gbrangeon-telops/irc_fir-00251-proc/bin/FirmwareReleaseVersion.txt

firmwareVersionMajor=6
firmwareVersionMinor=2
firmwareVersionSubMinor=[SensorCode]
firmwareVersionBuild=0
