gbrangeon-telops/irc_fir-00251-proc/src/AEC/HDL/netlist/hdl_netlist/histogram_axis_tmi.runs/histogram_axis_tmi_blk_mem_gen_v8_1_0_synth_1/.vivado.begin.rst

<?xml version="1.0"?>
<ProcessHandle Version="1" Minor="0">
    <Process Command="vivado.bat" Owner="jboulet" Host="TELOPS182" Pid="135480">
    </Process>
</ProcessHandle>
