gbrangeon-telops/irc_fir-00251-proc/src/FrameBuffer/Doc/PDR - Réducteur de vitesse.pptx

On envisage ici 2 concepts de frame buffers :
Solution A (écriture en continu) : On écrit tous les frames qui arrivent et lorsque tous les slots du buffer sont pleines, on écrase le frame le plus ancien par le plus récent (aucun frame n’est jamais discarté).
- Avantage : Un avantage de cette solution est que la prochaine image affichée est toujours la plus récente sortie par le détecteur. Cet avantage devient perceptible seulement lorsque la vitesse d’écriture est beaucoup plus grande que celle de lecture.
- Désavantage : Un désavantage est qu’on est toujours en train d’écrire, ce qui accroit les besoins en bande passante de DDR et conséquemment la consommation d’énergie.
Solution B (écriture est “stallé” par la lecture) : On écrit tous les frames qui arrivent et lorsque tous les slots du buffer sont pleines, on discarte les nouveaux frames qui arrivent en attendant qu’une slot se libère.
  - Avantage : L’avantage par rapport à la solution A est qu’on prend moins de bande passante en écriture et qu’on consomme moins d’énergie parce que la vitesse de lecture fait “staller” l’écriture des frames.
  - Désavantage : Étant donné que les frames sont flushés lorsque tous les slots sont prises, il est possible d’introduire une latence sur l’affichage “real time” de la sortie video. Cette lantence devient perceptible seulement lorsqu’on est à bas frame rate et que la vitesse de lecture est beaucoup plus lente que celle d’écriture.

Dans le cadre du projet S2K, le frame buffer entre en function seulement lorsqu’on monte à des frame rates supérieur à 1000 Hz. Ce n’est pas grave d’avoir quelques frames de retard sur un preview à 1000 Hz et plus. On a donc choisi d’implementer la solution B afin de minimiser la consummation énergétique.

## Slide 2

Indépendamment de la solution, on considère un frame buffer d’une taille de trois frames. Voici la description d’un cas de figure permettant de constater pourquoi deux frames serait insuffisant :

Frame 0 (100%)

A

A

B

Frame 1 (100%)

B

B

A

Frame 0 (99%)

Le problème arrive lorsque la lecture est légèrement moins rapide que l’écriture.
Il y aura de long temps mort ou la lecture attend après l’écriture, ce qui affectera inutilement le throughput moyen en sortie du réducteur de vitesse.

Frame 2 (0%)

B

A

Frame 0 (1%)

Frame 2 (0%)

B

A

Frame 1 (99%)

Frame 3

A

B

Frame 1 (1%)

La lecture attend pendant presqu’un frame complet

Frame 3

A

B

## Slide 3

Solution A (écriture en continu) : Écriture environ 4x plus rapide que la lecture

Frame 0

Frame 1

Frame 2

Frame 3

Frame 4

Frame 5

Frame 6

Frame 7

Frame 8

Frame 9

Wait for SOF and read completion of current pointed buffer

Writing header and image in current pointed buffer

End of write operation

Update write pointer
and buffer status

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
## Slide 4

Solution B (écriture est “stallé” par la lecture) : Écriture environ 4x plus rapide que la lecture

Frame 0

Frame 1

Frame 2

Frame 3

Frame 4

Frame 5

Frame 6

Frame 7

Frame 8

Frame 9

Wait for SOF and read completion of current pointed buffer

Writing header and image in current pointed buffer

End of write operation

Update write pointer
and buffer status

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
## Slide 5

Interconnect
(Périphérique)

Bus AXI4

Architecture firmware (haut niveau)

µBlaze

Data Mover
(pixel data)

Data Mover
(buffering)

Data Mover
(Réducteurde vitesse)

Bus AXI4

Client 1

Interconnect
(MIG de calibration)

…

…

MM2S CMD (AXI4S, CLK_CAL)

MM2S (AXI4, CLK_CAL, 2720 MB/s)

Client 2

…

MM2S STS (AXI4S, CLK_CAL)

MM2S (AXI4S, CLK_CAL, 2720 MB/s)

…

MM2S CMD (AXI4S, CLK_DATA)

Bus AXI4

…

…

MM2S (AXI4S, CLK_DATA, 170 MB/s)

MM2S STS (AXI4S, CLK_DATA)

MM2S (AXI4, CLK_DATA, 170 MB/s)

Client 3

…

…

S2MM CMD (AXI4S, CLK_DATA)

Bus AXI

MIG
(calibration)

Address bus (15 bits)

Data bus

…

S2MM STS (AXI4S, CLK_DATA)

S2MM (AXI4S, CLK_DATA, 680 MB/s)

S2MM (AXI4, CLK_DATA, 680 MB/s)

Client 4

Réducteur de Vitesse

Storage

MM2S STS (AXI4S, CLK_DATA)

MM2S CMD (AXI4S, CLK_DATA)

MM2S (AXI4, CLK_DATA, 680 MB/s)

Client 5

MM2S (AXI4S, CLK_DATA, 680 MB/s)

DDR 3

Légende

Rouge = Ajout/modification
Bleu = existant

Définition des clocks

CLK_CAL = 170 MHz
CLK_DATA = 85 MHz
CLK_DIN = 142.5 MHz

S2MM STS (AXI4S, CLK_DIN)

S2MM CMD (AXI4S, CLK_DIN)

S2MM (AXI4S, CLK_DIN, 1140 MB/s)

S2MM (AXI4, CLK_DIN, 1140 MB/s)

Client 6

Output

Pixels stream
(AXI4S, CLK_DATA, 340 Mpix/s)

calibration

Pixels stream
(AXI4S, CLK_DATA, 340 Mpix/s)

Pixels stream
(AXI4S, CLK_DATA, 340 Mpix/s)

Pixels stream
(AXI4S, CLK_DIN, 569 Mpix/s)

HDER inserter

Pixels stream
(AXI4S, CLK_DIN, 569 Mpix/s)

Module FPA

mux

Pixels stream
(AXI4S, CLK_DATA, 85 Mpix/s)

Pixels stream
(AXI4S, CLK_DIN, 569 Mpix/s)

Fan out

Pixels stream
(AXI4S, CLK_DIN, 569 Mpix/s)

## Slide 6

Pixel out

Architecture firmware

Frame buffer/Réducteur de vitesse

Frame buffer configuration

Block design

Bus AXI4

µBlaze interface

Image boundaries
detector (SOF/EOF)

Read FSM

Buffers manager

Write FSM

Interconnect
(Peripheral)

Read engine
cmd intf

Write engine
cmd intf

Write engine

Read engine

Data mover

µBlaze

CFG

MM2S STS

MM2S DATA

CDC

Read buffers status

CDC

Update buffers status

CDC

Update RD buffer pointer

MM2S CMD

DDR 3

Data bus

CFG

Update WR buffer pointer

Address bus

CFG

Read buffers status

Update buffers status

S2MM CMD

MIG
(DDR calibration)

Bus AXI

Interconnect
(MIG CAL_DDR)

S2MM STS

Pixels stream

SOF/EOF

Multiple
stages
registers

Hole

Fanout
(pixel, storage)

Pixels stream

Pixels stream

Pixels stream

Pixels stream

WR FIFO

S2MM DATA

S2MM DATA

MM2S DATA

Legend (bus)

AXI4S, CLK_DATA

Legend (clock domain)

CLK_DIN (142.5 MHz)

CLK_DATA (85 MHz)

CLK_MB (100 MHz)

CLK_DDR (400 MHz)

AXI4S, CLK_DIN

AXI4, CLK_DATA

AXI4, CLK_DIN

AXI4, CLK_MB

MIXE
