gbrangeon-telops/irc_fir-00251-proc/bin/FirmwareReleaseList.txt

sensorName,fpgaSize (no spaces)
#are ignored
----------------------------------------------
#blackbird1280D,325
#blackbird1520D,325
#blackbird1920D,325
#calcium640D,325
#hawkA,160
#herculesD,160
isc0207A,160
isc0207A_3k,325
#isc0209A,160
#isc0804A,325
#isc0804A_500Hz,325
#isc0804A_2k,325
#pelicanD,160
#scorpiolwD_230Hz,160
#scorpiomwA,160
#scorpiomwA_300Hz,160
#startup,160
#startup,325
#startup_4DDR,325
#suphawkA,325
#xro3503A,325
