gbrangeon-telops/irc_fir-00251-proc/src/FPA/megalink/Doc/Chronogrammes.docx

Nous empruntons à SCD les chornogrammes suivants. Ils seront utilisés jusqu’à preuve du contraire pour tous les IDDCA numériques.

Ainsi, selon la figure 2 ci-dessus, et selon la doc du détecteur ScorpioLw (figure 5.2 page 15 de NTG018) , on a en mode ITR:

fig2_T4_dly = 2 MCLK (non documenté par Sofradir)

fig2_T6_dly = (6.5 + Ncolumn/4) MCLK pour scorpioLW et 40 MCLK pour Mars

fig2_T5_dly = 50 usec pour scorpioLW et

fig2_T3_dly = FVAL(à confirmer) = Fig4_T3_dly*NLine + Fig4_T4_dly*( NLine - 1)

Pour un ScorpioLW en mode ITR, on a :

Fig4_T1_dly = fig2_T2_dly + fig2_T4_dly + fig2_T6_dly; (pour un Scorpio LW)

Fig4_T2_dly = 0;

Fig4_T3_dly = Ncolumn/Ntaps;

Fig4_T4_dly = 4 MCLK;

Fig4_T5_dly = 0 MCLK (pas de header pour Megalink)

Fig4_T6_dly = 0
