gbrangeon-telops/irc_fir-00251-proc/design note/ElCorr/ElCorr.pdf

## Algorithme du correcteur électronique

Eric Larouche

27 mars 2024

# Table des matières

Bibliographie | 13

### 1 Introduction

Le correcteur électronique est un module firmware qui fut introduit dans le cadre du projet ForrestGump pour le détecteur isc0804A. À cette époque, il fut remarqué que la calibration permanente ne tenait plus adéquatement quand les conditions ambiantes de température changeaient trop pour la caméra M1k. Un effort de développement fut donc mené pour créer une nouvelle fonctionnalité firmware générique qui permet de corriger la drift thermique de l’électronique à l’ordre un : référé dans le firmware comme étant le "correcteur électronique" (ou ElCorr). Le module comporte une flexibilité par conception qui autorise divers modes de fonctionnement. Dans le moment, il est seulement activé concrètement pour le isc0804A (avec correction de gain/offset) et pour le isc0209A dans un sous-mode particulier.

Le module ElCorr s’insère dans le contrôleur générique du flot de données (afpa_data_ctrl) du module FPA, juste avant le traitement multiéchantillons (HPROC) et de la diversité spatiale (VPROC). Pour le reste de la chaîne de traitement de la caméra (calibration), c’est transparent : les données arrivent dans le mode RAW0 déjà corrigées pour la drift thermique.

1

Outre la compensation thermique active, le code du correcteur électronique inclut également la possibilité d’une transformation affine générique pour changement d’échelle de la plage dynamique avec des seuils explicites à viser pour ETmin et ETmax : référé dans le code comme étant les constantes
ELCORR_TARGET_STARVATION_DL et ELCORR_TARGET_SATURATION_DL respecti-
vement.

### 2 Modèle fondamental

L’algorithme de la correction électronique se base sur certaines hypothèses de modélisation raisonnables concernant les caractéristiques de la chaîne analogique de l’électronique instrumentale et l’effet des variations thermiques.

### 1. Hypothèse de linéarité

On suppose que l’électronique analogique pour un tap donné et le processus de conversion ADC peuvent se modéliser par une relation linéaire du type suivant :
y(t) = A(T) · x(t) + B(T)

où x(t) est la valeur de la tension (en mV) qui sort sur le tap au temps t au début de la chaîne analogique (plage native du ROIC), y(t) est la valeur numérique (en DL0) produite par l’ADC après conversion de la tension analoqique en fin de chaîne (dans la plage différentielle adaptée à l’ADC), A(T) et B(T) sont respectivement le gain et l’offset global dépendant de la température actuelle T.

Ce modèle revient donc à négliger toute non-linéarité introduite par l’électronique ou l’ADC mais autorise des variations de gain et d’offset causées par des drifts thermiques. C’est une hypothèse fort raisonnable étant donnée la très bonne linéarité des OpAmp et des convertisseurs ADC.

### 2. Hypothèse de l’existence de références

La deuxième hypothèse concerne la disponibilité de références qui permettent de caractériser l’évolution de la drift thermique pour calculer la correction à appliquer sur les données de pixel. Pour une compensation de gain et d’offset, cela prend deux références en tension sur le ROIC représentatives des perturbations que subiront les données de taps. Le processus qui

2

détermine le niveau nominal de ces références doit être stable en température.

Dans le cas du isc0804A, le niveau de blank peut servir de référence car il est ajustable. La tension est programmée par une paire DAC/LDO très stable en température (5 ppm/K). Une première référence (REF1) est prise durant la période de blank à chaque ligne. La deuxième référence (REF2) consiste en une valeur de DAC alternative programmée seulement au moment de changements de config FPA qui impliquent un stop/start. Le DAC reprend la valeur normale de REF1 dès que la mesure de REF2 est complétée. Ainsi, il y a une mise à jour régulière de REF1 mais plus infréquente pour REF2.

### 2. Hypothèse de lenteur de la dynamique

La troisième hypothèse concerne la lenteur des drifts thermiques. On suppose que la dynamique des effets thermiques est plutôt lente, à l’échelle de plusieurs minutes. C’est la raison pour laquelle on autorise que REF2 soit mesurée infréquemment.

### 3 Algorithme détaillé de correction

L’algorithme de correction qui se base sur les hypothèses de la section précédente utilise plusieurs constantes globales et variables par canal. L’information détaillée suit.

### 1. Constantes et variables

Quatre de ces constantes proviennent des Flash Settings mais peuvent être écrasées par un registre de debug :
ElCorrMeasAtReference1 REF1 mesuré (en DL0) au centre de l’image par la production en conditions de lab.
ElCorrMeasAtReference2 REF2 mesuré (en DL0) au centre de l’image par la production en conditions de lab.
ElCorrMeasAtStarvation Compte de pixel (en DL0) mesuré au centre de l’image par la production en conditions de lab à ETmin. ElCorrMeasAtSaturation Compte de pixel (en DL0) mesuré au centre de l’image par la production en conditions de lab à ETmax.

3

Deux des constantes provienent du code microBlaze et concernent les seuils à viser pour le correcteur électronique (transformation affine après compensation thermique) :
ELCORR_TARGET_STARVATION_DL Seuil à cibler (DL0) à ETmin. ELCORR_TARGET_SATURATION_DL Seuil à cibler (DL0) à ETmax. L’algorithme utilise également trois variables mesurées en temps réel en conditions d’opération "client" pour chaque tap :
Ref1 Valeur actuelle de REF1 (en DL0)
Ref2 Valeur actuelle de REF2 (en DL0)
PixData Valeur actuelle du pixel (en DL0)

### 2. Notation simplifiée

Introduisons une notation simplifiée pour décrire moins lourdement l’implémentation concrète de l’algorithme et l’algèbre qui en découle.
- Y

∗
R1

: constante ElCorrMeasAtRe f erence1
- Y

∗
R2

: constante ElCorrMeasAtRe f erence2
- Yminnom : constante ElCorrMeasAtStarvation
- Ymaxnom : constante ElCorrMeasAtSaturation
- Ymintar : constante ELCORR_TARGET_STARVAT ION_DL
- Ymaxtar : constante ELCORR_TARGET_SATURAT ION_DL
- YR1 : valeur actuelle de REF1 à l’entrée de ElCorr
- YR2 : valeur actuelle de REF2 à l’entrée de ElCorr
- Ypix : valeur actuelle du pixel à l’entrée de ElCorr
- Yout : valeur actuelle du pixel après correction électronique

### 3. Algèbre de l’algorithme

La transformation algébrique de la correction électronique poursuit le double objectif de compenser activement les drifts de gain et d’offset ainsi que de permettre une mise à l’échelle de la plage dynamique de manière arbitaire (selon les consignes des constantes Ymin/maxtar données plus haut). L’équation fondamentale est donnée ci-bas :

Yout =

Y

∗
R1 − Y

∗
R2
YR1 − YR2
·

Ymaxtar − Ymintar
Ymaxnom − Yminnom
- (Ypix − YR1)

−

Ymaxtar − Ymintar
Ymaxnom − Yminnom
- (Ymaxnom − Y

∗
R1

) + Ymaxtar.

(1)

4

Le facteur de la première parenthèse constitue une correction pour la variation de gain. Les offsets sont quant à eux compensés étant donné qu’on calcule des différences de grandeurs mesurées à une seule et même température commune. Le facteur dans la deuxième parenthèse constitue plutôt un redimensionnement d’échelle de la plage dynamique. Les expressions additives assurent qu’on a le bon décalage désiré avec les constantes-cibles données.

Avec cette algèbre, on aura bien Yout = Ymintar à ETmin et Yout = Ymaxtar à ETmax avec compensation de gain/offset.

### 4. Implémentation firmware

L’implémentation firmware est divisée en deux parties. Les calculs de constantes statiques qui ne demandent pas de mesure en temps réel sont faits dans le microBlaze. Plusieurs modes d’opération sont supportés par le firmware. Le code du processeur calcule les bonnes consignes/constantes selon le mode actuel.

La correction électronique proprement dite effectuée en temps réel est plutôt déléguée au datapath se trouvant dans le circuit numérique FPGA. Il traite les pixels selon les consignes d’aiguillage de flot de données et de constantes statiques déterminés par le software microBlaze. Cette flexibilité permet ainsi plusieurs modes d’opération. Notons l’affichage de la REF1 (mode = 1), l’affichage de la REF2 (mode=2), correction d’offset exclusivement (mode=5) et correction de gain/offset (mode=7) tel que décrit dans la mathématique ci-haut.

Pour la correction active, le processeur fournit à la partie FPGA une constante multiplicative et une constante additive calculées ainsi :

Again = (Y

∗
R1 − Y

∗
R2

) ·

Ymaxtar − Ymintar
Ymaxnom − Yminnom

Ao f f s = Ymaxtar − Again ·

Ymaxnom − Y

∗
R1
Y

∗
R1 − Y

∗
R2

Le datapath implémente les opérations arithmétiques nécessaires : soustraction, addition, multiplication et division. Les données initiales en provenance de l’ADC se trouvent en format point-fixe de 18-bits. La multiplication

5

génère un résultat sur une précision double : 36-bits. La division produit quant à elle un quotient sur 18-bits (dividende=36-bits, diviseur=18-bits). Chaque opérateur traite un lot de 4 pixels en parallèle (données en provenance d’un quad ADC).

La structure précise du datapath se présente ainsi :

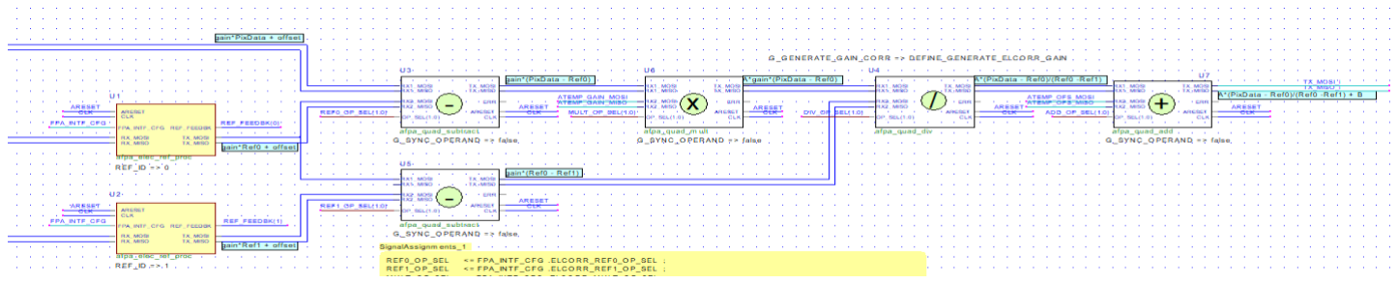
[picture p5: figure]

FIGURE 1 – Datapath

Dans le mode d’opération normal (ELCORR_MODE_OFFSET_AND_GAIN_CORR), le datapath calcule donc l’expression suivante :

Yout = Again ·

Ypix − YR1

YR1 − YR2

+ Ao f f s

Pour plus de flexibilité, les opérateurs du datapath reçoivent un sélecteur d’aiguillage en provenance du processeur qui permet d’implémenter plusieurs modes de calcul différents. Outre le mode normal actif (l’opérateur effectue l’opération mathématique native), on peut sélectionner un mode passage transparent de l’opérande 1 ou passage de l’opérande 2.

Ainsi, avec la bonne configuration appropriée, on peut demander par exemple au correcteur électronique de passer vers la sortie la REF1 ou la REF2 de manière transparente sans transformation afin de debug. (Cela
correspond aux modes ELCORR_MODE_REF1_IMG et ELCORR_MODE_REF2_IMG
respectivement.)

### 5. Analyse de la propagation d’incertitude

Dans cette sous-section, nous analysons la propagation de l’incertitude causée par l’algorithme de la correction électronique et l’impact du changement du niveau nominal de blank (projet M2kUD).

6

Loi de propagation de l’incertitude Rappelons ici la loi de propagation de l’incertitude d’un mesurande Y de sortie qui dépend de plusieurs autres quantitées Xi selon une relation fonctionnelle déterminée (refs [1], [2] et [3]).

Étant donnée la relation fonctionnelle suivante entre les mesurandes :

Y = f(X1, X2, . . . , XN),

un estimé de la mesure de sortie y est obtenu par substitution direct des estimés des variables d’entrée xi pour les mesurandes Xi
:

y = f(x1, x2, . . . , xn).

Dans ce cas, l’incertitude sur le résultat de sortie u(y) se propagera selon la loi suivante :

u

2
(y) =

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
(xi) + 2

N−1
∑

i=1

N
∑

j=i+1

∂ f
∂xi

∂ f
∂xj

u(xi

, xj),

où u(xi) est l’estimé d’incertitude associé à l’entrée xi et u(xi

, xj) est l’estimé
de covariance associé au couple d’entrées xi et xj

Dans notre cas, il est raisonnable de supposer qu’il n’y a pas de corrélation entre les différentes variables d’entrée (PixData et les différents REFs) comme l’incertitude de mesure est surtout causée par du bruit électronique blanc additionné d’un bruit de quantification de conversion ADC.

Avec cette hypothèse simplificatrice, la loi de propagation de l’incertitude peut se réécrire ainsi :

u(y) =

vuut
N
∑

i=1

∂ f
∂xi

2
u
2(xi). | (2)

Facteurs de sensibilité Il faut appliquer cette loi à l’équation (1) pour obtenir l’erreur en sortie du correcteur électronique. Pour ce faire, il reste à déterminer les différents facteurs de sensibilité ∂ f
∂xi

qui découle de l’équa-

7

tion (1). Après calculs symboliques appropriés, nous obtenons :

∂Yout
∂Y

∗
R1

=

Ymaxtar − Ymintar
Ymaxnom − Yminnom
·

Ypix − YR2

YR1 − YR2

∂Yout
∂Y

∗
R2

= −

Ymaxtar − Ymintar
Ymaxnom − Yminnom
·

Ypix − YR1

YR1 − YR2

∂Yout

∂YR1

= −

Ymaxtar − Ymintar
Ymaxnom − Yminnom
·
Y

∗
R1 − Y

∗
R2
(YR1 − YR2)

2

- (Ypix − YR2)

∂Yout

∂YR2

=

Ymaxtar − Ymintar
Ymaxnom − Yminnom
·
Y

∗
R1 − Y

∗
R2
(YR1 − YR2)

2

- (Ypix − YR1)

∂Yout
∂Yminnom

= −

Ymaxtar − Ymintar
(Ymaxnom − Yminnom)

2

- (Ymaxnom − Y

∗
R1

)

+

Ymaxtar − Ymintar
(Ymaxnom − Yminnom)

2

·
Y

∗
R1 − Y

∗
R2
YR1 − YR2
- (Ypix − YR1)

∂Yout
∂Ymaxnom

= −

Ymaxtar − Ymintar
Ymaxnom − Yminnom

+

Ymaxtar − Ymintar
(Ymaxnom − Yminnom)

2

- (Ymaxnom − Y

∗
R1

)

−

Ymaxtar − Ymintar
(Ymaxnom − Yminnom)

2

·
Y

∗
R1 − Y

∗
R2
YR1 − YR2
- (Ypix − YR1)

∂Yout
∂Ypix =
Y

∗
R1 − Y

∗
R2
YR1 − YR2
·

Ymaxtar − Ymintar
Ymaxnom − Yminnom

Évaluation quantitative Avec ces expressions en main, on peut procéder à l’évaluation quantitative. Pour les données de pixels, nous connaissons déjà l’incertitude de notre chaîne analogique : 1.7 DL0 (rms). Les mesures nominales de pixel à ETmin et ETmax peuvent être moyennées sur plusieurs images avec une séquence. Le script standard GSY utilise 64 images comme compte. Concernant les mesures des références, il faut tenir compte du fait que le correcteur électronique applique une moyenne mobile sur 120 échantillons. L’incertitude pour celles-ci se réduira donc selon la loi de 1/√
N.

Caméra M1k Évaluation d’abord la caméra M1k standard qui constitue le cas de baseline. Nous avons pour les incertitudes d’entrées :

u(Ypix) = 1.7 DL0,

8

u(Yminnom) = u(Ymaxnom) = 1.7 DL0
√
64

= 0.21 DL0,

u(YR1) = u(YR1) = u(Y

∗
R2

) = u(Y

∗
R2

) = 1.7 DL0
√
120

= 0.16 DL0.

Pour Ymintar et Ymaxtar, il n’y a pas d’incertitude car ce sont des constantes fixes de design. Pour les différents paramètres, considérons les valeurs typiques suivantes :
Y

∗
R1 ≈ YR1 ≈ 7800 DL0,

Y

∗
R2 ≈ YR2 ≈ 400 DL0,

Yminnom ≈ 1300 DL0,

Ymaxnom ≈ 15 500 DL0,

Ymintar = 650 DL0 (par design),

Ymaxtar = 16 000 DL0 (par design),

Ypix = 15 500 DL0 (pire cas),

L’évaluation des facteurs de sensibilité donne :

∂Yout
∂Y

∗
R1

= 2.21, ∂Yout
∂Y

∗
R2

= −1.12, ∂Yout

∂YR1

= −2.21, ∂Yout

∂YR2

= 1.13,

∂Yout
∂Yminnom

= −1.11 × 10⁻¹⁶
,

∂Yout
∂Ymaxnom

= −1.08, ∂Yout ∂Ypix = 1.08.

En remplaçant les différentes valeurs dans l’équation (2), nous obtenons l’incertitude finale dans le pire cas (Ypix = 15500) :

u = 1.9 DL0.

Il rest intéressant de faire un graphe de l’évolution de l’incertitude sur toute la plage dynamique des pixels. On peut constater (voir fig. 2) qu’elle demeure autour de 1.9 DL0.

9


FIGURE 2 – Évolution de l’incertitude pour la caméra M1k

Caméra M2kUD Évaluons ici les quantités équivalentes pour la caméra M2kUD. Nous avons pour les incertitudes d’entrées :

u(Ypix) = 1.7 DL0,

u(Yminnom) = u(Ymaxnom) = 1.7 DL0
√
64

= 0.21 DL0,

u(YR1) = u(YR1) = u(Y

∗
R2

) = u(Y

∗
R2

) = 1.7 DL0
√
120

= 0.16 DL0.

Pour les différents paramètres M2kUD, nous avons les valeurs typiques suivantes :
Y

∗
R1 ≈ YR1 ≈ 4200 DL0,

Y

∗
R2 ≈ YR2 ≈ 400 DL0,

Yminnom ≈ 1300 DL0,

Ymaxnom ≈ 15 500 DL0,

Ymintar = 650 DL0 (par design),

Ymaxtar = 16 000 DL0 (par design),

Ypix = 8191 DL0 (pire cas),

10

Le projet M2kUD a introduit un changement de la référence 1 qui constitue le nouveau niveau de blank. Également, un module d’écrétage fut ajouté, ce qui implique que le pixel à saturation se situera maintneant à la demie-plage (8191 DL0).

L’évaluation des facteurs de sensibilité de M2kUD donne :

∂Yout
∂Y

∗
R1

= 2.22, ∂Yout
∂Y

∗
R2

= −1.14, ∂Yout

∂YR1

= −2.22, ∂Yout

∂YR2

= 1.14

∂Yout
∂Yminnom

= −0.556, ∂Yout
∂Ymaxnom

= −0.525, ∂Yout
∂Ypix = 1.08.

En remplaçant les différentes valeurs dans l’équation (2), nous obtenons l’incertitude finale dans le pire cas (Ypix = 8191) :

u = 1.9 DL0.

Nous pouvons afficher l’évolution de l’erreur pour la caméra M2kUD (voir fig. 3). Nous constatons encore une fois que l’inceritude demeure autour de 1.9 DL0. Il n’y a donc pas de dégradation significative de l’incertitude. Le déplacement de REF1 semble donc compensé par le fait que les pixels qui arrivent auront également un range dynamique diminué.

L’évaluation de l’inceritude pour un pixel pleine plage brute (Ypix = 15 500 DL0) montre effectivement une erreur théorique acrrue : u = 2.2 DL0. Mais cette situation n’arrivera pas en pratique comme l’écrêteur va forcer le client à ramener le ET à la demie-plage pour éviter des saturations ou sinon ces pixels seraient écrêtés de toute manière.

11


FIGURE 3 – Évolution de l’incertitude pour la caméra M2kUD

### 4 Conclusion

Le correcteur électronique est un module firmware fort utile qui a rendu possible les produits M1k, V500 et M2kUD. Avec sa grande versatilité, il pourra certainement servir pour d’autres détecteurs qui auront besoin d’une compensation active.

12

# Bibliographie

[1] Barry N. Taylor and Chris E. Kuyatt, Guidelines for Evaluating and Expressing the Uncertainty of NIST Measurement Results, NIST Technical Note 1297, 1994 Edition, Gaithersburg, MD, 1994.
[2] European Accreditation Laboratory Committee, Evaluation of the Uncertainty of Measurement in Calibration, EA-4/02 Technical Publication, 2013 Edition, Europe, 2013.
[3] John R. Taylor, Introduction to Error Analysis : The Study of Uncertainties in Physical Measurements, University Science Books, Melville, NY, 2nd Edition, 1997.

13
