gbrangeon-telops/irc_fir-00251-proc/src/Buffering/Docs/test_result.xlsx

 | Paramètre |  |  |  |  |  |  |  |  |  | Expected Result |  |  |  | Actual Result
Test | F_Width | F_Heigth | Nb_img_seq | Nb_seq | Pre_moi | Post_moi | Moi Loc | M position |  | Acq Stop Loc | Start_Loc | Moi Loc | End Loc | Seq ID | Start_Loc | Moi Loc | End Loc | Seq ID
#1 | 64 | 6 | 10 | 4 | 5 | 5 | 5 Frame | 5 | 12us | - | 0 | 5 | 9 | 0 | 0 | 5 | 9 | 0 | k
#2 | 64 | 6 | 10 | 4 | 5 | 5 | 3 Frame | 13 | 22us | - | 0 | 3 | 9 | 1 | 0 | 3 | 9 | 1 | k
#3 | 64 | 6 | 10 | 4 | 5 | 5 | 12 Frame | 30 | 45us | - | 7 | 2 | 6 | 2 | 7 | 2 | 6 | 2 | k
#4 | 64 | 6 | 10 | 4 | 5 | 5 | - | - | - | 1 | - | - | - | - | - | - | - | - | k
#5 | 64 | 6 | 10 | 4 | 5 | 5 | - |  | 52us | 1 | - | - | - | - | 3 | 8 | 1 | 3 | k
#6 | 64 | 6 | 10 | 4 | 0 | 10 | 0 | 0 | 6.4us | - | 0 | 0 | 9 | 0 | 0 | 0 | 9 | 0 | k
#7 | 64 | 6 | 10 | 4 | 0 | 10 | 4 |  | 22.8us |  | 0 | 0 | 9 | 1 | 4 | 4 | 3 | 1 | k
#8 | 64 | 6 | 10 | 4 | 9 | 1 | 5 |  | 12us |  | 0 | 5 | 9 | 0 | 0 | 5 | 9 | 0 | k
#9 | 64 | 6 | 10 | 4 | 9 | 1 | x frame |  | 22us |  | 3 | 2 | 2 | 1 | 3 | 2 | 2 | 1 | k
#10 | 64 | 6 | 10 | 2 | 2 | 8
#11 | 64 | 6 | 10 | 2 | 2 | 8
#12 | 64 | 6 | 10 | 2 | 2 | 8 |  |  |  |  | - | - | - | -
#13
#14
#15
