gbrangeon-telops/irc_fir-00251-proc/src/Calibration/Doc/CAL_status_decode.xlsm

Register | Error hex | Bit # | Error | Description | Bit # | Error | Description | Bit # | Error | Description | Bit # | Error | Description | Bit # | Error | Description
cal.error_set[0] | 00000000 | 0 | 0 | Saturation param fifo overflow (U45) | 32 | 0 | NLC/U15/U2 lut_factor_inv_err overflow | 64 | 0 | FSU/subtract (kappa+beta0) N/A (U2/U1) | 96 | 0 | RQC/add (B) sync error (U4/U8) | 128 | 0 | FCC/mult (NUC factor) N/A (U1/U2)
cal.error_set[1] | 00000000 | 1 | 0 | Pixel saturation flag error (U39) | 33 | 0 | NLC/U15/U2 lut_factor_err overflow | 65 | 0 | FSU/subtract (kappa+beta0) sync error (U2/U1) | 97 | 0 | RQC/lut_page_param_fifo (U4/U10) | 129 | 0 | FCC/mult (NUC factor) sync error (U1/U2)
cal.error_set[2] | 00000000 | 2 | 0 | NLC/subtract (offset) underflow (U3/U1) | 34 | 0 | NLC/U15/U2 lut_end_add_err overflow | 66 | 0 | FSU/add (alpha_offset) underflow (U2/U18) | 98 | 0 | RQC/pow2_m_exp_param_fifo (U4/U1) | 130 | 0 | FCC/exp_time_param_fifo (U1/U14)
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
