gbrangeon-telops/irc_fir-00251-proc/src/AEC/HDL/netlist/hdl_netlist/histogram_axis_tmi.srcs/sources_1/ip/histogram_axis_tmi_c_addsub_v12_0_0/doc/c_addsub_v12_0_changelog.txt

2013.4:
 * Version 12.0 (Rev. 3)
 * Latency is now restricted to the output width. Previously the GUI allowed illegal values
 * Tooltips added to GUI
 * Support for Kintex Ultrascale devices at Pre-Production Status

2013.3:
 * Version 12.0 (Rev. 2)
 * Behavioral VHDL model replaced by Encrypted RTL. For more information on this change please refer to the Migrating and Upgrading section in the Product Guide
 * Internal standardization in source file delivery, does not change behavior
 * Support for Automotive Artix-7, Automotive Zynq, Defense Grade Artix-7, Defense Grade Zynq and Lower Power Artix-7 devices at Production Status
 * Added default constraints for out of context flow
 * Added support for IP Integrator
 * Added support for Cadence IES and Synopsys VCS simulators

2013.2:
 * Version 12.0 (Rev. 1)
 * Support for Series 7 devices at Production status
 * Updated clock and bus interface associations for IP Integrator support
 * Removing support for Defense Grade Low Power Artix7

2013.1:
 * Version 12.0
 * Native Vivado Release
 * Changed all port names to upper case
 * There have been no functional changes to this IP.  The version number has changed to support unique versioning in Vivado starting with 2013.1.

(c) Copyright 2002 - 2013 Xilinx, Inc. All rights reserved.

This file contains confidential and proprietary information
of Xilinx, Inc. and is protected under U.S. and
international copyright and other intellectual property
laws.

DISCLAIMER
This disclaimer is not a license and does not grant any
rights to the materials distributed herewith. Except as
otherwise provided in a valid license issued to you by
Xilinx, and to the maximum extent permitted by applicable
law: (1) THESE MATERIALS ARE MADE AVAILABLE "AS IS" AND
WITH ALL FAULTS, AND XILINX HEREBY DISCLAIMS ALL WARRANTIES
AND CONDITIONS, EXPRESS, IMPLIED, OR STATUTORY, INCLUDING
BUT NOT LIMITED TO WARRANTIES OF MERCHANTABILITY, NON-
INFRINGEMENT, OR FITNESS FOR ANY PARTICULAR PURPOSE; and
(2) Xilinx shall not be liable (whether in contract or tort,
including negligence, or under any other theory of
liability) for any loss or damage of any kind or nature
related to, arising under or in connection with these
materials, including for any direct, or any indirect,
special, incidental, or consequential loss or damage
(including loss of data, profits, goodwill, or any type of
loss or damage suffered as a result of any action brought
by a third party) even if such damage or loss was
reasonably foreseeable or Xilinx had been advised of the
possibility of the same.

CRITICAL APPLICATIONS
Xilinx products are not designed or intended to be fail-
safe, or for use in any application requiring fail-safe
performance, such as life-support or safety devices or
systems, Class III medical devices, nuclear facilities,
applications related to the deployment of airbags, or any
other applications that could lead to death, personal
injury, or severe property or environmental damage
(individually and collectively, "Critical
Applications"). Customer assumes the sole risk and
liability of any use of Xilinx products in Critical
Applications, subject only to applicable laws and
regulations governing limitations on product liability.

THIS COPYRIGHT NOTICE AND DISCLAIMER MUST BE RETAINED AS
PART OF THIS FILE AT ALL TIMES.
