gbrangeon-telops/irc_fir-00251-proc/aldec/compile.cfg

[View]
Entity=
Architecture=
TopLevelType=
[file:.\compile\fir_00251_top.vhd]
Generated=TRUE
[file:.\compile\mgt_block.vhd]
Generated=TRUE
Enabled=1
[file:.\compile\mgt_wrapper.vhd]
Generated=TRUE
Enabled=1
[file:.\compile\serdes_top_3ch.vhd]
Generated=TRUE
[file:.\compile\USB_CTRL.vhd]
Generated=TRUE
Enabled=1
[file:.\compile\FPGA_COMM.vhd]
Generated=TRUE
[file:.\compile\data_mgt_tb.vhd]
Generated=TRUE
[file:.\compile\AXI4_Stream32_to_64_tb.vhd]
Generated=TRUE
[file:.\..\..\FIR-00251-Common\VHDL\tel2000pkg.vhd]
Enabled=1
[file:.\..\src\mgt\Hdl\data_mgt_cdc_sync_exdes.vhd]
Enabled=1
[file:.\..\src\mgt\Hdl\data_mgt_clock_module.vhd]
Enabled=1
[file:.\..\src\mgt\Hdl\data_mgt_gt_common_wrapper.vhd]
Enabled=1
[file:.\..\src\mgt\Hdl\data_mgt_support_reset_logic.vhd]
Enabled=1
[file:.\..\src\mgt\Hdl\exp_mgt_cdc_sync_exdes.vhd]
Enabled=1
[file:.\..\src\mgt\Hdl\exp_mgt_clock_module.vhd]
Enabled=1
[file:.\..\src\mgt\Hdl\exp_mgt_gt_common_wrapper.vhd]
Enabled=1
[file:.\..\src\mgt\Hdl\exp_mgt_support_reset_logic.vhd]
Enabled=1
[file:.\..\src\mgt\Hdl\mgt_ctrl.vhd]
Enabled=1
[file:.\..\src\mgt\Hdl\mgt_block.bde]
Enabled=1
[file:.\..\..\FIR-00251-Common\VHDL\MGT\Hdl\compile_data_mgt_rtl.do]
Enabled=1
[file:.\..\..\FIR-00251-Common\VHDL\MGT\Hdl\compile_exp_mgt_rtl.do]
Enabled=1
[file:.\..\..\FIR-00251-Common\VHDL\MGT\Hdl\compile_video_mgt_rtl.do]
Enabled=1
[file:.\..\..\FIR-00251-Common\VHDL\MGT\Hdl\data_mgt_cdc_sync_exdes.vhd]
Enabled=1
[file:.\..\..\FIR-00251-Common\VHDL\MGT\Hdl\data_mgt_clock_module.vhd]
Enabled=1
[file:.\..\..\FIR-00251-Common\VHDL\MGT\Hdl\data_mgt_gt_common_wrapper.vhd]
Enabled=1
[file:.\..\..\FIR-00251-Common\VHDL\MGT\Hdl\data_mgt_support_reset_logic.vhd]
Enabled=1
[file:.\..\..\FIR-00251-Common\VHDL\MGT\Hdl\exp_mgt_cdc_sync_exdes.vhd]
Enabled=1
[file:.\..\..\FIR-00251-Common\VHDL\MGT\Hdl\exp_mgt_clock_module.vhd]
Enabled=1
[file:.\..\..\FIR-00251-Common\VHDL\MGT\Hdl\exp_mgt_gt_common_wrapper.vhd]
Enabled=1
[file:.\..\..\FIR-00251-Common\VHDL\MGT\Hdl\exp_mgt_support_reset_logic.vhd]
Enabled=1
[file:.\..\..\FIR-00251-Common\VHDL\MGT\Hdl\mgt_block.bde]
Enabled=1
[file:.\..\..\FIR-00251-Common\VHDL\MGT\Hdl\mgt_ctrl.vhd]
Enabled=1
[file:.\..\..\FIR-00251-Common\VHDL\MGT\Hdl\mgt_wrapper.bde]
Enabled=1
[file:.\..\..\FIR-00251-Common\VHDL\IP\AXI4_Stream32_to_64\AXI4_Stream32_to_64_funcsim.vhdl]
Enabled=1
[file:.\..\..\FIR-00251-Common\VHDL\IP\AXI4_Stream32_to_64\AXI4_Stream32_to_64_wrapper.vhd]
Enabled=1
[file:.\..\..\FIR-00251-Common\VHDL\IP\AXI4_Stream64_to_32\AXI4_Stream64_to_32_wrapper.vhd]
Enabled=1
[file:.\..\..\FIR-00251-Common\VHDL\IP\AXI4_Stream64_to_32\AXI4_Stream64_to_32_funcsim.vhdl]
Enabled=1
[file:.\src\Testbench\IP\AXI4_Stream64_to_32\AXI4_Stream64_to_32_runtest.do]
Enabled=1
[file:.\src\Testbench\IP\AXI4_Stream64_to_32\AXI4_Stream64_to_32_stim.vhd]
Enabled=1
[file:.\src\Testbench\IP\AXI4_Stream64_to_32\AXI4_Stream64_to_32_tb.bde]
Enabled=1
[file:.\src\Testbench\IP\AXI4_Stream64_to_32\AXI4_Stream64_to_32_wave.do]
Enabled=1
[file:.\compile\AXI4_Stream64_to_32_tb.vhd]
Generated=TRUE
Enabled=1
[file:.\src\Testbench\IP\MGT_wrapper\mgt_wrapper_stim.vhd]
Enabled=1
[file:.\src\Testbench\IP\MGT_wrapper\MGT_WRAPPER_TB.bde]
Enabled=1
[file:.\compile\MGT_WRAPPER_TB.vhd]
Generated=TRUE
Enabled=1
[file:.\..\..\FIR-00251-Common\VHDL\MGT\Hdl\compile_mgt_wrapper.do]
Enabled=1
[file:.\..\IP\AXI4_Stream32_to_64\AXI4_Stream32_to_64_funcsim.vhdl]
Enabled=1
[file:.\..\src\BD\bd_wrapper.vhd]
Enabled=1
[file:.\..\xilinx\fir_0251_Proc.srcs\sources_1\bd\core\hdl\core_wrapper.vhd]
Enabled=1
[file:.\..\xilinx\fir_0251_Proc.srcs\sources_1\bd\core\hdl\core.vhd]
Enabled=1
[file:.\..\xilinx\fir_0251_Proc.srcs\sources_1\bd\core\ip\core_auto_cc_2\sim\core_auto_cc_2.v]
Enabled=1
[file:.\..\xilinx\fir_0251_Proc.srcs\sources_1\bd\core\ip\core_axi_protocol_converter_0_0\sim\core_axi_protocol_converter_0_0.v]
Enabled=1
[file:.\..\xilinx\fir_0251_Proc.srcs\sources_1\bd\core\ip\core_axi_protocol_converter_1_1\sim\core_axi_protocol_converter_1_1.v]
Enabled=1
[file:.\..\xilinx\fir_0251_Proc.srcs\sources_1\bd\core\ip\core_axi_protocol_converter_2_2\sim\core_axi_protocol_converter_2_2.v]
Enabled=1
[file:.\..\xilinx\fir_0251_Proc.srcs\sources_1\bd\core\ip\core_axi_protocol_converter_3_3\sim\core_axi_protocol_converter_3_3.v]
Enabled=1
[file:.\..\xilinx\fir_0251_Proc.srcs\sources_1\bd\core\ip\core_axi_protocol_converter_4_4\sim\core_axi_protocol_converter_4_4.v]
Enabled=1
[file:.\..\xilinx\fir_0251_Proc.srcs\sources_1\bd\core\ip\core_axi_protocol_converter_5_5\sim\core_axi_protocol_converter_5_5.v]
Enabled=1
[file:.\..\xilinx\fir_0251_Proc.srcs\sources_1\bd\core\ip\core_axi_protocol_converter_6_6\sim\core_axi_protocol_converter_6_6.v]
Enabled=1
[file:.\..\xilinx\fir_0251_Proc.srcs\sources_1\bd\core\ip\core_axi_protocol_converter_7_7\sim\core_axi_protocol_converter_7_7.v]
Enabled=1
[file:.\..\xilinx\fir_0251_Proc.srcs\sources_1\bd\core\ip\core_axi_protocol_converter_8_8\sim\core_axi_protocol_converter_8_8.v]
Enabled=1
[file:.\..\xilinx\fir_0251_Proc.srcs\sources_1\bd\core\ip\core_auto_cc_3\sim\core_auto_cc_3.v]
Enabled=1
[file:.\..\xilinx\fir_0251_Proc.srcs\sources_1\bd\core\ip\core_auto_pc_18\sim\core_auto_pc_18.v]
Enabled=1
[file:.\..\xilinx\fir_0251_Proc.srcs\sources_1\bd\core\ip\core_auto_pc_19\sim\core_auto_pc_19.v]
Enabled=1
[file:.\..\xilinx\fir_0251_Proc.srcs\sources_1\bd\core\ip\core_auto_pc_20\sim\core_auto_pc_20.v]
Enabled=1
[file:.\..\xilinx\fir_0251_Proc.srcs\sources_1\bd\core\ip\core_auto_pc_21\sim\core_auto_pc_21.v]
Enabled=1
[file:.\..\xilinx\fir_0251_Proc.srcs\sources_1\bd\core\ip\core_auto_pc_22\sim\core_auto_pc_22.v]
Enabled=1
[file:.\..\xilinx\fir_0251_Proc.srcs\sources_1\bd\core\ip\core_auto_pc_23\sim\core_auto_pc_23.v]
Enabled=1
[file:.\..\xilinx\fir_0251_Proc.srcs\sources_1\bd\core\ip\core_dlmb_bram_if_cntlr_0\sim\core_dlmb_bram_if_cntlr_0.vhd]
Enabled=1
[file:.\..\xilinx\fir_0251_Proc.srcs\sources_1\bd\core\ip\core_dlmb_v10_0\sim\core_dlmb_v10_0.vhd]
Enabled=1
[file:.\..\xilinx\fir_0251_Proc.srcs\sources_1\bd\core\ip\core_ilmb_bram_if_cntlr_1\sim\core_ilmb_bram_if_cntlr_1.vhd]
Enabled=1
[file:.\..\xilinx\fir_0251_Proc.srcs\sources_1\bd\core\ip\core_ilmb_v10_1\sim\core_ilmb_v10_1.vhd]
Enabled=1
[file:.\..\xilinx\fir_0251_Proc.srcs\sources_1\bd\core\ip\core_lmb_bram_0\sim\core_lmb_bram_0.vhd]
Enabled=1
[file:.\..\xilinx\fir_0251_Proc.srcs\sources_1\bd\core\ip\core_auto_pc_17\sim\core_auto_pc_17.v]
Enabled=1
[file:.\..\xilinx\fir_0251_Proc.srcs\sources_1\bd\core\ip\core_auto_pc_24\sim\core_auto_pc_24.v]
Enabled=1
[file:.\..\xilinx\fir_0251_Proc.srcs\sources_1\bd\core\ip\core_auto_us_5\sim\core_auto_us_5.v]
Enabled=1
[file:.\..\xilinx\fir_0251_Proc.srcs\sources_1\bd\core\ip\core_auto_us_8\sim\core_auto_us_8.v]
Enabled=1
[file:.\..\xilinx\fir_0251_Proc.srcs\sources_1\bd\core\ip\core_auto_us_6\sim\core_auto_us_6.v]
Enabled=1
[file:.\..\xilinx\fir_0251_Proc.srcs\sources_1\bd\core\ip\core_auto_us_9\sim\core_auto_us_9.v]
Enabled=1
[file:.\..\xilinx\fir_0251_Proc.srcs\sources_1\bd\core\ip\core_auto_us_7\sim\core_auto_us_7.v]
Enabled=1
[file:.\..\xilinx\fir_0251_Proc.srcs\sources_1\bd\core\ip\core_mdm_1_0\sim\core_mdm_1_0.vhd]
Enabled=1
[file:.\..\xilinx\fir_0251_Proc.srcs\sources_1\bd\core\ip\core_microblaze_1_0\sim\core_microblaze_1_0.vhd]
Enabled=1
[file:.\..\xilinx\fir_0251_Proc.srcs\sources_1\bd\core\ip\core_microblaze_1_axi_intc_0\sim\core_microblaze_1_axi_intc_0.vhd]
Enabled=1
[file:.\..\xilinx\fir_0251_Proc.srcs\sources_1\bd\core\ip\core_xbar_0\sim\core_xbar_0.v]
Enabled=1
[file:.\..\xilinx\fir_0251_Proc.srcs\sources_1\bd\core\ip\core_xbar_1\sim\core_xbar_1.v]
Enabled=1
[file:.\..\xilinx\fir_0251_Proc.srcs\sources_1\bd\core\ip\core_xbar_2\sim\core_xbar_2.v]
Enabled=1
[file:.\..\xilinx\fir_0251_Proc.srcs\sources_1\bd\core\ip\core_xbar_3\sim\core_xbar_3.v]
Enabled=1
[file:.\..\xilinx\fir_0251_Proc.srcs\sources_1\bd\core\ip\core_VCC_0\sim\core_VCC_0.vhd]
Enabled=1
[file:.\..\xilinx\fir_0251_Proc.srcs\sources_1\bd\core\ip\core_axi_gpio_0_0\sim\core_axi_gpio_0_0.vhd]
Enabled=1
[file:.\..\xilinx\fir_0251_Proc.srcs\sources_1\bd\core\ip\core_axi_timer_0_0\sim\core_axi_timer_0_0.vhd]
Enabled=1
[file:.\..\xilinx\fir_0251_Proc.srcs\sources_1\bd\core\ip\core_axi_usb_uart_0\sim\core_axi_usb_uart_0.vhd]
Enabled=1
[file:.\..\xilinx\fir_0251_Proc.srcs\sources_1\bd\core\ip\core_clink_uart_1\sim\core_clink_uart_1.vhd]
Enabled=1
[file:.\..\xilinx\fir_0251_Proc.srcs\sources_1\bd\core\ip\core_clk_wiz_1_0\core_clk_wiz_1_0.vhd]
Enabled=1
[file:.\..\xilinx\fir_0251_Proc.srcs\sources_1\bd\core\ip\core_fpga_output_uart_2\sim\core_fpga_output_uart_2.vhd]
Enabled=1
[file:.\..\xilinx\fir_0251_Proc.srcs\sources_1\bd\core\ip\core_intr_concact_0\sim\core_intr_concact_0.vhd]
Enabled=1
[file:.\..\xilinx\fir_0251_Proc.srcs\sources_1\bd\core\ip\core_mig_7series_0_0\core_mig_7series_0_0\user_design\rtl\core_mig_7series_0_0_sim.v]
Enabled=1
[file:.\..\xilinx\fir_0251_Proc.srcs\sources_1\bd\core\ip\core_oem_uart_3\sim\core_oem_uart_3.vhd]
Enabled=1
[file:.\..\xilinx\fir_0251_Proc.srcs\sources_1\bd\core\ip\core_pleora_uart_4\sim\core_pleora_uart_4.vhd]
Enabled=1
[file:.\..\xilinx\fir_0251_Proc.srcs\sources_1\bd\core\ip\core_proc_sys_reset_1_0\sim\core_proc_sys_reset_1_0.vhd]
Enabled=1
[file:.\..\xilinx\fir_0251_Proc.srcs\sources_1\bd\core\ip\core_xadc_wiz_1_0\core_xadc_wiz_1_0.vhd]
Enabled=1
[file:.\..\xilinx\fir_0251_Proc.srcs\sources_1\bd\core\ip\core_clk_wiz_1_0\core_clk_wiz_1_0_clk_wiz.vhd]
Enabled=1
[file:.\..\xilinx\fir_0251_Proc.srcs\sources_1\bd\core\ip\core_xadc_wiz_1_0\core_xadc_wiz_1_0_axi_xadc.vhd]
Enabled=1
[file:.\..\xilinx\fir_0251_Proc.srcs\sources_1\bd\core\ip\core_dlmb_bram_if_cntlr_0\lmb_bram_if_cntlr_v4_0\hdl\vhdl\lmb_bram_if_cntlr.vhd]
Enabled=1
[file:.\..\xilinx\fir_0251_Proc.srcs\sources_1\bd\core\ip\core_dlmb_v10_0\lmb_v10_v3_0\hdl\vhdl\lmb_v10.vhd]
Enabled=1
[file:.\..\xilinx\fir_0251_Proc.srcs\sources_1\bd\core\ip\core_dlmb_bram_if_cntlr_0\lmb_bram_if_cntlr_v4_0\hdl\vhdl\lmb_bram_if_funcs.vhd]
Enabled=1
[file:.\..\xilinx\fir_0251_Proc.srcs\sources_1\bd\core\ip\core_dlmb_bram_if_cntlr_0\synth\core_dlmb_bram_if_cntlr_0.vhd]
Enabled=1
[file:.\..\xilinx\fir_0251_Proc.srcs\sources_1\bd\core\ip\core_dlmb_bram_if_cntlr_0\lmb_bram_if_cntlr_v4_0\hdl\vhdl\axi_interface.vhd]
Enabled=1
[file:.\..\xilinx\fir_0251_Proc.srcs\sources_1\bd\core\ip\core_dlmb_bram_if_cntlr_0\lmb_bram_if_cntlr_v4_0\hdl\vhdl\checkbit_handler.vhd]
Enabled=1
[file:.\..\xilinx\fir_0251_Proc.srcs\sources_1\bd\core\ip\core_dlmb_bram_if_cntlr_0\lmb_bram_if_cntlr_v4_0\hdl\vhdl\correct_one_bit.vhd]
Enabled=1
[file:.\..\xilinx\fir_0251_Proc.srcs\sources_1\bd\core\ip\core_dlmb_bram_if_cntlr_0\lmb_bram_if_cntlr_v4_0\hdl\vhdl\lmb_mux.vhd]
Enabled=1
[file:.\..\xilinx\fir_0251_Proc.srcs\sources_1\bd\core\ip\core_dlmb_bram_if_cntlr_0\lmb_bram_if_cntlr_v4_0\hdl\vhdl\parity.vhd]
Enabled=1
[file:.\..\xilinx\fir_0251_Proc.srcs\sources_1\bd\core\ip\core_dlmb_bram_if_cntlr_0\lmb_bram_if_cntlr_v4_0\hdl\vhdl\parityenable.vhd]
Enabled=1
[file:.\..\xilinx\fir_0251_Proc.srcs\sources_1\bd\core\ip\core_dlmb_bram_if_cntlr_0\lmb_bram_if_cntlr_v4_0\hdl\vhdl\pselect.vhd]
Enabled=1
[file:.\..\xilinx\fir_0251_Proc.srcs\sources_1\bd\core\ip\core_dlmb_bram_if_cntlr_0\lmb_bram_if_cntlr_v4_0\hdl\vhdl\pselect_mask.vhd]
Enabled=1
[file:.\..\xilinx\fir_0251_Proc.srcs\sources_1\bd\core\ip\core_dlmb_bram_if_cntlr_0\lmb_bram_if_cntlr_v4_0\hdl\vhdl\xor18.vhd]
Enabled=1
[file:.\src\BD\compile_lmb_bram_if_cntlr_v4_0.do]
Enabled=1
[file:.\src\BD\compile_lmb_v10_v3_0.do]
Enabled=1
[file:.\..\xilinx\fir_0251_Proc.srcs\sources_1\bd\core\ip\core_lmb_bram_0\blk_mem_gen_v8_0\simulation\blk_mem_gen_v8_0.vhd]
Enabled=1
[file:.\src\BD\compile_mdm_v3_0.do]
Enabled=1
[file:.\..\xilinx\fir_0251_Proc.srcs\sources_1\bd\core\ip\core_mdm_1_0\mdm_v3_0\hdl\vhdl\jtag_control.vhd]
Enabled=1
[file:.\..\xilinx\fir_0251_Proc.srcs\sources_1\bd\core\ip\core_mdm_1_0\mdm_v3_0\hdl\vhdl\mdm.vhd]
Enabled=1
[file:.\..\xilinx\fir_0251_Proc.srcs\sources_1\bd\core\ip\core_mdm_1_0\mdm_v3_0\hdl\vhdl\mdm_core.vhd]
Enabled=1
[file:.\..\xilinx\fir_0251_Proc.srcs\sources_1\bd\core\ip\core_mdm_1_0\mdm_v3_0\hdl\vhdl\srl_fifo.vhd]
Enabled=1
[file:.\..\xilinx\fir_0251_Proc.srcs\sources_1\bd\core\ip\core_mdm_1_0\proc_common_v4_0\hdl\src\vhdl\addsub.vhd]
Enabled=1
[file:.\..\xilinx\fir_0251_Proc.srcs\sources_1\bd\core\ip\core_mdm_1_0\proc_common_v4_0\hdl\src\vhdl\async_fifo_fg.vhd]
Enabled=1
[file:.\..\xilinx\fir_0251_Proc.srcs\sources_1\bd\core\ip\core_mdm_1_0\proc_common_v4_0\hdl\src\vhdl\basic_sfifo_fg.vhd]
Enabled=1
[file:.\..\xilinx\fir_0251_Proc.srcs\sources_1\bd\core\ip\core_mdm_1_0\proc_common_v4_0\hdl\src\vhdl\blk_mem_gen_wrapper.vhd]
Enabled=1
[file:.\..\xilinx\fir_0251_Proc.srcs\sources_1\bd\core\ip\core_mdm_1_0\proc_common_v4_0\hdl\src\vhdl\cdc_sync.vhd]
Enabled=1
[file:.\..\xilinx\fir_0251_Proc.srcs\sources_1\bd\core\ip\core_mdm_1_0\proc_common_v4_0\hdl\src\vhdl\cntr_incr_decr_addn_f.vhd]
Enabled=1
[file:.\..\xilinx\fir_0251_Proc.srcs\sources_1\bd\core\ip\core_mdm_1_0\proc_common_v4_0\hdl\src\vhdl\common_types_pkg.vhd]
Enabled=1
[file:.\..\xilinx\fir_0251_Proc.srcs\sources_1\bd\core\ip\core_mdm_1_0\proc_common_v4_0\hdl\src\vhdl\compare_vectors_f.vhd]
Enabled=1
[file:.\..\xilinx\fir_0251_Proc.srcs\sources_1\bd\core\ip\core_mdm_1_0\proc_common_v4_0\hdl\src\vhdl\conv_funs_pkg.vhd]
Enabled=1
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
Enabled=1
[file:.\..\xilinx\fir_0251_Proc.srcs\sources_1\bd\core\ip\core_microblaze_1_0\microblaze_v9_2\hdl\vhdl\shift_logic_bit.vhd]
Enabled=1
[file:.\..\xilinx\fir_0251_Proc.srcs\sources_1\bd\core\ip\core_microblaze_1_0\microblaze_v9_2\hdl\vhdl\shift_logic_gti.vhd]
Enabled=1
[file:.\..\xilinx\fir_0251_Proc.srcs\sources_1\bd\core\ip\core_microblaze_1_0\microblaze_v9_2\hdl\vhdl\stack_protection.vhd]
Enabled=1
[file:.\..\xilinx\fir_0251_Proc.srcs\sources_1\bd\core\ip\core_microblaze_1_0\microblaze_v9_2\hdl\vhdl\stream_cache.vhd]
Enabled=1
[file:.\..\xilinx\fir_0251_Proc.srcs\sources_1\bd\core\ip\core_microblaze_1_0\microblaze_v9_2\hdl\vhdl\streaming_axi.vhd]
Enabled=1
[file:.\..\xilinx\fir_0251_Proc.srcs\sources_1\bd\core\ip\core_microblaze_1_0\microblaze_v9_2\hdl\vhdl\vec_mux.vhd]
Enabled=1
[file:.\..\xilinx\fir_0251_Proc.srcs\sources_1\bd\core\ip\core_microblaze_1_0\microblaze_v9_2\hdl\vhdl\victim_cache.vhd]
Enabled=1
[file:.\..\xilinx\fir_0251_Proc.srcs\sources_1\bd\core\ip\core_microblaze_1_0\microblaze_v9_2\hdl\vhdl\wb_mux_bit_gti.vhd]
Enabled=1
[file:.\..\xilinx\fir_0251_Proc.srcs\sources_1\bd\core\ip\core_microblaze_1_0\microblaze_v9_2\hdl\vhdl\wb_mux_gti.vhd]
Enabled=1
[file:.\..\xilinx\fir_0251_Proc.srcs\sources_1\bd\core\ip\core_microblaze_1_0\microblaze_v9_2\hdl\vhdl\zero_detect.vhd]
Enabled=1
[file:.\..\xilinx\fir_0251_Proc.srcs\sources_1\bd\core\ip\core_microblaze_1_0\microblaze_v9_2\hdl\vhdl\zero_detect_gti.vhd]
Enabled=1
[file:.\src\BD\compile_axi_intc_v4_0.do]
Enabled=1
[file:.\..\xilinx\fir_0251_Proc.srcs\sources_1\bd\core\ip\core_microblaze_1_axi_intc_0\axi_intc_v4_0\hdl\src\vhdl\axi_intc.vhd]
Enabled=1
[file:.\..\xilinx\fir_0251_Proc.srcs\sources_1\bd\core\ip\core_microblaze_1_axi_intc_0\axi_intc_v4_0\hdl\src\vhdl\double_synchronizer.vhd]
Enabled=1
[file:.\..\xilinx\fir_0251_Proc.srcs\sources_1\bd\core\ip\core_microblaze_1_axi_intc_0\axi_intc_v4_0\hdl\src\vhdl\intc_core.vhd]
Enabled=1
[file:.\..\xilinx\fir_0251_Proc.srcs\sources_1\bd\core\ip\core_microblaze_1_axi_intc_0\axi_intc_v4_0\hdl\src\vhdl\pulse_synchronizer.vhd]
Enabled=1
[file:.\..\xilinx\fir_0251_Proc.srcs\sources_1\bd\core\ip\core_microblaze_1_axi_intc_0\axi_intc_v4_0\hdl\src\vhdl\shared_ram_ivar.vhd]
Enabled=1
[file:.\..\xilinx\fir_0251_Proc.srcs\sources_1\bd\core\ip\core_VCC_0\work\xlconstant.vhd]
Enabled=1
[file:.\src\BD\compile_axi_gpio_v2_0.do]
Enabled=1
[file:.\..\xilinx\fir_0251_Proc.srcs\sources_1\bd\core\ip\core_axi_gpio_0_0\axi_gpio_v2_0\hdl\src\vhdl\axi_gpio.vhd]
Enabled=1
[file:.\..\xilinx\fir_0251_Proc.srcs\sources_1\bd\core\ip\core_axi_gpio_0_0\axi_gpio_v2_0\hdl\src\vhdl\gpio_core.vhd]
Enabled=1
[file:.\..\xilinx\fir_0251_Proc.srcs\sources_1\bd\core\ip\core_axi_gpio_0_0\interrupt_control_v3_0\hdl\src\vhdl\interrupt_control.vhd]
Enabled=1
[file:.\src\BD\compile_axi_timer_v2_0.do]
Enabled=1
[file:.\..\xilinx\fir_0251_Proc.srcs\sources_1\bd\core\ip\core_axi_timer_0_0\axi_timer_v2_0\hdl\src\vhdl\axi_timer.vhd]
Enabled=1
[file:.\..\xilinx\fir_0251_Proc.srcs\sources_1\bd\core\ip\core_axi_timer_0_0\axi_timer_v2_0\hdl\src\vhdl\count_module.vhd]
Enabled=1
[file:.\..\xilinx\fir_0251_Proc.srcs\sources_1\bd\core\ip\core_axi_timer_0_0\axi_timer_v2_0\hdl\src\vhdl\tc_core.vhd]
Enabled=1
[file:.\..\xilinx\fir_0251_Proc.srcs\sources_1\bd\core\ip\core_axi_timer_0_0\axi_timer_v2_0\hdl\src\vhdl\tc_types.vhd]
Enabled=1
[file:.\..\xilinx\fir_0251_Proc.srcs\sources_1\bd\core\ip\core_axi_timer_0_0\axi_timer_v2_0\hdl\src\vhdl\timer_control.vhd]
Enabled=1
[file:.\src\BD\compile_axi_uart16550_v2_0.do]
Enabled=1
[file:.\..\xilinx\fir_0251_Proc.srcs\sources_1\bd\core\ip\core_clink_uart_1\axi_uart16550_v2_0\hdl\src\vhdl\axi_uart16550.vhd]
Enabled=1
[file:.\..\xilinx\fir_0251_Proc.srcs\sources_1\bd\core\ip\core_clink_uart_1\axi_uart16550_v2_0\hdl\src\vhdl\ipic_if.vhd]
Enabled=1
[file:.\..\xilinx\fir_0251_Proc.srcs\sources_1\bd\core\ip\core_clink_uart_1\axi_uart16550_v2_0\hdl\src\vhdl\rx_fifo_block.vhd]
Enabled=1
[file:.\..\xilinx\fir_0251_Proc.srcs\sources_1\bd\core\ip\core_clink_uart_1\axi_uart16550_v2_0\hdl\src\vhdl\rx_fifo_control.vhd]
Enabled=1
[file:.\..\xilinx\fir_0251_Proc.srcs\sources_1\bd\core\ip\core_clink_uart_1\axi_uart16550_v2_0\hdl\src\vhdl\rx16550.vhd]
Enabled=1
[file:.\..\xilinx\fir_0251_Proc.srcs\sources_1\bd\core\ip\core_clink_uart_1\axi_uart16550_v2_0\hdl\src\vhdl\tx_fifo_block.vhd]
Enabled=1
[file:.\..\xilinx\fir_0251_Proc.srcs\sources_1\bd\core\ip\core_clink_uart_1\axi_uart16550_v2_0\hdl\src\vhdl\tx16550.vhd]
Enabled=1
[file:.\..\xilinx\fir_0251_Proc.srcs\sources_1\bd\core\ip\core_clink_uart_1\axi_uart16550_v2_0\hdl\src\vhdl\uart16550.vhd]
Enabled=1
[file:.\..\xilinx\fir_0251_Proc.srcs\sources_1\bd\core\ip\core_clink_uart_1\axi_uart16550_v2_0\hdl\src\vhdl\xuart.vhd]
Enabled=1
[file:.\..\xilinx\fir_0251_Proc.srcs\sources_1\bd\core\ip\core_clink_uart_1\axi_uart16550_v2_0\hdl\src\vhdl\xuart_tx_load_sm.vhd]
Enabled=1
[file:.\..\xilinx\fir_0251_Proc.srcs\sources_1\bd\core\ip\core_intr_concact_0\work\xlconcat.vhd]
Enabled=1
[file:.\src\BD\compile_proc_sys_reset_v5_0.do]
Enabled=1
[file:.\..\xilinx\fir_0251_Proc.srcs\sources_1\bd\core\ip\core_proc_sys_reset_1_0\proc_sys_reset_v5_0\hdl\src\vhdl\lpf.vhd]
Enabled=1
[file:.\..\xilinx\fir_0251_Proc.srcs\sources_1\bd\core\ip\core_proc_sys_reset_1_0\proc_sys_reset_v5_0\hdl\src\vhdl\proc_sys_reset.vhd]
Enabled=1
[file:.\..\xilinx\fir_0251_Proc.srcs\sources_1\bd\core\ip\core_proc_sys_reset_1_0\proc_sys_reset_v5_0\hdl\src\vhdl\sequence.vhd]
Enabled=1
[file:.\..\xilinx\fir_0251_Proc.srcs\sources_1\bd\core\ip\core_proc_sys_reset_1_0\proc_sys_reset_v5_0\hdl\src\vhdl\upcnt_n.vhd]
Enabled=1
[file:.\..\xilinx\fir_0251_Proc.srcs\sources_1\bd\core\ip\core_xadc_wiz_1_0\axi_lite_ipif_v1_01_a\hdl\src\vhdl\core_xadc_wiz_1_0_address_decoder.vhd]
Enabled=1
[file:.\..\xilinx\fir_0251_Proc.srcs\sources_1\bd\core\ip\core_xadc_wiz_1_0\axi_lite_ipif_v1_01_a\hdl\src\vhdl\core_xadc_wiz_1_0_axi_lite_ipif.vhd]
Enabled=1
[file:.\..\xilinx\fir_0251_Proc.srcs\sources_1\bd\core\ip\core_xadc_wiz_1_0\axi_lite_ipif_v1_01_a\hdl\src\vhdl\core_xadc_wiz_1_0_slave_attachment.vhd]
Enabled=1
[file:.\src\BD\compile_core_xadc_wiz_1_0_axi_xadc.do]
Enabled=1
[file:.\..\xilinx\fir_0251_Proc.srcs\sources_1\bd\core\ip\core_xadc_wiz_1_0\proc_common_v3_00_a\hdl\src\vhdl\core_xadc_wiz_1_0_conv_funs_pkg.vhd]
Enabled=1
[file:.\..\xilinx\fir_0251_Proc.srcs\sources_1\bd\core\ip\core_xadc_wiz_1_0\proc_common_v3_00_a\hdl\src\vhdl\core_xadc_wiz_1_0_family.vhd]
Enabled=1
[file:.\..\xilinx\fir_0251_Proc.srcs\sources_1\bd\core\ip\core_xadc_wiz_1_0\proc_common_v3_00_a\hdl\src\vhdl\core_xadc_wiz_1_0_family_support.vhd]
Enabled=1
[file:.\..\xilinx\fir_0251_Proc.srcs\sources_1\bd\core\ip\core_xadc_wiz_1_0\proc_common_v3_00_a\hdl\src\vhdl\core_xadc_wiz_1_0_ipif_pkg.vhd]
Enabled=1
[file:.\..\xilinx\fir_0251_Proc.srcs\sources_1\bd\core\ip\core_xadc_wiz_1_0\proc_common_v3_00_a\hdl\src\vhdl\core_xadc_wiz_1_0_proc_common_pkg.vhd]
Enabled=1
[file:.\..\xilinx\fir_0251_Proc.srcs\sources_1\bd\core\ip\core_xadc_wiz_1_0\proc_common_v3_00_a\hdl\src\vhdl\core_xadc_wiz_1_0_pselect_f.vhd]
Enabled=1
[file:.\..\xilinx\fir_0251_Proc.srcs\sources_1\bd\core\ip\core_xadc_wiz_1_0\proc_common_v3_00_a\hdl\src\vhdl\core_xadc_wiz_1_0_soft_reset.vhd]
Enabled=1
[file:.\..\xilinx\fir_0251_Proc.srcs\sources_1\bd\core\ip\core_xadc_wiz_1_0\core_xadc_wiz_1_0_drp_arbiter.vhd]
Enabled=1
[file:.\..\xilinx\fir_0251_Proc.srcs\sources_1\bd\core\ip\core_xadc_wiz_1_0\core_xadc_wiz_1_0_temperature_update.vhd]
Enabled=1
[file:.\..\xilinx\fir_0251_Proc.srcs\sources_1\bd\core\ip\core_xadc_wiz_1_0\core_xadc_wiz_1_0_xadc_core_drp.vhd]
Enabled=1
[file:.\..\xilinx\fir_0251_Proc.srcs\sources_1\bd\core\ip\core_xadc_wiz_1_0\interrupt_control_v2_01_a\hdl\src\vhdl\core_xadc_wiz_1_0_interrupt_control.vhd]
Enabled=1
[file:.\src\BD\compile_core_bd.do]
Enabled=1
[file:.\..\xilinx\fir_0251_Proc.srcs\sources_1\bd\core\ip\core_auto_cc_1\sim\core_auto_cc_1.v]
Enabled=1
[file:.\..\xilinx\fir_0251_Proc.srcs\sources_1\bd\core\ip\core_auto_cc_0\sim\core_auto_cc_0.v]
Enabled=1
[file:.\..\xilinx\fir_0251_Proc.srcs\sources_1\bd\core\ip\core_auto_pc_10\sim\core_auto_pc_10.v]
Enabled=1
[file:.\..\xilinx\fir_0251_Proc.srcs\sources_1\bd\core\ip\core_auto_pc_11\sim\core_auto_pc_11.v]
Enabled=1
[file:.\..\xilinx\fir_0251_Proc.srcs\sources_1\bd\core\ip\core_auto_pc_12\sim\core_auto_pc_12.v]
Enabled=1
[file:.\..\xilinx\fir_0251_Proc.srcs\sources_1\bd\core\ip\core_auto_pc_13\sim\core_auto_pc_13.v]
Enabled=1
[file:.\..\xilinx\fir_0251_Proc.srcs\sources_1\bd\core\ip\core_auto_pc_14\sim\core_auto_pc_14.v]
Enabled=1
[file:.\..\xilinx\fir_0251_Proc.srcs\sources_1\bd\core\ip\core_auto_pc_15\sim\core_auto_pc_15.v]
Enabled=1
[file:.\..\xilinx\fir_0251_Proc.srcs\sources_1\bd\core\ip\core_auto_pc_9\sim\core_auto_pc_9.v]
Enabled=1
[file:.\..\xilinx\fir_0251_Proc.srcs\sources_1\bd\core\ip\core_auto_pc_16\sim\core_auto_pc_16.v]
Enabled=1
[file:.\..\xilinx\fir_0251_Proc.srcs\sources_1\bd\core\ip\core_auto_us_0\sim\core_auto_us_0.v]
Enabled=1
[file:.\..\xilinx\fir_0251_Proc.srcs\sources_1\bd\core\ip\core_auto_us_3\sim\core_auto_us_3.v]
Enabled=1
[file:.\..\xilinx\fir_0251_Proc.srcs\sources_1\bd\core\ip\core_auto_us_1\sim\core_auto_us_1.v]
Enabled=1
[file:.\..\xilinx\fir_0251_Proc.srcs\sources_1\bd\core\ip\core_auto_us_2\sim\core_auto_us_2.v]
Enabled=1
[file:.\..\xilinx\fir_0251_Proc.srcs\sources_1\bd\core\ip\core_auto_us_4\sim\core_auto_us_4.v]
Enabled=1
[file:.\..\xilinx\fir_0251_Proc.srcs\sources_1\bd\core\ip\core_mig_7series_1_0\core_mig_7series_1_0\user_design\rtl\core_mig_7series_1_0_mig_sim.v]
Enabled=1
[file:.\src\BD\compile_axi_protocol_converter_v2_1.do]
Enabled=1
[file:.\..\xilinx\fir_0251_Proc.srcs\sources_1\bd\core\ip\core_axi_protocol_converter_0_0\axi_protocol_converter_v2_1\hdl\verilog\axi_protocol_converter_v2_1_a_axi3_conv.v]
Enabled=1
[file:.\..\xilinx\fir_0251_Proc.srcs\sources_1\bd\core\ip\core_axi_protocol_converter_0_0\axi_protocol_converter_v2_1\hdl\verilog\axi_protocol_converter_v2_1_axi_protocol_converter.v]
Enabled=1
[file:.\..\xilinx\fir_0251_Proc.srcs\sources_1\bd\core\ip\core_axi_protocol_converter_0_0\axi_protocol_converter_v2_1\hdl\verilog\axi_protocol_converter_v2_1_axi3_conv.v]
Enabled=1
[file:.\..\xilinx\fir_0251_Proc.srcs\sources_1\bd\core\ip\core_axi_protocol_converter_0_0\axi_protocol_converter_v2_1\hdl\verilog\axi_protocol_converter_v2_1_axilite_conv.v]
Enabled=1
[file:.\..\xilinx\fir_0251_Proc.srcs\sources_1\bd\core\ip\core_axi_protocol_converter_0_0\axi_protocol_converter_v2_1\hdl\verilog\axi_protocol_converter_v2_1_b_downsizer.v]
Enabled=1
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
Enabled=1
[file:.\..\xilinx\fir_0251_Proc.srcs\sources_1\bd\core\ip\core_axi_protocol_converter_0_0\generic_baseblocks_v2_1\hdl\verilog\generic_baseblocks_v2_1_mux.v]
Enabled=1
[file:.\..\xilinx\fir_0251_Proc.srcs\sources_1\bd\core\ip\core_axi_protocol_converter_0_0\generic_baseblocks_v2_1\hdl\verilog\generic_baseblocks_v2_1_mux_enc.v]
Enabled=1
[file:.\..\xilinx\fir_0251_Proc.srcs\sources_1\bd\core\ip\core_axi_protocol_converter_0_0\generic_baseblocks_v2_1\hdl\verilog\generic_baseblocks_v2_1_nto1_mux.v]
Enabled=1
[file:.\src\BD\compile_core_auto_cc.do]
Enabled=1
[file:.\..\xilinx\fir_0251_Proc.srcs\sources_1\bd\core\ip\core_auto_cc_0\axi_clock_converter_v2_1\hdl\verilog\axi_clock_converter_v2_1_axi_clock_converter.v]
Enabled=1
[file:.\..\xilinx\fir_0251_Proc.srcs\sources_1\bd\core\ip\core_auto_cc_0\axi_clock_converter_v2_1\hdl\verilog\axi_clock_converter_v2_1_axic_sample_cycle_ratio.v]
Enabled=1
[file:.\..\xilinx\fir_0251_Proc.srcs\sources_1\bd\core\ip\core_auto_cc_0\axi_clock_converter_v2_1\hdl\verilog\axi_clock_converter_v2_1_axic_sync_clock_converter.v]
Enabled=1
[file:.\..\xilinx\fir_0251_Proc.srcs\sources_1\bd\core\ip\core_auto_cc_0\fifo_generator_v11_0\simulation\fifo_generator_v11_0.v]
Enabled=1
[file:.\..\xilinx\fir_0251_Proc.srcs\sources_1\bd\core\ip\core_auto_cc_0\fifo_generator_v11_0\ramfifo\async_fifo.vhd]
Enabled=1
[file:.\src\BD\compile_core_auto_us.do]
Enabled=1
[file:.\..\xilinx\fir_0251_Proc.srcs\sources_1\bd\core\ip\core_auto_us_0\axi_dwidth_converter_v2_1\hdl\verilog\axi_dwidth_converter_v2_1_a_downsizer.v]
Enabled=1
[file:.\..\xilinx\fir_0251_Proc.srcs\sources_1\bd\core\ip\core_auto_us_0\axi_dwidth_converter_v2_1\hdl\verilog\axi_dwidth_converter_v2_1_a_upsizer.v]
Enabled=1
[file:.\..\xilinx\fir_0251_Proc.srcs\sources_1\bd\core\ip\core_auto_us_0\axi_dwidth_converter_v2_1\hdl\verilog\axi_dwidth_converter_v2_1_axi_downsizer.v]
Enabled=1
[file:.\..\xilinx\fir_0251_Proc.srcs\sources_1\bd\core\ip\core_auto_us_0\axi_dwidth_converter_v2_1\hdl\verilog\axi_dwidth_converter_v2_1_axi_upsizer.v]
Enabled=1
[file:.\..\xilinx\fir_0251_Proc.srcs\sources_1\bd\core\ip\core_auto_us_0\axi_dwidth_converter_v2_1\hdl\verilog\axi_dwidth_converter_v2_1_axi4lite_downsizer.v]
Enabled=1
[file:.\..\xilinx\fir_0251_Proc.srcs\sources_1\bd\core\ip\core_auto_us_0\axi_dwidth_converter_v2_1\hdl\verilog\axi_dwidth_converter_v2_1_axi4lite_upsizer.v]
Enabled=1
[file:.\..\xilinx\fir_0251_Proc.srcs\sources_1\bd\core\ip\core_auto_us_0\axi_dwidth_converter_v2_1\hdl\verilog\axi_dwidth_converter_v2_1_b_downsizer.v]
Enabled=1
[file:.\..\xilinx\fir_0251_Proc.srcs\sources_1\bd\core\ip\core_auto_us_0\axi_dwidth_converter_v2_1\hdl\verilog\axi_dwidth_converter_v2_1_r_downsizer.v]
Enabled=1
[file:.\..\xilinx\fir_0251_Proc.srcs\sources_1\bd\core\ip\core_auto_us_0\axi_dwidth_converter_v2_1\hdl\verilog\axi_dwidth_converter_v2_1_r_upsizer.v]
Enabled=1
[file:.\..\xilinx\fir_0251_Proc.srcs\sources_1\bd\core\ip\core_auto_us_0\axi_dwidth_converter_v2_1\hdl\verilog\axi_dwidth_converter_v2_1_r_upsizer_pktfifo.v]
Enabled=1
[file:.\..\xilinx\fir_0251_Proc.srcs\sources_1\bd\core\ip\core_auto_us_0\axi_dwidth_converter_v2_1\hdl\verilog\axi_dwidth_converter_v2_1_top.v]
Enabled=1
[file:.\..\xilinx\fir_0251_Proc.srcs\sources_1\bd\core\ip\core_auto_us_0\axi_dwidth_converter_v2_1\hdl\verilog\axi_dwidth_converter_v2_1_w_downsizer.v]
Enabled=1
[file:.\..\xilinx\fir_0251_Proc.srcs\sources_1\bd\core\ip\core_auto_us_0\axi_dwidth_converter_v2_1\hdl\verilog\axi_dwidth_converter_v2_1_w_upsizer.v]
Enabled=1
[file:.\..\xilinx\fir_0251_Proc.srcs\sources_1\bd\core\ip\core_auto_us_0\axi_dwidth_converter_v2_1\hdl\verilog\axi_dwidth_converter_v2_1_w_upsizer_pktfifo.v]
Enabled=1
[file:.\..\xilinx\fir_0251_Proc.srcs\sources_1\bd\core\ip\core_auto_us_0\generic_baseblocks_v2_1\hdl\verilog\generic_baseblocks_v2_1_carry.v]
Enabled=1
[file:.\..\xilinx\fir_0251_Proc.srcs\sources_1\bd\core\ip\core_auto_us_0\generic_baseblocks_v2_1\hdl\verilog\generic_baseblocks_v2_1_carry_and.v]
Enabled=1
[file:.\..\xilinx\fir_0251_Proc.srcs\sources_1\bd\core\ip\core_auto_us_0\generic_baseblocks_v2_1\hdl\verilog\generic_baseblocks_v2_1_carry_latch_and.v]
Enabled=1
[file:.\..\xilinx\fir_0251_Proc.srcs\sources_1\bd\core\ip\core_auto_us_0\generic_baseblocks_v2_1\hdl\verilog\generic_baseblocks_v2_1_carry_latch_or.v]
Enabled=1
[file:.\..\xilinx\fir_0251_Proc.srcs\sources_1\bd\core\ip\core_auto_us_0\generic_baseblocks_v2_1\hdl\verilog\generic_baseblocks_v2_1_carry_or.v]
Enabled=1
[file:.\..\xilinx\fir_0251_Proc.srcs\sources_1\bd\core\ip\core_auto_us_0\generic_baseblocks_v2_1\hdl\verilog\generic_baseblocks_v2_1_command_fifo.v]
Enabled=1
[file:.\..\xilinx\fir_0251_Proc.srcs\sources_1\bd\core\ip\core_auto_us_0\generic_baseblocks_v2_1\hdl\verilog\generic_baseblocks_v2_1_comparator.v]
Enabled=1
[file:.\..\xilinx\fir_0251_Proc.srcs\sources_1\bd\core\ip\core_auto_us_0\generic_baseblocks_v2_1\hdl\verilog\generic_baseblocks_v2_1_comparator_mask.v]
Enabled=1
[file:.\..\xilinx\fir_0251_Proc.srcs\sources_1\bd\core\ip\core_auto_us_0\generic_baseblocks_v2_1\hdl\verilog\generic_baseblocks_v2_1_comparator_mask_static.v]
Enabled=1
[file:.\..\xilinx\fir_0251_Proc.srcs\sources_1\bd\core\ip\core_auto_us_0\generic_baseblocks_v2_1\hdl\verilog\generic_baseblocks_v2_1_comparator_sel.v]
Enabled=1
[file:.\..\xilinx\fir_0251_Proc.srcs\sources_1\bd\core\ip\core_auto_us_0\generic_baseblocks_v2_1\hdl\verilog\generic_baseblocks_v2_1_comparator_sel_mask.v]
Enabled=1
[file:.\..\xilinx\fir_0251_Proc.srcs\sources_1\bd\core\ip\core_auto_us_0\generic_baseblocks_v2_1\hdl\verilog\generic_baseblocks_v2_1_comparator_sel_mask_static.v]
Enabled=1
[file:.\..\xilinx\fir_0251_Proc.srcs\sources_1\bd\core\ip\core_auto_us_0\generic_baseblocks_v2_1\hdl\verilog\generic_baseblocks_v2_1_comparator_sel_static.v]
Enabled=1
[file:.\..\xilinx\fir_0251_Proc.srcs\sources_1\bd\core\ip\core_auto_us_0\generic_baseblocks_v2_1\hdl\verilog\generic_baseblocks_v2_1_comparator_static.v]
Enabled=1
[file:.\..\xilinx\fir_0251_Proc.srcs\sources_1\bd\core\ip\core_auto_us_0\generic_baseblocks_v2_1\hdl\verilog\generic_baseblocks_v2_1_mux.v]
Enabled=1
[file:.\..\xilinx\fir_0251_Proc.srcs\sources_1\bd\core\ip\core_auto_us_0\generic_baseblocks_v2_1\hdl\verilog\generic_baseblocks_v2_1_mux_enc.v]
Enabled=1
[file:.\..\xilinx\fir_0251_Proc.srcs\sources_1\bd\core\ip\core_auto_us_0\generic_baseblocks_v2_1\hdl\verilog\generic_baseblocks_v2_1_nto1_mux.v]
Enabled=1
[file:.\..\..\..\Xilinx\Vivado\2013.4\ids_lite\EDK\hw\XilinxProcessorIPLib\pcores\axi_pcie_mm_s_v1_02_a\hdl\verilog\a_upsizer.v]
Enabled=1
[file:.\..\..\..\Xilinx\Vivado\2013.4\ids_lite\EDK\hw\XilinxProcessorIPLib\pcores\axi_pcie_mm_s_v1_02_a\hdl\verilog\axi_upsizer.v]
Enabled=1
[file:.\..\..\..\Xilinx\Vivado\2013.4\ids_lite\EDK\hw\XilinxProcessorIPLib\pcores\axi_pcie_mm_s_v1_02_a\hdl\verilog\carry_and.v]
Enabled=1
[file:.\..\..\..\Xilinx\Vivado\2013.4\ids_lite\EDK\hw\XilinxProcessorIPLib\pcores\axi_pcie_mm_s_v1_02_a\hdl\verilog\carry_latch_and.v]
Enabled=1
[file:.\..\..\..\Xilinx\Vivado\2013.4\ids_lite\EDK\hw\XilinxProcessorIPLib\pcores\axi_pcie_mm_s_v1_02_a\hdl\verilog\carry_latch_or.v]
Enabled=1
[file:.\..\..\..\Xilinx\Vivado\2013.4\ids_lite\EDK\hw\XilinxProcessorIPLib\pcores\axi_pcie_mm_s_v1_02_a\hdl\verilog\carry_or.v]
Enabled=1
[file:.\..\..\..\Xilinx\Vivado\2013.4\ids_lite\EDK\hw\XilinxProcessorIPLib\pcores\axi_pcie_mm_s_v1_02_a\hdl\verilog\command_fifo.v]
Enabled=1
[file:.\..\..\..\Xilinx\Vivado\2013.4\ids_lite\EDK\hw\XilinxProcessorIPLib\pcores\axi_pcie_mm_s_v1_02_a\hdl\verilog\comparator.v]
Enabled=1
[file:.\..\..\..\Xilinx\Vivado\2013.4\ids_lite\EDK\hw\XilinxProcessorIPLib\pcores\axi_pcie_mm_s_v1_02_a\hdl\verilog\comparator_sel.v]
Enabled=1
[file:.\..\..\..\Xilinx\Vivado\2013.4\ids_lite\EDK\hw\XilinxProcessorIPLib\pcores\axi_pcie_mm_s_v1_02_a\hdl\verilog\comparator_sel_static.v]
Enabled=1
[file:.\..\..\..\Xilinx\Vivado\2013.4\ids_lite\EDK\hw\XilinxProcessorIPLib\pcores\axi_pcie_mm_s_v1_02_a\hdl\verilog\fifo.v]
Enabled=1
[file:.\..\..\..\Xilinx\Vivado\2013.4\ids_lite\EDK\hw\XilinxProcessorIPLib\pcores\axi_pcie_mm_s_v1_02_a\hdl\verilog\r_upsizer.v]
Enabled=1
[file:.\..\..\..\Xilinx\Vivado\2013.4\ids_lite\EDK\hw\XilinxProcessorIPLib\pcores\axi_pcie_mm_s_v1_02_a\hdl\verilog\w_upsizer.v]
Enabled=1
[file:.\..\xilinx\fir_0251_Proc.srcs\sources_1\bd\core\ip\core_auto_us_0\fifo_generator_v11_0\simulation\fifo_generator_v11_0.v]
Enabled=1
[file:.\src\BD\compile_blk_mem_gen_v8_1.do]
Enabled=1
[file:.\src\BD\compile_core_xbar.do]
Enabled=1
[file:.\..\xilinx\fir_0251_Proc.srcs\sources_1\bd\core\ip\core_xbar_0\axi_crossbar_v2_1\hdl\verilog\axi_crossbar_v2_1_addr_arbiter.v]
Enabled=1
[file:.\..\xilinx\fir_0251_Proc.srcs\sources_1\bd\core\ip\core_xbar_0\axi_crossbar_v2_1\hdl\verilog\axi_crossbar_v2_1_addr_arbiter_sasd.v]
Enabled=1
[file:.\..\xilinx\fir_0251_Proc.srcs\sources_1\bd\core\ip\core_xbar_0\axi_crossbar_v2_1\hdl\verilog\axi_crossbar_v2_1_addr_decoder.v]
Enabled=1
[file:.\..\xilinx\fir_0251_Proc.srcs\sources_1\bd\core\ip\core_xbar_0\axi_crossbar_v2_1\hdl\verilog\axi_crossbar_v2_1_arbiter_resp.v]
Enabled=1
[file:.\..\xilinx\fir_0251_Proc.srcs\sources_1\bd\core\ip\core_xbar_0\axi_crossbar_v2_1\hdl\verilog\axi_crossbar_v2_1_axi_crossbar.v]
Enabled=1
[file:.\..\xilinx\fir_0251_Proc.srcs\sources_1\bd\core\ip\core_xbar_0\axi_crossbar_v2_1\hdl\verilog\axi_crossbar_v2_1_crossbar.v]
Enabled=1
[file:.\..\xilinx\fir_0251_Proc.srcs\sources_1\bd\core\ip\core_xbar_0\axi_crossbar_v2_1\hdl\verilog\axi_crossbar_v2_1_crossbar_sasd.v]
Enabled=1
[file:.\..\xilinx\fir_0251_Proc.srcs\sources_1\bd\core\ip\core_xbar_0\axi_crossbar_v2_1\hdl\verilog\axi_crossbar_v2_1_decerr_slave.v]
Enabled=1
[file:.\..\xilinx\fir_0251_Proc.srcs\sources_1\bd\core\ip\core_xbar_0\axi_crossbar_v2_1\hdl\verilog\axi_crossbar_v2_1_si_transactor.v]
Enabled=1
[file:.\..\xilinx\fir_0251_Proc.srcs\sources_1\bd\core\ip\core_xbar_0\axi_crossbar_v2_1\hdl\verilog\axi_crossbar_v2_1_splitter.v]
Enabled=1
[file:.\..\xilinx\fir_0251_Proc.srcs\sources_1\bd\core\ip\core_xbar_0\axi_crossbar_v2_1\hdl\verilog\axi_crossbar_v2_1_wdata_mux.v]
Enabled=1
[file:.\..\xilinx\fir_0251_Proc.srcs\sources_1\bd\core\ip\core_xbar_0\axi_crossbar_v2_1\hdl\verilog\axi_crossbar_v2_1_wdata_router.v]
Enabled=1
[file:.\src\BD\compile_mig_series7_1_0.do]
Enabled=1
[file:.\..\xilinx\fir_0251_Proc.srcs\sources_1\bd\core\ip\core_mig_7series_1_0\core_mig_7series_1_0\user_design\rtl\clocking\mig_7series_v2_0_clk_ibuf.v]
Enabled=1
[file:.\..\xilinx\fir_0251_Proc.srcs\sources_1\bd\core\ip\core_mig_7series_1_0\core_mig_7series_1_0\user_design\rtl\clocking\mig_7series_v2_0_infrastructure.v]
Enabled=1
[file:.\..\xilinx\fir_0251_Proc.srcs\sources_1\bd\core\ip\core_mig_7series_1_0\core_mig_7series_1_0\user_design\rtl\clocking\mig_7series_v2_0_iodelay_ctrl.v]
Enabled=1
[file:.\..\xilinx\fir_0251_Proc.srcs\sources_1\bd\core\ip\core_mig_7series_1_0\core_mig_7series_1_0\user_design\rtl\clocking\mig_7series_v2_0_tempmon.v]
Enabled=1
[file:.\..\xilinx\fir_0251_Proc.srcs\sources_1\bd\core\ip\core_mig_7series_1_0\core_mig_7series_1_0\user_design\rtl\ip_top\mig_7series_v2_0_mem_intfc.v]
Enabled=1
[file:.\..\xilinx\fir_0251_Proc.srcs\sources_1\bd\core\ip\core_mig_7series_1_0\core_mig_7series_1_0\user_design\rtl\ip_top\mig_7series_v2_0_memc_ui_top_axi.v]
Enabled=1
[file:.\..\xilinx\fir_0251_Proc.srcs\sources_1\bd\core\ip\core_mig_7series_1_0\core_mig_7series_1_0\user_design\rtl\axi\mig_7series_v2_0_axi_ctrl_addr_decode.v]
Enabled=1
[file:.\..\xilinx\fir_0251_Proc.srcs\sources_1\bd\core\ip\core_mig_7series_1_0\core_mig_7series_1_0\user_design\rtl\axi\mig_7series_v2_0_axi_ctrl_read.v]
Enabled=1
[file:.\..\xilinx\fir_0251_Proc.srcs\sources_1\bd\core\ip\core_mig_7series_1_0\core_mig_7series_1_0\user_design\rtl\axi\mig_7series_v2_0_axi_ctrl_reg.v]
Enabled=1
[file:.\..\xilinx\fir_0251_Proc.srcs\sources_1\bd\core\ip\core_mig_7series_1_0\core_mig_7series_1_0\user_design\rtl\axi\mig_7series_v2_0_axi_ctrl_reg_bank.v]
Enabled=1
[file:.\..\xilinx\fir_0251_Proc.srcs\sources_1\bd\core\ip\core_mig_7series_1_0\core_mig_7series_1_0\user_design\rtl\axi\mig_7series_v2_0_axi_ctrl_top.v]
Enabled=1
[file:.\..\xilinx\fir_0251_Proc.srcs\sources_1\bd\core\ip\core_mig_7series_1_0\core_mig_7series_1_0\user_design\rtl\axi\mig_7series_v2_0_axi_ctrl_write.v]
Enabled=1
[file:.\..\xilinx\fir_0251_Proc.srcs\sources_1\bd\core\ip\core_mig_7series_1_0\core_mig_7series_1_0\user_design\rtl\axi\mig_7series_v2_0_axi_mc.v]
Enabled=1
[file:.\..\xilinx\fir_0251_Proc.srcs\sources_1\bd\core\ip\core_mig_7series_1_0\core_mig_7series_1_0\user_design\rtl\axi\mig_7series_v2_0_axi_mc_ar_channel.v]
Enabled=1
[file:.\..\xilinx\fir_0251_Proc.srcs\sources_1\bd\core\ip\core_mig_7series_1_0\core_mig_7series_1_0\user_design\rtl\axi\mig_7series_v2_0_axi_mc_aw_channel.v]
Enabled=1
[file:.\..\xilinx\fir_0251_Proc.srcs\sources_1\bd\core\ip\core_mig_7series_1_0\core_mig_7series_1_0\user_design\rtl\axi\mig_7series_v2_0_axi_mc_b_channel.v]
Enabled=1
[file:.\..\xilinx\fir_0251_Proc.srcs\sources_1\bd\core\ip\core_mig_7series_1_0\core_mig_7series_1_0\user_design\rtl\axi\mig_7series_v2_0_axi_mc_cmd_arbiter.v]
Enabled=1
[file:.\..\xilinx\fir_0251_Proc.srcs\sources_1\bd\core\ip\core_mig_7series_1_0\core_mig_7series_1_0\user_design\rtl\axi\mig_7series_v2_0_axi_mc_cmd_fsm.v]
Enabled=1
[file:.\..\xilinx\fir_0251_Proc.srcs\sources_1\bd\core\ip\core_mig_7series_1_0\core_mig_7series_1_0\user_design\rtl\axi\mig_7series_v2_0_axi_mc_cmd_translator.v]
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
Enabled=1
[file:.\..\xilinx\fir_0251_Proc.srcs\sources_1\bd\core\ip\core_mig_7series_1_0\core_mig_7series_1_0\user_design\rtl\ecc\mig_7series_v2_0_ecc_buf.v]
Enabled=1
[file:.\..\xilinx\fir_0251_Proc.srcs\sources_1\bd\core\ip\core_mig_7series_1_0\core_mig_7series_1_0\user_design\rtl\ecc\mig_7series_v2_0_ecc_dec_fix.v]
Enabled=1
[file:.\..\xilinx\fir_0251_Proc.srcs\sources_1\bd\core\ip\core_mig_7series_1_0\core_mig_7series_1_0\user_design\rtl\ecc\mig_7series_v2_0_ecc_gen.v]
Enabled=1
[file:.\..\xilinx\fir_0251_Proc.srcs\sources_1\bd\core\ip\core_mig_7series_1_0\core_mig_7series_1_0\user_design\rtl\ecc\mig_7series_v2_0_ecc_merge_enc.v]
Enabled=1
[file:.\..\xilinx\fir_0251_Proc.srcs\sources_1\bd\core\ip\core_mig_7series_1_0\core_mig_7series_1_0\user_design\rtl\ecc\mig_7series_v2_0_fi_xor.v]
Enabled=1
[file:.\..\xilinx\fir_0251_Proc.srcs\sources_1\bd\core\ip\core_mig_7series_1_0\core_mig_7series_1_0\user_design\rtl\core_mig_7series_1_0_mig.v]
Enabled=1
[file:.\..\xilinx\fir_0251_Proc.srcs\sources_1\bd\core\ip\core_mig_7series_1_0\core_mig_7series_1_0\user_design\rtl\core_mig_7series_1_0.v]
Enabled=1
[file:.\src\MicroBlaze_tb.bde]
Enabled=1
[file:.\src\Testbench\Microblaze\MicroBlaze_tb.bde]
Enabled=1
[file:.\src\Testbench\Microblaze\microblaze_stim.vhd]
Enabled=1
[file:.\compile\MicroBlaze_tb.vhd]
Generated=TRUE
Enabled=1
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
