gbrangeon-telops/irc_fir-00251-proc/aldec/src/FPA/isc0207A_3k/compile.cfg

[View]
Entity=isc0207a_3k_intf_testbench_tb
Architecture=TB_ARCHITECTURE
TopLevelType=1
[file:.\..\..\..\..\src\FPA\isc0207A_3k\HDL\compil_isc0207A_3k.do]
Enabled=1
[file:.\..\..\..\..\src\FPA\isc0207A_3k\HDL\FPA_define.vhd]
Enabled=1
[file:.\..\..\..\..\src\FPA\isc0207A_3k\HDL\isc0207A_3k_bitstream_gen.vhd]
Enabled=1
[file:.\..\..\..\..\src\FPA\isc0207A_3k\HDL\isc0207A_3k_clks_gen.bde]
Enabled=1
[file:.\..\..\..\..\src\FPA\isc0207A_3k\HDL\isc0207A_3k_clks_gen_core.vhd]
Enabled=1
[file:.\..\..\..\..\src\FPA\isc0207A_3k\HDL\isc0207A_3k_clks_mmcm.vhd]
Enabled=1
[file:.\..\..\..\..\src\FPA\isc0207A_3k\HDL\isc0207A_3k_digio_map.vhd]
Enabled=1
[file:.\..\..\..\..\src\FPA\isc0207A_3k\HDL\isc0207A_3k_hw_driver.bde]
Enabled=1
[file:.\..\..\..\..\src\FPA\isc0207A_3k\HDL\isc0207A_3k_intf.bde]
Enabled=1
[file:.\..\..\..\..\src\FPA\isc0207A_3k\HDL\isc0207A_3k_mblaze_intf.vhd]
Enabled=1
[file:.\..\..\..\..\src\FPA\isc0207A_3k\HDL\isc0207A_3k_prog_ctrler.bde]
Enabled=1
[file:.\..\..\..\..\src\FPA\isc0207A_3k\HDL\isc0207A_3k_prog_spi_feeder.vhd]
Enabled=1
[file:.\..\..\..\..\src\FPA\isc0207A_3k\HDL\isc0207A_3k_readout_ctrler.vhd]
Enabled=1
[file:.\..\..\..\..\src\FPA\isc0207A_3k\HDL\isc0207A_3k_spi_feeder.vhd]
Enabled=1
[file:.\..\..\..\..\src\FPA\isc0207A_3k\HDL\proxy_define.vhd]
Enabled=1
[file:.\..\..\..\..\..\Common_HDL\Common_Projects\TEL2000\FPA_common\src\ad5648_driver.vhd]
Enabled=1
[file:.\..\..\..\..\..\Common_HDL\Common_Projects\TEL2000\FPA_common\src\adc_brd_define.vhd]
Enabled=1
[file:.\..\..\..\..\..\Common_HDL\Common_Projects\TEL2000\FPA_common\src\adc_brd_id_reader.vhd]
Enabled=1
[file:.\..\..\..\..\..\Common_HDL\Common_Projects\TEL2000\FPA_common\src\adc_brd_switch_ctrl.vhd]
Enabled=1
[file:.\..\..\..\..\..\Common_HDL\Common_Projects\TEL2000\FPA_common\src\afpa_chn_diversity_ctrler.vhd]
Enabled=1
[file:.\..\..\..\..\..\Common_HDL\Common_Projects\TEL2000\FPA_common\src\afpa_data_ctrl.bde]
Enabled=1
[file:.\..\..\..\..\..\Common_HDL\Common_Projects\TEL2000\FPA_common\src\afpa_data_ctrl_16chn.bde]
Enabled=1
[file:.\..\..\..\..\..\Common_HDL\Common_Projects\TEL2000\FPA_common\src\afpa_data_ctrl_map.vhd]
Enabled=1
[file:.\..\..\..\..\..\Common_HDL\Common_Projects\TEL2000\FPA_common\src\afpa_data_dispatcher.vhd]
Enabled=1
[file:.\..\..\..\..\..\Common_HDL\Common_Projects\TEL2000\FPA_common\src\afpa_data_mux.vhd]
Enabled=1
[file:.\..\..\..\..\..\Common_HDL\Common_Projects\TEL2000\FPA_common\src\afpa_diag_data_gen.vhd]
Enabled=1
[file:.\..\..\..\..\..\Common_HDL\Common_Projects\TEL2000\FPA_common\src\afpa_dval_gen.bde]
Enabled=1
[file:.\..\..\..\..\..\Common_HDL\Common_Projects\TEL2000\FPA_common\src\afpa_flow_mux.vhd]
Enabled=1
[file:.\..\..\..\..\..\Common_HDL\Common_Projects\TEL2000\FPA_common\src\afpa_hsample_proc.bde]
Enabled=1
[file:.\..\..\..\..\..\Common_HDL\Common_Projects\TEL2000\FPA_common\src\afpa_hw_driver_ctrler.vhd]
Enabled=1
[file:.\..\..\..\..\..\Common_HDL\Common_Projects\TEL2000\FPA_common\src\afpa_int_signal_gen.vhd]
Enabled=1
[file:.\..\..\..\..\..\Common_HDL\Common_Projects\TEL2000\FPA_common\src\afpa_pixel_reorder.vhd]
Enabled=1
[file:.\..\..\..\..\..\Common_HDL\Common_Projects\TEL2000\FPA_common\src\afpa_real_mode_dval_gen.vhd]
Enabled=1
[file:.\..\..\..\..\..\Common_HDL\Common_Projects\TEL2000\FPA_common\src\afpa_sample_counter.vhd]
Enabled=1
[file:.\..\..\..\..\..\Common_HDL\Common_Projects\TEL2000\FPA_common\src\afpa_sample_mean.vhd]
Enabled=1
[file:.\..\..\..\..\..\Common_HDL\Common_Projects\TEL2000\FPA_common\src\afpa_sample_selector.vhd]
Enabled=1
[file:.\..\..\..\..\..\Common_HDL\Common_Projects\TEL2000\FPA_common\src\afpa_sample_sum.vhd]
Enabled=1
[file:.\..\..\..\..\..\Common_HDL\Common_Projects\TEL2000\FPA_common\src\afpa_services.bde]
Enabled=1
[file:.\..\..\..\..\..\Common_HDL\Common_Projects\TEL2000\FPA_common\src\afpa_services_ctrl.vhd]
Enabled=1
[file:.\..\..\..\..\..\Common_HDL\Common_Projects\TEL2000\FPA_common\src\afpa_vsample_proc.bde]
Enabled=1
[file:.\..\..\..\..\..\Common_HDL\Common_Projects\TEL2000\FPA_common\src\brd_id_reader.vhd]
Enabled=1
[file:.\..\..\..\..\..\Common_HDL\Common_Projects\TEL2000\FPA_common\src\fleg_brd_define.vhd]
Enabled=1
[file:.\..\..\..\..\..\Common_HDL\Common_Projects\TEL2000\FPA_common\src\fleG_dac_spi_feeder.vhd]
Enabled=1
[file:.\..\..\..\..\..\Common_HDL\Common_Projects\TEL2000\FPA_common\src\fleg_prog_ctler_kernel.vhd]
Enabled=1
[file:.\..\..\..\..\..\Common_HDL\Common_Projects\TEL2000\FPA_common\src\fleG_prog_ctrler.bde]
Enabled=1
[file:.\..\..\..\..\..\Common_HDL\Common_Projects\TEL2000\FPA_common\src\flex_brd_id_reader.vhd]
Enabled=1
[file:.\..\..\..\..\..\Common_HDL\Common_Projects\TEL2000\FPA_common\src\fpa_common_pkg.vhd]
Enabled=1
[file:.\..\..\..\..\..\Common_HDL\Common_Projects\TEL2000\FPA_common\src\fpa_diag_line_gen.vhd]
Enabled=1
[file:.\..\..\..\..\..\Common_HDL\Common_Projects\TEL2000\FPA_common\src\fpa_intf_sequencer.vhd]
Enabled=1
[file:.\..\..\..\..\..\Common_HDL\Common_Projects\TEL2000\FPA_common\src\fpa_status_gen.vhd]
Enabled=1
[file:.\..\..\..\..\..\Common_HDL\Common_Projects\TEL2000\FPA_common\src\fpa_trig_controller.vhd]
Enabled=1
[file:.\..\..\..\..\..\Common_HDL\Common_Projects\TEL2000\FPA_common\src\LL8_ext_fifo8.vhd]
Enabled=1
[file:.\..\..\..\..\..\Common_HDL\Common_Projects\TEL2000\FPA_common\src\LL8_ext_to_spi_tx.vhd]
Enabled=1
[file:.\..\..\..\..\..\Common_HDL\Common_Projects\TEL2000\FPA_common\src\monitoring_adc_ctrl.vhd]
Enabled=1
[file:.\..\..\..\..\..\Common_HDL\Common_Projects\TEL2000\FPA_common\src\signal_filter.vhd]
Enabled=1
[file:.\..\..\..\..\..\Common_HDL\Common_Projects\TEL2000\FPA_common\src\spi_mux_ctler.vhd]
Enabled=1
[file:.\src\TestBench\isc0207a_3k_intf_testbench_TB.vhd]
Enabled=1
[file:.\src\TestBench\isc0207a_3k_intf_testbench_TB_runtest.do]
Enabled=1
[file:.\compile\afpa_dval_gen.vhd]
Generated=TRUE
Enabled=1
[file:.\compile\afpa_hsample_proc.vhd]
Generated=TRUE
Enabled=1
[file:.\compile\afpa_vsample_proc.vhd]
Generated=TRUE
Enabled=1
[file:.\compile\afpa_data_ctrl.vhd]
Generated=TRUE
Enabled=1
[file:.\compile\afpa_data_ctrl_16chn.vhd]
Generated=TRUE
Enabled=1
[file:.\compile\afpa_services.vhd]
Generated=TRUE
Enabled=1
[file:.\compile\fleG_prog_ctrler.vhd]
Generated=TRUE
Enabled=1
[file:.\compile\isc0207A_3k_clks_gen.vhd]
Generated=TRUE
Enabled=1
[file:.\compile\isc0207A_3k_prog_ctrler.vhd]
Generated=TRUE
Enabled=1
[file:.\compile\isc0207A_3k_hw_driver.vhd]
Generated=TRUE
Enabled=1
[file:.\compile\isc0207A_3k_intf.vhd]
Generated=TRUE
Enabled=1
[file:.\src\isc0207A_3k_intf_testbench.bde]
Enabled=1
[file:.\compile\isc0207A_3k_intf_testbench.vhd]
Generated=TRUE
Enabled=1
[file:.\src\FPA\isc0207A_3k\HDL\compil_isc0207A_3k.do]
Enabled=1
[file:.\src\FPA\isc0207A_3k\HDL\FPA_define.vhd]
Enabled=1
[file:.\src\FPA\isc0207A_3k\HDL\isc0207A_3k_bitstream_gen.vhd]
Enabled=1
[file:.\src\FPA\isc0207A_3k\HDL\isc0207A_3k_clks_gen.bde]
Enabled=1
[file:.\src\FPA\isc0207A_3k\HDL\isc0207A_3k_clks_gen_core.vhd]
Enabled=1
[file:.\src\FPA\isc0207A_3k\HDL\isc0207A_3k_clks_mmcm.vhd]
Enabled=1
[file:.\src\FPA\isc0207A_3k\HDL\isc0207A_3k_digio_map.vhd]
Enabled=1
[file:.\src\FPA\isc0207A_3k\HDL\isc0207A_3k_hw_driver.bde]
Enabled=1
[file:.\src\FPA\isc0207A_3k\HDL\isc0207A_3k_intf.bde]
Enabled=1
[file:.\src\FPA\isc0207A_3k\HDL\isc0207A_3k_mblaze_intf.vhd]
Enabled=1
[file:.\src\FPA\isc0207A_3k\HDL\isc0207A_3k_prog_ctrler.bde]
Enabled=1
[file:.\src\FPA\isc0207A_3k\HDL\isc0207A_3k_readout_ctrler.vhd]
Enabled=1
[file:.\src\FPA\isc0207A_3k\HDL\isc0207A_3k_spi_feeder.vhd]
Enabled=1
[file:.\src\FPA\isc0207A_3k\HDL\proxy_define.vhd]
Enabled=1
[file:.\..\Common_HDL\Common_Projects\TEL2000\FPA_common\src\ad5648_driver.vhd]
Enabled=1
[file:.\..\Common_HDL\Common_Projects\TEL2000\FPA_common\src\adc_brd_define.vhd]
Enabled=1
[file:.\..\Common_HDL\Common_Projects\TEL2000\FPA_common\src\adc_brd_id_reader.vhd]
Enabled=1
[file:.\..\Common_HDL\Common_Projects\TEL2000\FPA_common\src\adc_brd_switch_ctrl.vhd]
Enabled=1
[file:.\..\Common_HDL\Common_Projects\TEL2000\FPA_common\src\afpa_chn_diversity_ctrler.vhd]
Enabled=1
[file:.\..\Common_HDL\Common_Projects\TEL2000\FPA_common\src\afpa_data_ctrl.bde]
Enabled=1
[file:.\..\Common_HDL\Common_Projects\TEL2000\FPA_common\src\afpa_data_ctrl_16chn.bde]
Enabled=1
[file:.\..\Common_HDL\Common_Projects\TEL2000\FPA_common\src\afpa_data_ctrl_map.vhd]
Enabled=1
[file:.\..\Common_HDL\Common_Projects\TEL2000\FPA_common\src\afpa_data_dispatcher.vhd]
Enabled=1
[file:.\..\Common_HDL\Common_Projects\TEL2000\FPA_common\src\afpa_data_mux.vhd]
Enabled=1
[file:.\..\Common_HDL\Common_Projects\TEL2000\FPA_common\src\afpa_diag_data_gen.vhd]
Enabled=1
[file:.\..\Common_HDL\Common_Projects\TEL2000\FPA_common\src\afpa_dval_gen.bde]
Enabled=1
[file:.\..\Common_HDL\Common_Projects\TEL2000\FPA_common\src\afpa_flow_mux.vhd]
Enabled=1
[file:.\..\Common_HDL\Common_Projects\TEL2000\FPA_common\src\afpa_hsample_proc.bde]
Enabled=1
[file:.\..\Common_HDL\Common_Projects\TEL2000\FPA_common\src\afpa_hw_driver_ctrler.vhd]
Enabled=1
[file:.\..\Common_HDL\Common_Projects\TEL2000\FPA_common\src\afpa_int_signal_gen.vhd]
Enabled=1
[file:.\..\Common_HDL\Common_Projects\TEL2000\FPA_common\src\afpa_pixel_reorder.vhd]
Enabled=1
[file:.\..\Common_HDL\Common_Projects\TEL2000\FPA_common\src\afpa_real_mode_dval_gen.vhd]
Enabled=1
[file:.\..\Common_HDL\Common_Projects\TEL2000\FPA_common\src\afpa_sample_counter.vhd]
Enabled=1
[file:.\..\Common_HDL\Common_Projects\TEL2000\FPA_common\src\afpa_sample_mean.vhd]
Enabled=1
[file:.\..\Common_HDL\Common_Projects\TEL2000\FPA_common\src\afpa_sample_selector.vhd]
Enabled=1
[file:.\..\Common_HDL\Common_Projects\TEL2000\FPA_common\src\afpa_sample_sum.vhd]
Enabled=1
[file:.\..\Common_HDL\Common_Projects\TEL2000\FPA_common\src\afpa_services.bde]
Enabled=1
[file:.\..\Common_HDL\Common_Projects\TEL2000\FPA_common\src\afpa_services_ctrl.vhd]
Enabled=1
[file:.\..\Common_HDL\Common_Projects\TEL2000\FPA_common\src\afpa_vsample_proc.bde]
Enabled=1
[file:.\..\Common_HDL\Common_Projects\TEL2000\FPA_common\src\brd_id_reader.vhd]
Enabled=1
[file:.\..\Common_HDL\Common_Projects\TEL2000\FPA_common\src\fleg_brd_define.vhd]
Enabled=1
[file:.\..\Common_HDL\Common_Projects\TEL2000\FPA_common\src\fleG_dac_spi_feeder.vhd]
Enabled=1
[file:.\..\Common_HDL\Common_Projects\TEL2000\FPA_common\src\fleg_prog_ctler_kernel.vhd]
Enabled=1
[file:.\..\Common_HDL\Common_Projects\TEL2000\FPA_common\src\fleG_prog_ctrler.bde]
Enabled=1
[file:.\..\Common_HDL\Common_Projects\TEL2000\FPA_common\src\flex_brd_id_reader.vhd]
Enabled=1
[file:.\..\Common_HDL\Common_Projects\TEL2000\FPA_common\src\fpa_common_pkg.vhd]
Enabled=1
[file:.\..\Common_HDL\Common_Projects\TEL2000\FPA_common\src\fpa_diag_line_gen.vhd]
Enabled=1
[file:.\..\Common_HDL\Common_Projects\TEL2000\FPA_common\src\fpa_intf_sequencer.vhd]
Enabled=1
[file:.\..\Common_HDL\Common_Projects\TEL2000\FPA_common\src\fpa_status_gen.vhd]
Enabled=1
[file:.\..\Common_HDL\Common_Projects\TEL2000\FPA_common\src\fpa_trig_controller.vhd]
Enabled=1
[file:.\..\Common_HDL\Common_Projects\TEL2000\FPA_common\src\LL8_ext_fifo8.vhd]
Enabled=1
[file:.\..\Common_HDL\Common_Projects\TEL2000\FPA_common\src\LL8_ext_to_spi_tx.vhd]
Enabled=1
[file:.\..\Common_HDL\Common_Projects\TEL2000\FPA_common\src\monitoring_adc_ctrl.vhd]
Enabled=1
[file:.\..\Common_HDL\Common_Projects\TEL2000\FPA_common\src\signal_filter.vhd]
Enabled=1
[file:.\..\Common_HDL\Common_Projects\TEL2000\FPA_common\src\spi_mux_ctler.vhd]
Enabled=1
[file:.\src\var_shift_reg_w16_d32.vhd]
Enabled=1
[file:.\..\..\..\..\..\Common_HDL\Common_Projects\TEL2000\FPA_common\src\afpa_lsync_mode_dval_gen.vhd]
Enabled=1
[file:.\..\Common_HDL\Common_Projects\TEL2000\FPA_common\src\afpa_lsync_mode_dval_gen.vhd]
Enabled=1
[file:.\..\..\..\..\src\FPA\isc0207A_3k\HDL\isc0207A_3k_readout_kernel.vhd]
Enabled=1
[file:.\src\TestBench\isc0207a_3k_intf_testbench_pkg.vhd]
Enabled=1
[file:.\src\FPA\isc0207A_3k\HDL\isc0207A_3k_readout_kernel.vhd]
Enabled=1
[file:.\..\..\..\..\src\FPA\isc0207A_3k\HDL\isc0207A_3k_elcorr_refs_ctrl.vhd]
Enabled=1
[file:.\src\FPA\isc0207A_3k\HDL\isc0207A_3k_elcorr_refs_ctrl.vhd]
Enabled=1
[file:.\..\..\..\..\src\FPA\isc0207A_3k\HDL\isc0207A_3k_hw_prog.bde]
Enabled=1
[file:.\compile\isc0207A_3k_hw_prog.vhd]
Generated=TRUE
Enabled=1
[file:.\src\FPA\isc0207A_3k\HDL\isc0207A_3k_hw_prog.bde]
Enabled=1
