gbrangeon-telops/irc_fir-00251-proc/aldec/src/FPA/bb1920D/compile.cfg

[View]
Entity=BB1920D_intf_testbench_tb
Architecture=TB_ARCHITECTURE
TopLevelType=1
[file:.\..\..\..\..\src\FPA\scd_proxy2\HDL\scd_proxy2_data_ctrl.bde]
Enabled=1
[file:.\..\..\..\..\src\FPA\scd_proxy2\HDL\scd_proxy2_dval_gen.bde]
Enabled=1
[file:.\..\..\..\..\src\FPA\scd_proxy2\HDL\scd_proxy2_hw_driver.bde]
Enabled=1
[file:.\..\..\..\..\src\FPA\scd_proxy2\HDL\scd_proxy2_intf.bde]
Enabled=1
[file:.\..\..\..\..\src\FPA\scd_proxy2\HDL\compil_scd_proxy2.do]
Enabled=1
[file:.\..\..\..\..\src\FPA\scd_proxy2\HDL\FPA_define.vhd]
Enabled=1
[file:.\..\..\..\..\src\FPA\scd_proxy2\HDL\proxy_define.vhd]
Enabled=1
[file:.\..\..\..\..\src\FPA\scd_proxy2\HDL\scd_proxy2_bridge.vhd]
Enabled=1
[file:.\..\..\..\..\src\FPA\scd_proxy2\HDL\scd_proxy2_clocks.vhd]
Enabled=1
[file:.\..\..\..\..\src\FPA\scd_proxy2\HDL\scd_proxy2_io_intf.vhd]
Enabled=1
[file:.\..\..\..\..\src\FPA\scd_proxy2\HDL\scd_proxy2_line_mux.vhd]
Enabled=1
[file:.\..\..\..\..\src\FPA\scd_proxy2\HDL\scd_proxy2_mblaze_intf.vhd]
Enabled=1
[file:.\..\..\..\..\src\FPA\scd_proxy2\HDL\scd_proxy2_prog_ctrler.vhd]
Enabled=1
[file:.\..\..\..\..\src\FPA\scd_proxy2\HDL\scd_proxy2_real_data.vhd]
Enabled=1
[file:.\..\..\..\..\src\FPA\scd_proxy2\HDL\scd_proxy2_serial_com.vhd]
Enabled=1
[file:.\src\TestBench\bb1920D_intf_testbench_pkg.vhd]
Enabled=1
[file:.\src\TestBench\bb1920D_intf_testbench_TB.vhd]
Enabled=1
[file:.\src\TestBench\bb1920D_intf_testbench_TB_runtest.do]
Enabled=1
[file:.\src\bb1920_intf_testbench.bde]
Enabled=1
[file:.\compile\scd_proxy2_dval_gen.vhd]
Generated=TRUE
Enabled=1
[file:.\compile\scd_proxy2_data_ctrl.vhd]
Generated=TRUE
Enabled=1
[file:.\compile\scd_proxy2_hw_driver.vhd]
Generated=TRUE
Enabled=1
[file:.\compile\scd_proxy2_intf.vhd]
Generated=TRUE
Enabled=1
[file:.\src\TestBench\sim_data_gen.bde]
Enabled=1
[file:.\compile\sim_data_gen.vhd]
Generated=TRUE
Enabled=1
[file:.\compile\bb1920_intf_testbench.vhd]
Generated=TRUE
Enabled=1
[file:.\..\..\..\..\..\Common_HDL\Common_Projects\TEL2000\FPA_common\src\fpa_diag_line_gen.vhd]
Enabled=1
[file:.\..\..\..\..\..\Common_HDL\Common_Projects\TEL2000\FPA_common\src\afpa_diag_data_gen.vhd]
Enabled=1
[file:.\src\TestBench\bb1920_data_gen.vhd]
Enabled=1
[file:.\..\..\..\..\..\Common_HDL\Common_Projects\TEL2000\FPA_common\src\fpa_progr_clk_div.vhd]
Enabled=1
[file:.\..\..\..\..\src\bb1920_serdes\HDL\scd_proxy2_dout.vhd]
Enabled=1
[file:.\..\..\..\..\src\bb1920_serdes\HDL\scd_proxy2_dsync.vhd]
Enabled=1
[file:.\..\..\..\..\src\bb1920_serdes\HDL\scd_proxy2_serdes.bde]
Enabled=1
[file:.\..\..\..\..\src\bb1920_serdes\HDL\bb1920_deserializer.bde]
Enabled=1
[file:.\..\..\..\..\src\FPA\blackbird1920D\HDL\FPA_define.vhd]
Enabled=1
[file:.\src\FPA\blackbird1920D\HDL\FPA_define.vhd]
Enabled=1
[file:.\src\FPA\scd_proxy2\HDL\scd_proxy2_data_ctrl.bde]
Enabled=1
[file:.\src\FPA\scd_proxy2\HDL\scd_proxy2_dval_gen.bde]
Enabled=1
[file:.\src\FPA\scd_proxy2\HDL\scd_proxy2_hw_driver.bde]
Enabled=1
[file:.\src\FPA\scd_proxy2\HDL\scd_proxy2_intf.bde]
Enabled=1
[file:.\src\FPA\scd_proxy2\HDL\compil_scd_proxy2.do]
Enabled=1
[file:.\src\FPA\scd_proxy2\HDL\proxy_define.vhd]
Enabled=1
[file:.\src\FPA\scd_proxy2\HDL\scd_proxy2_bridge.vhd]
Enabled=1
[file:.\src\FPA\scd_proxy2\HDL\scd_proxy2_clocks.vhd]
Enabled=1
[file:.\src\FPA\scd_proxy2\HDL\scd_proxy2_io_intf.vhd]
Enabled=1
[file:.\src\FPA\scd_proxy2\HDL\scd_proxy2_line_mux.vhd]
Enabled=1
[file:.\src\FPA\scd_proxy2\HDL\scd_proxy2_mblaze_intf.vhd]
Enabled=1
[file:.\src\FPA\scd_proxy2\HDL\scd_proxy2_prog_ctrler.vhd]
Enabled=1
[file:.\src\FPA\scd_proxy2\HDL\scd_proxy2_real_data.vhd]
Enabled=1
[file:.\src\FPA\scd_proxy2\HDL\scd_proxy2_serial_com.vhd]
Enabled=1
[file:.\..\Common_HDL\Common_Projects\TEL2000\FPA_common\src\fpa_diag_line_gen.vhd]
Enabled=1
[file:.\..\Common_HDL\Common_Projects\TEL2000\FPA_common\src\fpa_progr_clk_div.vhd]
Enabled=1
[file:.\..\Common_HDL\Common_Projects\TEL2000\FPA_common\src\afpa_diag_data_gen.vhd]
Enabled=1
[file:.\..\..\..\..\src\FPA\scd_proxy2\HDL\scd_proxy2_binning_mux.vhd]
Enabled=1
[file:.\src\scd_proxy2_line_mux.bde]
Enabled=1
[file:.\compile\scd_proxy2_line_mux.vhd]
Generated=TRUE
Enabled=1
[file:.\src\scd_proxy2_mux.bde]
Enabled=1
[file:.\..\..\..\..\src\FPA\scd_proxy2\HDL\scd_proxy2_mux.bde]
Enabled=1
[file:.\..\..\..\..\src\FPA\scd_proxy2\HDL\scd_proxy2_mux_sw.vhd]
Enabled=1
[file:.\compile\scd_proxy2_mux.vhd]
Generated=TRUE
Enabled=1
[file:.\..\..\..\..\src\FPA\scd_proxy2\HDL\scd_proxy2_mux_binning_core.vhd]
Enabled=1
[file:.\..\..\..\..\src\FPA\scd_proxy2\HDL\scd_proxy2_mux_input_sw.vhd]
Enabled=1
[file:.\..\..\..\..\src\FPA\scd_proxy2\HDL\scd_proxy2_mux_output_sw.vhd]
Enabled=1
[file:.\..\..\..\..\src\FPA\scd_proxy2\HDL\scd_proxy2_mux_std_core.vhd]
Enabled=1
[file:.\..\..\..\..\untitled.asdb]
Enabled=1
[file:.\..\..\..\..\untitled.awc]
Enabled=1
[file:.\src\wave_1.awc]
Enabled=1
[file:.\src\untitled.asdb]
Enabled=1
[file:.\src\untitled.awc]
Enabled=1
[file:.\..\..\..\..\..\FIR-00251-Proc-trunk\aldec\src\FPA\bb1920D\src\untitled.awc]
Enabled=1
