gbrangeon-telops/irc_fir-00251-proc/aldec/src/bb1920_serdes/compile.cfg

[View]
Entity=bb1920_deserializer_tb_tb
Architecture=TB_ARCHITECTURE
TopLevelType=1
[file:.\..\..\..\src\bb1920_serdes\HDL\compil_bb1920_receiver.do]
Enabled=1
[file:.\..\..\..\src\bb1920_serdes\HDL\bb1920_deserializer.bde]
Enabled=1
[file:.\..\..\..\src\bb1920_serdes\HDL\clink_serdes8_clk_wrapper.vhd]
Enabled=1
[file:.\..\..\..\src\bb1920_serdes\HDL\data_dispatcher.vhd]
Enabled=1
[file:.\..\..\..\src\bb1920_serdes\HDL\fifo_generator_1_sim_netlist.vhdl]
Enabled=1
[file:.\..\..\..\src\bb1920_serdes\HDL\fifo_generator_1_stub.vhdl]
Enabled=1
[file:.\..\..\..\src\bb1920_serdes\HDL\scd_proxy2_dout.vhd]
Enabled=1
[file:.\..\..\..\src\bb1920_serdes\HDL\scd_proxy2_dsync.vhd]
Enabled=1
[file:.\compile\bb1920_deserializer.vhd]
Generated=TRUE
Enabled=1
[file:.\src\bb1920_deserializer_tb.bde]
Enabled=1
[file:.\src\bb1920_data_gen.bde]
Enabled=1
[file:.\src\dual_data_serializer.bde]
Enabled=1
[file:.\..\..\..\..\Common_HDL\Common_Projects\TEL2000\FPA_common\src\LL8_ext_fifo8.vhd]
Enabled=1
[file:.\..\..\..\..\Common_HDL\Common_Projects\TEL2000\FPA_common\src\LL8_ext_to_spi_tx.vhd]
Enabled=1
[file:.\compile\dual_data_serializer.vhd]
Generated=TRUE
Enabled=1
[file:.\src\bb1920_data_gen_dispatcher.vhd]
Enabled=1
[file:.\..\..\..\..\Common_HDL\Common_Projects\TEL2000\FPA_common\src\fpa_common_pkg.vhd]
Enabled=1
[file:.\compile\bb1920_deserializer_tb.vhd]
Generated=TRUE
Enabled=1
[file:.\..\..\..\src\FPA\blackbird1920D\HDL\FPA_define.vhd]
Enabled=1
[file:.\..\..\..\src\FPA\scd_proxy2\HDL\proxy_define.vhd]
Enabled=1
[file:.\..\..\..\src\FPA\blackbird1920D\HDL\compil_blackbird1920D.do]
Enabled=1
[file:.\src\TestBench\bb1920_deserializer_tb_TB.vhd]
Enabled=1
LIB=
[file:.\src\TestBench\bb1920_deserializer_tb_TB_runtest.do]
Enabled=1
[file:.\src\iserdes_wrapper.vhd]
Enabled=1
[file:.\..\..\..\src\bb1920_serdes\HDL\scd_proxy2_serdes.bde]
Enabled=1
[file:.\compile\scd_proxy2_serdes.vhd]
Generated=TRUE
Enabled=1
[file:.\src\LL8_to_serial.vhd]
Enabled=1
[file:.\..\..\..\..\FIR-00251-Common\VHDL\iserdes\clink\clink_bitslip_ctrl.vhd]
Enabled=1
[file:.\..\..\..\..\FIR-00251-Common\VHDL\iserdes\clink\clink_calibration.bde]
Enabled=1
[file:.\..\..\..\..\FIR-00251-Common\VHDL\iserdes\clink\clink_delay_ctrl.vhd]
Enabled=1
[file:.\..\..\..\..\FIR-00251-Common\VHDL\iserdes\clink\clink_delay_validator.bde]
Enabled=1
[file:.\..\..\..\..\FIR-00251-Common\VHDL\iserdes\clink\clink_delay_validator_core.vhd]
Enabled=1
[file:.\..\..\..\..\FIR-00251-Common\VHDL\iserdes\clink\clink_signals_validator.bde]
Enabled=1
[file:.\..\..\..\..\FIR-00251-Common\VHDL\iserdes\clink\clink_validator_ctrler.vhd]
Enabled=1
[file:.\..\..\..\..\FIR-00251-Common\VHDL\iserdes\clink\high_duration_meas.vhd]
Enabled=1
[file:.\compile\clink_signals_validator.vhd]
Generated=TRUE
Enabled=1
[file:.\compile\clink_delay_validator.vhd]
Generated=TRUE
Enabled=1
[file:.\compile\clink_calibration.vhd]
Generated=TRUE
Enabled=1
[file:.\..\..\..\..\Common_HDL\gh_vhdl_lib\custom_MSI\gh_stretch.vhd]
Enabled=1
[file:.\Common_HDL\Common_Projects\TEL2000\FPA_common\src\fpa_common_pkg.vhd]
Enabled=1
[file:.\FIR-00251-Common\VHDL\iserdes\clink\clink_bitslip_ctrl.vhd]
Enabled=1
[file:.\FIR-00251-Common\VHDL\iserdes\clink\clink_calibration.bde]
Enabled=1
[file:.\FIR-00251-Common\VHDL\iserdes\clink\clink_delay_ctrl.vhd]
Enabled=1
[file:.\FIR-00251-Common\VHDL\iserdes\clink\clink_delay_validator.bde]
Enabled=1
[file:.\FIR-00251-Common\VHDL\iserdes\clink\clink_delay_validator_core.vhd]
Enabled=1
[file:.\FIR-00251-Common\VHDL\iserdes\clink\clink_signals_validator.bde]
Enabled=1
[file:.\FIR-00251-Common\VHDL\iserdes\clink\clink_validator_ctrler.vhd]
Enabled=1
[file:.\FIR-00251-Common\VHDL\iserdes\clink\high_duration_meas.vhd]
Enabled=1
[file:.\Common_HDL\gh_vhdl_lib\custom_MSI\gh_stretch.vhd]
Enabled=1
[file:.\src\untitled.awc]
Enabled=1
[file:.\src\untitled.asdb]
Enabled=1
