gbrangeon-telops/irc_fir-00251-proc/aldec/src/FPA/calcium640D/compile.cfg

[View]
Entity=calcium640D_intf_testbench_stim
Architecture=TB_ARCHITECTURE
TopLevelType=1
[file:.\src\calcium640D_intf_testbench.bde]
Enabled=1
[file:.\src\calcium640D_intf_testbench_pkg.vhd]
Enabled=1
[file:.\src\calcium640D_intf_testbench_TB.vhd]
Enabled=1
[file:.\src\calcium640D_intf_testbench_TB_runtest.do]
Enabled=1
[file:.\src\sim_data_gen.bde]
Enabled=1
[file:.\..\..\..\..\src\FPA\calcium640D\HDL\compil_calcium640D.do]
Enabled=1
[file:.\..\..\..\..\src\FPA\calcium640D\HDL\FPA_define.vhd]
Enabled=1
[file:.\..\..\..\..\src\FPA\calcium_proxy\HDL\compil_calcium_proxy.do]
Enabled=1
[file:.\..\..\..\..\src\FPA\calcium_proxy\HDL\proxy_define.vhd]
Enabled=1
[file:.\compile\sim_data_gen.vhd]
Generated=TRUE
Enabled=1
[file:.\compile\calcium640D_intf_testbench.vhd]
Generated=TRUE
Enabled=1
[file:.\..\..\..\..\src\FPA\calcium_proxy\HDL\calcium_clks_gen.vhd]
Enabled=1
[file:.\..\..\..\..\src\FPA\calcium_proxy\HDL\calcium_data_ctrl.bde]
Enabled=1
[file:.\..\..\..\..\src\FPA\calcium_proxy\HDL\calcium_data_dispatcher.vhd]
Enabled=1
LIB=Active library
Skip Entity=0
Netlist=1
Syntax 2002=1
Syntax 93=0
Syntax RelaxLRM=0
Syntax Disable 87=0
DisableAssertionsProcessing=0
Syntax 2008=0
[file:.\..\..\..\..\src\FPA\calcium_proxy\HDL\calcium_diag_data_gen.vhd]
Enabled=1
LIB=Active library
Skip Entity=0
Netlist=1
Syntax 2002=0
Syntax 93=0
Syntax RelaxLRM=0
Syntax Disable 87=0
DisableAssertionsProcessing=0
Syntax 2008=1
[file:.\..\..\..\..\src\FPA\calcium_proxy\HDL\calcium_flow_mux.vhd]
Enabled=1
[file:.\..\..\..\..\src\FPA\calcium_proxy\HDL\calcium_hw_driver.bde]
Enabled=1
[file:.\..\..\..\..\src\FPA\calcium_proxy\HDL\calcium_int_signal_gen.vhd]
Enabled=1
[file:.\..\..\..\..\src\FPA\calcium_proxy\HDL\calcium_intf.bde]
Enabled=1
[file:.\..\..\..\..\src\FPA\calcium_proxy\HDL\calcium_io_intf.vhd]
Enabled=1
[file:.\..\..\..\..\src\FPA\calcium_proxy\HDL\calcium_mblaze_intf.vhd]
Enabled=1
[file:.\..\..\..\..\src\FPA\calcium_proxy\HDL\calcium_prog_ctrler.bde]
Enabled=1
[file:.\..\..\..\..\src\FPA\calcium_proxy\HDL\calcium_prog_ctrler_core.vhd]
Enabled=1
[file:.\..\..\..\..\src\FPA\calcium_proxy\HDL\calcium_prog_spi_feeder.vhd]
Enabled=1
[file:.\..\..\..\..\src\FPA\calcium_proxy\HDL\calcium_quad_to_axis32.vhd]
Enabled=1
[file:.\..\..\..\..\src\FPA\calcium_proxy\HDL\calcium_rx_data_fifo.vhd]
Enabled=1
[file:.\..\..\..\..\src\FPA\calcium_proxy\HDL\calcium_services.bde]
Enabled=1
[file:.\..\..\..\..\src\FPA\calcium_proxy\HDL\calcium_services_ctrl.vhd]
Enabled=1
[file:.\compile\calcium_services.vhd]
Generated=TRUE
Enabled=1
[file:.\compile\calcium_prog_ctrler.vhd]
Generated=TRUE
Enabled=1
[file:.\compile\calcium_hw_driver.vhd]
Generated=TRUE
Enabled=1
[file:.\compile\calcium_data_ctrl.vhd]
Generated=TRUE
Enabled=1
[file:.\compile\calcium_intf.vhd]
Generated=TRUE
Enabled=1
[file:.\..\..\..\..\src\FPA\calcium_proxy\HDL\calcium_data_compression.bde]
Enabled=1
[file:.\..\..\..\..\src\FPA\calcium_proxy\HDL\compil_kpix_recombine.do]
Enabled=1
[file:.\..\..\..\..\src\FPA\calcium_proxy\HDL\kpix_bramaddr.vhd]
Enabled=1
[file:.\..\..\..\..\src\FPA\calcium_proxy\HDL\kpix_bramctrl.vhd]
Enabled=1
[file:.\..\..\..\..\src\FPA\calcium_proxy\HDL\kpix_bramwrapper.vhd]
Enabled=1
[file:.\..\..\..\..\src\FPA\calcium_proxy\HDL\kpix_dlypipeline.vhd]
Enabled=1
[file:.\..\..\..\..\src\FPA\calcium_proxy\HDL\kpix_pixelbldr.vhd]
Enabled=1
[file:.\..\..\..\..\src\FPA\calcium_proxy\HDL\kpix_recombine.bde]
Enabled=1
[file:.\compile\calcium_data_compression.vhd]
Generated=TRUE
Enabled=1
[file:.\compile\kpix_recombine.vhd]
Generated=TRUE
Enabled=1
[file:.\src\calcium640D_intf_testbench_stim.vhd]
Enabled=1
[file:.\src\calcium640D_intf_testbench_run.do]
Enabled=1
