gbrangeon-telops/irc_fir-00251-proc/src/constraints/mockfpa/mockfpa_specific_physical.xdc

## Physical Constraints Section

############### DEVICE PARAMETER ##################
set_property DCI_CASCADE {32 34} [get_iobanks 33]
	
	
###############  ADC INTERFACE  #############
# quad1 outputs clock
set_property PACKAGE_PIN P23 [get_ports CH0_CLK_P]
set_property IOSTANDARD LVDS_25 [get_ports CH0_CLK_P]
set_property IOSTANDARD LVDS_25 [get_ports CH0_CLK_N]
set_property DIFF_TERM TRUE [get_ports CH0_CLK_P]
set_property DIFF_TERM TRUE [get_ports CH0_CLK_N]

# quad2 outputs clock
set_property PACKAGE_PIN N21 [get_ports CH1_CLK_P]
set_property IOSTANDARD LVDS_25 [get_ports CH1_CLK_P]
set_property IOSTANDARD LVDS_25 [get_ports CH1_CLK_N]
set_property DIFF_TERM TRUE [get_ports CH1_CLK_P]
set_property DIFF_TERM TRUE [get_ports CH1_CLK_N]

# quad3 outputs clock
set_property PACKAGE_PIN R23 [get_ports CH2_CLK_N]
set_property IOSTANDARD LVDS_25 [get_ports CH2_CLK_P]
set_property IOSTANDARD LVDS_25 [get_ports CH2_CLK_N]
set_property DIFF_TERM TRUE [get_ports CH2_CLK_P]
set_property DIFF_TERM TRUE [get_ports CH2_CLK_N]

# quad4 outputs clock
set_property PACKAGE_PIN AC24 [get_ports CH3_CLK_N]
set_property IOSTANDARD LVDS_25 [get_ports CH3_CLK_P]
set_property IOSTANDARD LVDS_25 [get_ports CH3_CLK_N]
set_property DIFF_TERM TRUE [get_ports CH3_CLK_P]
set_property DIFF_TERM TRUE [get_ports CH3_CLK_N]

# quad1 (adc1 to adc4) data link
set_property PACKAGE_PIN R20 [get_ports {CH0_DATA_N[0]}]
set_property PACKAGE_PIN T23 [get_ports {CH0_DATA_N[1]}]
set_property PACKAGE_PIN M22 [get_ports {CH0_DATA_N[2]}]
set_property PACKAGE_PIN T25 [get_ports {CH0_DATA_N[3]}]
set_property IOSTANDARD LVDS_25 [get_ports CH0_DATA_*]
set_property DIFF_TERM true [get_ports CH0_DATA_*]

# quad2 (adc5 to adc8) data link                                                                
set_property PACKAGE_PIN U20 [get_ports {CH1_DATA_N[0]}]
set_property PACKAGE_PIN T19 [get_ports {CH1_DATA_N[1]}]
set_property PACKAGE_PIN K26 [get_ports {CH1_DATA_N[2]}]
set_property PACKAGE_PIN N17 [get_ports {CH1_DATA_N[3]}]
set_property IOSTANDARD LVDS_25 [get_ports CH1_DATA_*]
set_property DIFF_TERM true [get_ports CH1_DATA_*]

# quad3 (adc9 to adc12) data link                                                                              
set_property PACKAGE_PIN P18 [get_ports {CH2_DATA_N[0]}]
set_property PACKAGE_PIN T17 [get_ports {CH2_DATA_N[1]}]
set_property PACKAGE_PIN M19 [get_ports {CH2_DATA_N[2]}]
set_property PACKAGE_PIN R17 [get_ports {CH2_DATA_N[3]}]
set_property IOSTANDARD LVDS_25 [get_ports CH2_DATA_*]
set_property DIFF_TERM true [get_ports CH2_DATA_*]

# quad4 (adc13 to adc16) data link                                                                            
set_property PACKAGE_PIN Y21 [get_ports {CH3_DATA_N[0]}]
set_property PACKAGE_PIN AD24 [get_ports {CH3_DATA_N[1]}]
set_property PACKAGE_PIN AC22 [get_ports {CH3_DATA_N[2]}]
set_property PACKAGE_PIN AC21 [get_ports {CH3_DATA_N[3]}]
set_property IOSTANDARD LVDS_25 [get_ports CH3_DATA_*]
set_property DIFF_TERM true [get_ports CH3_DATA_*]

# quads clks sources                                                         
set_property PACKAGE_PIN L24 [get_ports QUAD3_CLK]
set_property PACKAGE_PIN M24 [get_ports QUAD4_CLK]
set_property PACKAGE_PIN P20 [get_ports QUAD1_CLK]
set_property PACKAGE_PIN P19 [get_ports QUAD2_CLK]
set_property IOSTANDARD LVCMOS25 [get_ports QUAD3_CLK]
set_property IOSTANDARD LVCMOS25 [get_ports QUAD4_CLK]
set_property IOSTANDARD LVCMOS25 [get_ports QUAD1_CLK]
set_property IOSTANDARD LVCMOS25 [get_ports QUAD2_CLK]

# fpa_digios out                                                                           
set_property PACKAGE_PIN M26 [get_ports FPA_DIGIO1]
set_property PACKAGE_PIN N26 [get_ports FPA_DIGIO2]
set_property PACKAGE_PIN N24 [get_ports FPA_DIGIO3]
set_property PACKAGE_PIN P24 [get_ports FPA_DIGIO4]
set_property PACKAGE_PIN L25 [get_ports FPA_DIGIO5]
set_property PACKAGE_PIN M25 [get_ports FPA_DIGIO6]
set_property PACKAGE_PIN P26 [get_ports FPA_DIGIO7]
set_property PACKAGE_PIN R26 [get_ports FPA_DIGIO8]
set_property PACKAGE_PIN M20 [get_ports FPA_DIGIO9]
set_property PACKAGE_PIN N19 [get_ports FPA_DIGIO10]
#set_property IOB TRUE [get_ports FPA_DIGIO*] 

# fpa_digios in  
set_property PACKAGE_PIN P25 [get_ports FPA_DIGIO11]
set_property PACKAGE_PIN R25 [get_ports FPA_DIGIO12]
set_property IOSTANDARD LVCMOS25 [get_ports FPA_DIGIO*]
#set_property IOB TRUE [get_ports FPA_DIGIO*] 

# fpa_freq_id
set_property PACKAGE_PIN N16 [get_ports FPA_FREQ_ID]
set_property IOSTANDARD LVCMOS25 [get_ports FPA_FREQ_ID]
set_property IOB TRUE [get_ports FPA_FREQ_ID]
set_property PULLDOWN true [get_ports FPA_FREQ_ID]

# fpa_on                                                                                                      
set_property PACKAGE_PIN U16 [get_ports FPA_ON]
set_property IOSTANDARD LVCMOS25 [get_ports FPA_ON]
#set_property IOB TRUE [get_ports FPA_ON]

# spi signals                                                                           
set_property PACKAGE_PIN V22 [get_ports SPI_CSN]
set_property PACKAGE_PIN U22 [get_ports SPI_SCLK]
set_property PACKAGE_PIN AF25 [get_ports SPI_SDI]
set_property PACKAGE_PIN AF24 [get_ports SPI_SDO]
set_property PACKAGE_PIN AE21 [get_ports SPI_MUX0]
set_property PACKAGE_PIN AD21 [get_ports SPI_MUX1]

set_property IOSTANDARD LVCMOS25 [get_ports SPI_*]
set_property IOB TRUE [get_ports SPI_SDO]
#set_property IOB TRUE [get_ports SPI_CSN]
#set_property IOB TRUE [get_ports SPI_MUX0]
#set_property IOB TRUE [get_ports SPI_MUX1]
#set_property IOB TRUE [get_ports SPI_SCLK]
#set_property IOB TRUE [get_ports SPI_SDI]
