gbrangeon-telops/irc_fir-00251-proc/(commit log)

2016-02-14 Isc0209A: ajustement gain(sur Xboard) et offset(dans le driver)
    [CAL_status_decode.xlsm, FirmwareReleaseChecklist.xlsx, app.xml, compile.cfg, config_C.txt, config_VHDL.txt, deserializer_scd.xlsx, fpa_deserializer_template.xlsx]
2016-02-15 correction offsetX vs offsetY
    [GC_Registers.c]
2016-02-19 fusion de la branche flickers dans le tronc
2016-02-23 - ajout d'un critère d'outliers pour les bad pixels (critère hardcodé pour le moment, en attendant les flash settings) - ajout d'un mode verbose de débug via le terminal pour les bad pixels
2016-02-23 correction d'un seuil hardcodé
    [Actualization.c, FileManager.c]
2016-02-23 changement de nom de variables
2016-02-26 - Detection de bad pixels utilise les nouveaux flash settings - Correctioin du POSIXTime du fichier .tsac
    [Actualization.c, DebugTerminal.c]
2016-02-26 Isc0209A: compilation pour fins de release.
2016-02-26 - Le bloc de référence est actualisé avant l'acquisition des images pour la détection de bad pixels. - DeltaBeta est conservé dans sa représentation float (non saturé). Il est cependant quantifié imm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
2016-02-26 enlevé un champ inutile dans la structure deltaBeta_t
2016-02-27 hawkA: compilation pour fins de release.
2016-02-29 scorpiolw_230Hz: compilation pour fins de release.
2016-03-01 - Merge branch "2016-02-29 - Device Key". - Flash Settings v1.10.0. - Flash Dynamic Values V1.4.0.
2016-03-03 When loading flash settings, camera state is updated only if initialization is done.
2016-03-09 Mise en place des bases pour permettre d'actualiser seulement avec la "composante AC" de l'actualisation : - L'actualisation est gardée en single float jusqu'au moment où elle est appliquée ; elle es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
2016-03-09 certains champs de refBlockFileHdr n'étaient pas bien remplis en mode actualisation externe
2016-03-09 simplifications pour appliquer le retrait de l'offset d'actualisation
2016-03-10 commit des fichiers binaires des derniers changements à l'actualisation
2016-03-10 - retrait de la médiane plutôt que de la moyenne pour le mode d'actualisation sans offset
2016-03-10 - correction de la médiane pour l'actualisation - la commande ACT CFG sans argument montre la valeur courante du mode
    [Actualization.c, DebugTerminal.c]
2016-03-11 Actualisation : - correction du type se retrouvant dans le fichier .tsac si discard offset à true - discard offset à true par défaut pour le release temporaire (flash setting pas encore dispo)
    [Actualization.c]
2016-03-11 correction d'un bogue qui rendait la détection de bad pixel sans effet
    [Actualization.c]
2016-03-14 pour IRC1405 (SERV1511) seulement : clk_divider doit rester inchangé pour que la calibration déjà faite avec ce module ne change pas. (en rapport avec common_hdl svn 18230)
2016-03-16 Test pour fixé un Bug de l'interrupt d'AEC
2016-03-16 Actualisation Utilise maintantenant ActualizationDiscardOffset des flash settings Correction d'un commentaire
    [Actualization.c]
2016-03-17 ajout de stack violation protection
2016-03-18 ajout script qui donne les rev svn lors d'un build hw
2016-03-21 hawkA et isc0209A: compilation pour fins de release. But: regeler le problème du demarrage anormal des détecteurs.
2016-03-21 Software has been rebuild for hawkA and isc0209A sensors.
2016-03-22 scorpiomwA : chantier
    [compile.cfg, library.cfg, projlib.cfg]
2016-03-23 - Peripheral data structures are now declared as global to avoid stack overflow. - Boot loader heap size has been reduced from 0x400 to 0x100 to reduce software size in BRAM. - STACK command has been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
    [DebugTerminal.c]
2016-03-31 mise à jour des valeurs réellement utilisées
2016-03-31 Hawk et isc0209 : corrections pour uniformité de code uniquement. Aucun impact fonctionnel (validé en simulation)
2016-04-01 Since gGC_ProprietaryFeatureKeyIsValid cannot be referenced in firmware updater module, gPowerOnIsAllowed and gFuPromIsWriteProtected are modified only when gGC_ProprietaryFeatureKeyIsValid is not se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
2016-04-01 fusion de la branche multi-actualisations
2016-04-02 scorpiomwA : implémentation en attente de tests.
    [compile.cfg]
2016-04-06 scorpiomwA has been added to firmware release checklist.
    [FirmwareReleaseChecklist.xlsx]
2016-04-06 Hawk : ajustement des echantillons pour reduire les barres discordantes des bords de l'image (redimine #7873). Ajustement des coefficients de température (redmine #7882).
2016-04-06 - gPowerOnIsAllowed and gFuPromIsWriteProtected are managed in DeviceKey_Validate function. - FlashDynamicValues.tsdv file cannot be deleted using rm debug terminal command. - When closing file, flas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
2016-04-07 fix problème AEC en FWMode = Sync sans avoir de block MS (en RAW ou RAW0)
2016-04-08 ajout de clk_divider_async
2016-04-08 isc0207A: ajout de clk_divider_async
2016-04-08 isc0207A: compilation hw avec enlvement des changemnts rendant caduque la calibration
2016-04-08 Merged revision(s) from "2016-02-15 - Printf F1F2" branch.
2016-04-08 Flash settings update is skipped when flash settings file is up to date.
    [FlashSettings.c]
2016-04-11 - Device key functions headers have been added. - Device key expiration POSIX time is printed as decimal and hexadecimal in debug terminal.
2016-04-11 - Device key validation has been added to processing FPGA built-in tests.
2016-04-18 Changement pour le cooler uart utiliser pour le NDF uart
2016-04-18 Fix erreur de merge
2016-04-19 - Flash dynamic values 1.5.0 - Bad pixel replacement flash dynamic value has been added. - BPRApplied image header field management has been added.
    [FlashDynamicValues.c, FlashDynamicValues.h, GC_Callback.c]
2016-04-19 Trace FPA: remise à flots du simulateur isc0207A
    [compile.cfg]
2016-04-21 hawkA: IRC1511 et IRC1512 reglement du problème de decalage en sous fenetrage.
2016-04-21 attente du fast header de la calibration (#8041)
2016-04-21 Trace FPA: chantier
2016-04-22 trace isc0207A fonctionnelle
2016-04-25 seule la dernière valeur d'un fast header a un tag FFFF (#8041)
2016-04-26 - L'actualisation utilisait dans certaines situation le registre CalibrationBlockSelector (pas toujours fiable), plutôt que le bon index. Règle un bogue qui survenait en présence de multi-blocs seule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
2016-04-27 correction d'un printf
2016-04-27 scd_proxy: initialisation des IOs selon la nouvelle doc SCD (tentative pour #6800)
2016-04-27 Avoid transmitting NAK forever when file open error occurs while checking a file.
    [FileManager.c]
2016-04-27 - Flash Settings 1.12.0 - gFpaDetectorElectricalTapsRef and gFpaDetectorElectricalRefOffset global variables have been added. - POL, REF and OFF parameters have been added to FPA debug terminal comma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
    [DT_CommandsDef.c, FlashSettings.c, FlashSettings.h, fpa_intf.c]
2016-04-27 - CalibrationCollectionSelector validation is made only when writing CalibrationCollectionSelector register. - CalibrationCollectionBlockSelector validation is made only when writing CalibrationColle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
2016-04-28 Network show packets port filter has been added.
2016-04-28 scd_proxy: test pattern ManufacturerDynamicImage n'existe plus selon la nouvelle doc SCD (#8089)
2016-04-29 scd_proxy: mise à jour des timings d'acquisition (fig 2 et 4) selon la nouvelle doc SCD (#8089)
2016-05-02 AEC_VERBOSE has been added to avoid warnings.
    [AEC.h]
2016-05-05 hawkA : Entrée en jeu des offsets électroniques provenant des flash settings
2016-05-06 Modification à la stratégie de repositionnement de roue à filtre lente pour contrer le backlash (changements faits pour SDT, release 1.5.4.7, ramenés dans le tronc)
    [FWController.c, FWController.h]
2016-05-06 Correction pour l'actualisation externe en multi-bloc, qui ne faisait qu'actualiser le bloc 0, car le chargement d'une collection remettait systématiquement le block 0 actif.
    [Actualization.c, Actualization.h, Calibration.c]
2016-05-06 patch NDF Position provenant du motion controller manque un caractère fix fin "in transition" trop tôt polling time dynamique selon in transition ou non
    [NDFController.c]
2016-05-09 fix patch pour caméra SDT causait problème en MS
    [FWController.c]
2016-05-09 CHANTIER fix interlock AECPlusIsAvailable et Gating, FW modif flag AECPlusIsImplemented
    [Calibration.c, FlashSettings.c, GC_Callback.c, GC_Registers.h]
2016-05-13 scorpiomwA : deserializer_clk_dout vaut mck_source et non 80MHz.
    [compile.cfg]
2016-05-16 fix problème FW MS in transition, causé par reset SM FW qui faisait le homing alors que la FW tourne toujours
    [FWController.c, FWController.h, FaulhaberProtocol.c, FaulhaberProtocol.h]
2016-05-17 ajouts de fifos pour tous les afpa.
2016-05-18 Release 1.6.x.0
    [FirmwareReleaseChecklist.xlsx]
2016-05-20 fix en RAW ou RAW0 ne pas reconfigurer le NDF sur un changement de FWMode
    [calib.c]
2016-05-23 scorpiomwA à 10MHZ, backup. cause du bug de decalage en cours de recherche.
    [fpa_intf.c, fpa_intf.h]
2016-05-24 scorpiomwA à 10MHz problème decalage image corrigé.
    [fpa_intf.h]
2016-05-25 fix délai de l'exécution de la commande de l'AEC+
    [NDFController.c]
2016-05-25 tous les afpa sauf isc0207A : introduction de DEFINE_FPA_SYNC_FLAG_VALID_ON_FE pour déterminer si le flag de synchronisation des données des adcs est valide sur falling_edge ou pas.
2016-05-25 scorpiomwA à 10MHz: problème de decalage corrigé, de choix des échantillons corrigé, d'offset corrigé, de gain corrigé, de frame rate corrigé. Tout est prêt pour les tests détecteur. ToDo: tests dete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
    [fpa_intf.c, fpa_intf.h]
2016-05-26 - actualisation à moyenne nulle utilise la médiane de l'image pour calculer le flux de référence - correction d'un bogue d'actualisation multi-bloc (ne prenait pas la bonne LUTRQ ni le bon pixel data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
    [Actualization.c, Actualization.h, DT_CommandsDef.c]
2016-05-26 scorpiomwA: essai à 18MHz. Battement observé dans l'image. En investigation
    [compile.cfg, library.cfg, projlib.cfg]
2016-05-26 première version fonctionnelle du code de quantification optimale de beta suite à l'actualisation
2016-05-27 - enlevé des printf inutiles - applique quand même l'actualisation meme si le fichier .tsac n'a pu s'écrire (#8680)
2016-05-27 - les itérations de cleanBetaDistribution() sont faites une à la fois pour donner du temps au reste du code (à tester) - ajout d'un mode à la commande "act cfg" du debug terminal pour activer la quan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
2016-05-30 tous les fpa: correction OR sur dval_gen_err
2016-05-30 La quantification dynamique de Beta est implantée, mais inactive par défaut. Il faut l'activer via le debug terminal.
2016-05-30 ajout pour diagnostic scorpio230_Hz
    [compile.cfg, library.cfg, projlib.cfg]
2016-06-01 scorpio 230Hz: debug. Ajouts pour surveillance horloge CLINK
2016-06-06 scorpiomwA: compilation à 18MHz.Tests détecteur faits avec succès avec real_mode_active_pixel_dly = 3 et adc_clk_phase = 0. Flex alimenté finalement à 8V pour éviter saturation opapms.
    [compile.cfg]
2016-06-08 scorpiomwA: compilation à 18MHz.Tests détecteur faits avec succès avec real_mode_active_pixel_dly = 3 et adc_clk_phase = 0. Reste à enlever les compteurs de pixels.
    [compile.cfg]
2016-06-08 NDFController.h : haussé les courants max du contrôleur (pic et continu) NDFController.c : correction d'un bogue avec le calcul de la médiane des mesures les plus récentes (ne préservait pas l'ordre 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
    AEC.c : - ne fait plus le calcul en double, mais en single float, ce qui permet de gagner un facteur 3 à 4 sur le temps de processing de l'interrupt.
    - Ajout de code pour profiler le code de traitement de l'AEC
    - changement de longues structures de if/else en switch
    - enlevé une application em double et superflue du nouveau temps d'exposition (gain d'environ 100 µs par interrupt)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
    [NDFController.c, NDFController.h]
2016-06-09 enlevé le #define pour le profilage de l'AEC
2016-06-17 révision d'après merge: - ménage projet aldec - fichiers target vides - propriétés mime-type et needs-lock sur les bde - build en ordre alphabétique - delete fichiers inutiles
    [compile.cfg, library.cfg]
2016-06-20 correction merge des timings
    [DT_CommandsDef.c, fpa_intf.c]
2016-06-21 scripts compilation des détecteurs batch style
2016-06-22 build hw tous les détecteurs après merge timings (rev 18911)
2016-06-22 Calibration files 2.0.0: - Prefixes have been removed before FileHeaderLength, FileHeaderCRC16, DataHeaderLength and DataHeaderCRC16 fields. - Actualization been renamed for ImageCorrection. - ImageC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
    [Actualization.c, CalibBlockFile.h, CalibCollectionFile.c]
2016-06-23 correction de l'écriture dans buffering
2016-06-23 PRINTF remplacés par FPGA_PRINTF
2016-06-27 correction de la lecture dans buffering
2016-06-28 usart : ajout MMCm. TODO: reviser les process avec des resets asynchrones et reviser liste de sensitivité des pocess
2016-06-29 correction: ne pas trier si la liste a 1 seul fichier
    [FileManager.c]
2016-06-29 Tous les dfpa: acceleration du clink delay calibration (partie vhd)
2016-06-29 Tous les dfpa: acceleration du clink delay calibration (partie driver c)
2016-06-29 Tous les dfpa: revision du frame_rate_min à 0.9
2016-06-29 SCD_Proxy: On configure le détecteur avec la véritable période minimale. Cela aura pour conséquence de reduire les risques de saut de trigs à vitesse élevée.
2016-07-04 USART: introduction de IBUF avant MMCM.
2016-07-05 File create bug has been resolved. FM_OpenFile now takes open flag as parameter.
    [Actualization.c, Calibration.c, FileInfo.c, FileManager.c, FileManager.h]
2016-07-06 Les registres reliés à la calibration doivent être updatés avant de recalculer les limites sur l'exposure time et le frame rate (#8153)
2016-07-06 révision des contraintes de timing
2016-07-06 usart: ajout nouvelle source dans Aldec
    [compile.cfg]
2016-07-06 Calibration files v2.1.0: - LowReferenceTemperature, HighReferenceTemperature, LowExtrapolationTemperature, HighExtrapolationTemperature and FluxOffset fields have been added to block file header (#8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
2016-07-07 LowCut et HighCut des blocs sont écrits dans le header par la calibration (fast_header)
2016-07-12 branche ADCReadout ramenée dans le tronc
    [compile.cfg, library.cfg]
2016-07-12 mise-à-jour des projets sdk pour inclure le module ADCReadout
2016-07-14 Actualisation - remplissage des nouveaux champs di fichier d'actualisation - remplacé actualization par image correction dans les printf - écrit des fichiers .tsic au lieu des .tsac
    [Actualization.c, Actualization.h]
2016-07-14 build des détecteurs suite à l'introduction de fonctionnalité ADCReadout
    [compile.cfg]
2016-07-15 il manquait le fichier de compilation pour ADCReadout
2016-07-18 - ADC readout is initialized when flash settings are loaded. - ADC debug terminal command has been added. - Default fixed filter wheel PID settings are validated when flash settings are loaded.
    [DT_CommandsDef.c, FlashSettings.c, GC_Registers.h, adc_readout.c]
2016-07-20 Le bloc de contrôle de l'USART doit sortir du reset même si la usart_clk n'est pas présente
2016-08-16 mise-à-jour pour vehiculer erreur de DVAL_GEN sur les sofradir et reduction de risques d'aleas de sequences sur les regitres intercolcks.
2016-08-18 Additional ADC readout debug information have been added.
2016-08-25 ajout de #warnings en guise de TODO pour DAL...
2016-08-25 Ajout du support dans le hder inserter de champ non aligné pour supporter le ADC readout
    [compile.cfg]
2016-08-29 scorpiomwA: correction bug de non sortie des images et correction bug de corruption des données et header (erreur 0x460 ou 0x464 du header inserter). Cela fonctionne bien en mode pleine fenetre sizea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
    [compile.cfg, projlib.cfg]
2016-08-29 Fix update
    [compile.cfg]
2016-08-29 scorpiomwA: deblocage du sous-fenetrage avec introduction du concept de la config d'initialisation des ROIC. Compilation à venir
2016-08-30 scorpiomwA: de nouveau opérationnel. TODO: regler problème de mauvaise initialisation (au bootup) du détecteur.
2016-09-01 libération de ressources en delaissant les double_sync_vector
2016-09-09 suppression de modifs créant bugs
2016-09-09 scorpiomwA : code pour débuter la qualification
2016-09-13 Flash settings version, flash dynamic values version and calibration files version have been added to printed release info.
2016-09-15 Activation du code de quantification dynamique du paramètre beta suivant l'actualisation
2016-09-27 correction dans la calibration des delais.
2016-10-13 scorpiomwA : bug EHDRI reglé. Concept de config d'initialisation du detecteur au demarrage introduit.
    [fpa_intf.c, fpa_intf.h]
2016-10-16 ScorpiomwA: Concept de config d'initialisation du detecteur au demarrage (suite et fin). Semble regler le pb de demarrage du scorpiomwA. On demarre le détecteur en sous-fenetre (totalement transparen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
2016-10-17 Tous les détecteurs: Concept de config d'initialisation du detecteur au demarrage. Ne change rien aux détecteurs sauf au scorpiomwA.
2016-10-18 Tous les détecteurs sauf scorpiomwA: compilation hw.
    [compile.cfg]
2016-10-18 ajouts de fonctions manquantes
2016-11-04 ISC0207A: ajout d'éléments pour la trace détecteur en vue de conserver la calibration
    [compile.cfg]
2016-11-04 ISC0207A:chantier ajustement de la trace détecteur
2016-11-04 scorpiomwA : consideration du mode diag dans l'implantation du concept de config d'initialisation
2016-11-04 scorpiomwA : compilation testée avec succès en mode patron de tests.
2016-11-07 isc0207A: compilation avec quad_phase variable et configurable via debug terminal (pour ajustement en temps réel de la trace détecteur)
2016-11-07 isc0207A: ajustement final pour phase de l'horloge des Quad_adc pour conserver les calibrations existantes (trace détecteur).
2016-11-09 Flash dynamic values update can be disabled using an hidden debug terminal command to allow replacement of the TSDV file before rebooting the camera when updating firmware from version 2 to version 1.
    [DT_CommandsDef.c, FlashDynamicValues.c]
2016-11-15 - les tsic n'étaient pas protégés (via t2kfmtb) - correction du problème d'accumulation de fichiers tsic (actualisations internes) (#8385)
    [CalibImageCorrectionFile.c, FileManager.c]
2016-11-16 - FS debug terminal command has been added. - FlashSettings_PrintFlashSettingsFileHeader function has been added. - "default" has been added under the last minor version case of version 1.x.x (#8359)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
2016-11-16 - "default" has been added under the last minor version case of version 1.x.x for all of the IRCam file formats (#8359). - utils.h and verbose.h are included in IRCam file libraries v2 even if there 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
2016-11-18 Utilisation des champs AECSaturatedCorrectionFactor et FWFramePeriodMinMargin des flashSettings (#8253)
2016-11-18 correction: depuis les timings le module buffering est sur la clock de 80MHz (#8408)
2016-11-18 generate des mesures de période de trig par un generic
2016-11-18 HDER_ResetErr: correction + appel dans HDER_SendConfigGC (à chaque arm)
2016-11-18 Les user clk dans les mgt sont à 100MHz
2016-11-18 usart: clock d'entrée remise dans les contraintes
2016-11-21 Flash settings are not reset at initialization, when flash settings file is deleted nor when flash is formatted. Flash settings are only set to their default values when there is no valid flash setti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
    [FileManager.c, FlashSettings.c]
2016-11-22 define des clocks dans tel2000_param.h et utilisation de ces define dans le code
2016-11-24 stretch_acq_trig déplacé dans la partie commune de la config fpa
2016-11-25 fail safe (stretch_acq_trig) pour tous les détecteurs
    [SFW_ctrl.c, fpa_intf.c, fpa_intf.h]
2016-11-25 scorpiomwA: modifs qui reglent le problème intermittent au démarrage du scorpio160+. Testé avec succès sur IRC1601 (avec carte 270 de RD). Après 25 cycles ON/OFF, aucun bug de redemarrage trouvé (#85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
    [fpa_intf.c]
2016-11-25 hawkA: modification de la conversion de température pour tenir compte du VLW (sans incidence sur les systèmes déjà livrés)
2016-11-28 ajout stretch_acq_trig dans l'init des fpa config
2016-11-28 Blank line has been removed from SensorInformation.txt.
2016-11-28 hawkA: sur demande de PTR, IntTime passe à 100 usec par defaut.
2016-11-29 correction du printf de la commande "act lst" (#8517)
    [Actualization.c]
2016-12-07 correction boucle infinie quand GPS branché pendant une fonction bloquante (#8578)
    [FaulhaberProtocol.c, gps.c]
2017-01-24 - isc0207A_3k and isc0804A have been added to sensor list.
2017-02-07 corection pour supporter les registres de debug du FPA
2017-02-07 ISC0207A: modifs pour supporter le HiFleG pour les besoins de IRC1622. Trace détecteur non garantie
2017-02-17 ajout des rapports de puissance (Release 2.0.x.4)
2017-02-23 Pour IRC 1622 : Correction. valeur de tap ref.
    [fpa_intf.c, fpa_intf.h]
2017-02-24 Data flow must be retro-compatible with previous minor versions.
2017-02-27 Evolution #8677 Fix pour la lecture Image par image
    [GC_Callback.c]
2017-03-01 correction accès à l'extérieur d'un tableau
    [Actualization.c]
2017-03-21 changements au module de Trig: - correction délai en trig de séquence (#8040) - trig out sur même conditioner que fpa trig - paramètres inutiles enlevés
2017-03-28 herculesD: mise à jour des timings d'acquisition (fig 2 et 4) selon la nouvelle doc SCD (#8796)
2017-04-05 - XML 12.1.0 - Partial sequence download is supported using MemoryBufferSequenceDownloadFrameID and MemoryBufferSequenceDownloadFrameCount (#8675). - AutomaticExternalFanSpeedMode and ExternalFanSpee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
    [GC_Callback.c, GC_Registers.c, GC_Registers.h]
2017-04-25 simulation des instabilités de la SFW
2017-04-27 correction trig out de rev 20203 (#8040)
2017-05-04 - 2016-11-09 - OEM Debug Terminal branch has been merged into trunk (#8685). - Flash Dynamic Values v2.1.0 - Output debug terminal RX buffer has been removed. - Proc_DeviceSerialPorts_Init function o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
    [DT_CommandsDef.c, FileManager.c, GC_Callback.c, GC_Registers.c, GC_Registers.h, gps.c]
2017-05-08 scorpiomwA uniquement: branche (2.0.x.x) rendue dans le tronc (les modifications visent à regler le problème du boot-up puis à utiliser le quad_serdes développé par Forrest Gump). Toute trace détecte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
    [compile.cfg]
2017-05-08 HawkA: modifications pour suivre celles dans afpa_pixel_reorder.vhd de Common_HDL. Aucun impact sur l'existant.
2017-05-08 isc0209A: modifications pour suivre celles dans afpa_pixel_reorder.vhd de Common_HDL. Aucun impact sur l'existant.
2017-05-16 la collection n'est pas encore valide lorsqu'on load les flash settings
2017-05-18 PelicanD: bug fix OffsetY doit être multiple de 4 (refs #8682)
    [GC_Registers.c, fpa_intf.h]
2017-05-23 build hw tous les détecteurs
2017-06-09 Ajout du driver pour le nouvelle adc du EFA-00251-201. Celui-ci n'est pas encore intégrer au design seulement en simulation redmine: #8955
2017-06-13 Simulation de l'ADC 7980
2017-06-13 fix hi speed ADC_ERR
    [ad798x_driver.vhd]
2017-07-31 ménage des TODO
2017-07-31 utilisation des macros de conversion de température
2017-07-31 ménage actualisation (aucun chg fonctionnel): - aucune différenciation sur les sources du trig (int ou ext) de l'actualisation - ajout/correction de commentaires - indentations refaites - enlève redo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
    [Actualization.c, Actualization.h, DT_CommandsDef.c, GC_Callback.c]
2017-08-01 actualisation: révision des printf
2017-08-01 hawk ADC 10 MHz: chantier
2017-08-03 ISC0207A_2K: compilation réglant le problème de ghost pour l'électronique à fleX (EFA-00264-). Celle avec FleGX a été déjà faite dans le cadre de IRC1622.
    [fpa_intf.c, fpa_intf.h]
2017-08-03 hawkA: remise à flots du simulateur et correction pour s'aligner sur FG
    [compile.cfg]
2017-08-04 hawk ADC 10 MHz: compil sans ajustement echantillons. Attente d'une camera Hawk pour terminer le travail.
2017-08-04 utilisation des fonctions float plutôt que double
2017-08-08 isc0209A et hawkA : correctifs pour passage à 10MHz d'ADC Clock
2017-08-09 Commit Merge Branche EFA-00251-201 Tester Startup, ISC0207A et PelicanD
    [compile.cfg]
2017-08-09 calcul des positions de la SFW avec la BeamMargin au complet
2017-09-27 les registres CalibrationMode et VideoFreeze sont shared
2017-11-05 ISC0209A : offset dynamique et passage à 10 MSamples/s
    [compile.cfg]
2017-11-05 ISC0209A : le quad2 et son module de processing de données n'est plus generé tout le temps mais sur demande provevant du fpa_define.vhd. Compilation et ajustements à jour
2017-11-07 IC0209A: changement de phase dans fpa_intf.h pour essayer de corriger le problème des bandes.
    [fpa_intf.h]
2017-11-07 isc0209A: omission de fichiers de simulation
2017-11-07 HawkA: se met à jour par rapport aux fichiers communs des afpa.
2017-11-07 isc0207A: se met à jour par rapport aux fichiers communs des afpa.
2017-11-08 tous les afpa sont à jour par rapport aux fichiers communs
2017-11-13 251 v2 : - changement de plusieurs messages de connecteurs - déplacement du test de flash à la fin du processus - suppression des tests de fans FPGA - changment de la plage de courant valide pour le 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
2017-11-13 mauvaise création de branche
2017-11-29 hawkA: ajustement de l'échantillonneur fait.
2017-12-21 Calibration files v2.2.0: ReferencePOSIXTime description corrected in ImageCorrectionFileHeader (refs #9655). AcquisitionFrameRate, FWMode and FocusPositionRaw added in ImageCorrectionFileHeader (ref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
    [CalibCollectionFile.c, CalibImageCorrectionFile.c]
2018-01-12 Retarde l'envoi de FWPosition au header (fix #9709)
2018-01-15 Calibration files v2.2.0 (suite de r21289): ExternalLensFocalLength added in BlockFileHeader (refs #9656).
2018-01-17 FWPresent doit être à 1 pour enabler la SFW (fix #9735)
    [FlashSettings.c]
2018-01-31 ajout des FPA_PIXEL_PITCH
2018-02-01 gestion des collections FOV
2018-02-02 correction passage collection v1 à v2
    [CalibCollectionFile.c]
2018-02-02 ajout d'un thermistorType pour utiliser le feedback de température de la lentille motorisée
2018-02-02 Calibration files v2.2.0 (suite de r21304): change FOVPosition default value (refs #9656).
2018-02-02 update de HFOV VFOV dans le header
2018-02-08 XML 12.2.0 (suite de r21328)
2018-02-08 utiliser FocalLength de lentille motorisée même si collection n'est pas FOV
2018-02-08 reload le bloc courant après actualisation ICU (fix #9240)
    [Actualization.c]
2018-02-09 - flash settings update AutofocusMode - traitement des types dans des switch pour clarté
2018-02-12 - code des callbacks FOV et focus - utilisation macro GC_CalibrationIsActive - 2 variables static s'appelaient previousValue
2018-02-16 HAWKA: activation du simulateur a permis de trouver et de corriger le problème de la saturation systématique en sous-fenetre. La saturation est due au fait que l'horloge de configuration SPI du Hawk 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
    [compile.cfg]
2018-03-21 XML 12.2.1 (suite de r21541)
2018-04-11 ajout de LENS_UART dans tous les détecteurs
2018-05-11 multiplication de la valeur de ROI par 2 avant l'envoie de la commande vers la carte SighLine #10234
2018-06-08 Premiere commit d'importation de code firmware en projet RevealIR. **AUCUNE CHANGEMENT SUR LE FICHIERS DE SOURCE***
2018-06-08 Ajouter supprimer des *.
2018-06-11 Incompatible avec le version firmware sans buecoup des changements. -Traverser les fichiers importantes à le SVN de RevealIR.
    [CalibBlockFile.h, CalibCollectionFile.c, CalibImageCorrectionFile.c, FileInfo.c]
2018-06-22 Merge(2e) de la branch Autofocus & Zoom (1737-1738)
2018-06-22 limitation de ExposureTimeMin par le flash settings (#10475)
2018-06-27 gestion de la CLink config et clock par le flash settings (#10453)
2018-07-03 XML 12.3.0 partage des registres Selected à l'init
2018-07-04 XML 12.3.0: - exclusion de DeviceFirmwareModuleRevision du partage des registres - conformité des callbacks reliées à des arrays
2018-07-11 correction electronique. Mise à jour pour pouvoir compiler les détecteurs qui ne l'utilisent pas
    [fpa_intf.c, fpa_intf.h]
2018-07-13 compil pour fin de releases: correction electronique desactivee pour tous les detecteurs du trunk.
2018-07-24 Calibration files v2.3.0
2018-10-25 Retrait des libraries common_hdl pour que ça compile.
2018-10-26 correction des projets SDK
2018-11-15 DCI-11600 : Correction du bug dans le module IRIGB (IRIGB non fonctionnel). Le bug a été corrigé complètement à la révision 22718.
    [DT_CommandsDef.c, FlashSettings.c]
2018-11-20 Merge des revisions 21682 à 21694 de la branche ETOffsetetFWRefTemp.
    Note importante : Le feature du ET Offset est seulement disponible sur le isc0207A. À l'exception de la fonction de calcul du Exposure time max, la plupart des moficiations nécéssaires à l'ajout de ce feature aux autres détecteurs ont été fait et sont disponibles dans la branche "ETOffsetetFWRefTemp". La raison pour laquelle ces modifications n'ont pas été mergées est que le feature du ET offset n'a pas encore été qualifié.
2018-11-20 1 - Ajout d'une commande dans le debug terminal pour pouvoir modifier le ET offset. 2 - Ajout d'une logique pour gérer le temps exposition minimal. 3 - Correction d'une erreur qui s'est introduite lo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
    [DT_CommandsDef.c, GC_Registers.c]
2018-11-22 nouveau release info pour Storage multiconfig
    [app.xml]
2018-11-23 correction printf
2018-11-23 Correction d'erreurs introduites lors de l'ajout de la commande pour changer le ET offset à partir du debug terminal.
    [DT_CommandsDef.c]
2018-11-26 DCI-11618 : Correction du problème de flagging (#10971)
2018-11-26 Ajout d'une commande dans le debug terminal pour pouvoir écrire les coefficients du calcul de température (fonction de la vitesse de la filter wheel).
2018-11-27 DCI 11618 : Problème de flagging (#10971)
2018-11-27 Merged revision 22282 from FIR-00251-Proc/branchs/2018-07-19 - RD1801 Proc: bug fix de retro-compatibilité du ADC Readout sur un 251-001 (#10810)
2018-11-29 bug fix: optoswitch selon sens de rotation (#10969)
2019-01-14 DCI-11600 : Correction du bug dans le module IRIGB.
    [DT_CommandsDef.c, irig_controller_v2.vhd]
2019-02-20 gestion des parametres en provenance des flashsettings. Ciorriger les erreurs de frappe et de syntaxe au besoin
2019-04-29 revert du commit précédent
    [CAL_status_decode.xlsm, app.xml, compile.cfg, library.cfg, projlib.cfg]
2019-04-30 alignement sur les modeèles FG
2019-04-30 correction FPA_define des megalink
2019-05-02 enlève include "xbasic_types.h" puisqu'il est deprecated
2019-05-02 suppression des double_sync_vector dans l'AEC
2019-05-04 chantier: elcorr
    [compile.cfg]
2019-05-04 ajouts des watchdogs
2019-05-06 suppression de l'horloge inutilisée dans l'IP usart_mmcm
2019-05-06 correction fan
2019-05-08 abandon de adc_ddc_detect_process_done moins fiable, au profit de fpa_init_done et recompilation pour suphawk. PelicanD utilise desormais le detecteur generique de freq_id brd_id_reader. Recompilatio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
2019-05-08 Merged revision(s) 23425-23436 from FIR-00251-Proc/branchs/2019-03-12 - 2.7.x.100 Bugfix: changement pour LN2 ........ script verifyRelease tenant compte du fpga size ........ l'incréement est de 4 c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
    ........
    ........
    correction FPA_define des megalink
    ........
    chantier
    ........
    ........
    tentative correction bug demarrage svn #11264 . On utilise desormais fpa_init_done qui est plus fiable.
    ........
2019-05-08 Merged revision(s) 23494 from FIR-00251-Proc/branchs/2019-03-12 - 2.7.x.100 Bugfix: l'emploi de fpa_init_done se generalise. Revision dans le pilote de M1K pour tenir compte des temperatures invalide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
    [fpa_intf.c]
2019-05-08 Merged revision(s) 23500 from FIR-00251-Proc/branchs/2019-03-12 - 2.7.x.100 Bugfix: on utilise desormais fpa_powered ET la stabilisation de la tempéraure pour juger du moment de lancer des acquisitio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
    [Acquisition.c]
2019-05-09 Merged revision(s) 23504 from FIR-00251-Proc/branchs/2019-03-12 - 2.7.x.100 Bugfix: on utilise desormais fpa_powered OU la stabilisation de la température ........
    [Acquisition.c]
2019-05-09 Merged revision(s) 23508 from FIR-00251-Proc/branchs/2019-03-12 - 2.7.x.100 Bugfix: ISC0804A: dans le cas particulier du LN2, fpa_init_done = 1 si en plus on arrive à allumer le detecteur(cela suppos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
    [fpa_intf.c]
2019-05-09 combinaison des header extractors
2019-05-09 ménage des erreurs superflues dans la calibration
2019-05-09 supHawk: correction du problème de reset des puits et ajustement du delai de debut d'image. Marche bien sur IRC1749
    [fpa_intf.c]
2019-05-10 affichage du statut du buffer (registre GenIcam) dans la console
2019-05-10 suppression fichiers de trop
2019-05-12 le diviseur de elcorr regeneré pour privilegier les ressources fPGA dans un 160T. Modifications pour corriger la non sortie d'image du superHawk lors du changement de fenetres. Compilation testée ave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
    [compile.cfg]
2019-05-13 HawkA: reduction de risques de dysfonctionnement lors des changements de fenêtre.Solution SuperHawk implantée sur Hawk
2019-05-14 nomenclature de SuphawkAIsImplemented
2019-05-15 MOI config envoyé au VHD dans tous les cas
2019-05-17 activation des Embedded Registers pour les FIFOs en BRAM
2019-05-19 ajout des safety circuits sur les FIFOs
2019-05-19 commit des rapports du build hw précédent
2019-05-20 Merged revision(s) 23526 from FIR-00251-Proc/branchs/2019-03-12 - 2.7.x.100 Bugfix: enfin une compil qui convient au LN2. ........
    [Acquisition.c, fpa_intf.c]
2019-05-29 correction des fonctions d'arrondis
    [GC_Registers.c, SFW_MathematicalModel.c]
2019-05-29 cleanup du prototype pour la fonction cleanBetaDistribution
2019-05-29 cohérence des définitions de fonctions statiques avec leurs protoypes dans l'actualisation
2019-06-11 Correction de la description du champ MaximumTotalFlux du BlockFileHeader. (La version reste la même.)
2019-06-13 isc0209A avec DEFINE_HSI (désactivé) pour les fonctionnalités spécifiques à ce projet
2019-06-14 generic qui remontent au top level plutôt que DEFINE_HSI correction Smart ADC
    [fpa_intf.h]
2019-06-14 DEFINE_HSI doit être dans le projet SDK
    [compile.cfg]
2019-06-18 Ajouts de #define DEFINE_HSI pour compilation avec HSI
2019-06-18 simulation partielle pelicanD
    [compile.cfg]
2019-06-18 Merged revision(s) 23573-23574, 23642, 23672, 23678-23680, 23731, 23749-23754 from FIR-00251-Proc/branchs/2019-03-12 - 2.7.x.100 Bugfix: Pre-release 2.7.14.103 ........ Release 2.7.14.103 ........ M3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
    [fpa_intf.c]
2019-06-18 TX_CLK de afpa_data_ctrl est connecté à CLK_100M_i CLK_100M_i est connecté à CLK_100M.
2019-06-18 DEFINE_GENERATE_QUAD2_CHAIN utilisé à la place de DEFINE_GENERATE_QUAD2_PROCESSING_CHAIN
2019-06-18 uniformisation des registres de debug/ajustement
2019-06-20 Bug Fix de la communication avec la Filter Wheel (#11300)
    - Revert partiel des changements introduient lors du merge fait à la révision r23419 (merge de la branche FG r23409).
    - Le revert cible les modifications faites sur l'utilisations des UARTs.
    [FaulhaberProtocol.c, FaulhaberProtocol.h, RpOpticalProtocol.c, RpOpticalProtocol.h, SightlineSLAProtocol.c, SightlineSLAProtocol.h]
2019-06-27 Bugfix - Mauvaise initialisation de la filter wheel (#11736)
    [FWController.c, FWController.h]
2019-06-28 correction warnings et enlève include inutiles
    [fpa_intf.c, fpa_intf.h]
2019-07-03 correction merge HDR bug fix
    [GC_Callback.c, GC_Registers.h]
2019-07-05 valeur par défaut de id_cmd_in_error
2019-07-11 Merged revision(s) 23911 from FIR-00251-Proc/branchs/2019-03-12 - 2.7.x.100 Bugfix: -correction uart en utilisant un fifo avec read latency à 1
2019-07-15 Merged revision(s) 23778-23780, 23947 from FIR-00251-Proc/branchs/2019-06-27 - 2.6 Bugfix: PelicanD unifié 350Hz et 150Hz
    [fpa_intf.c]
2019-07-18 correction merge du SDK de startup
2019-07-25 Merged revision(s) 23777, 23785, 23818, 23825-23826, 23858, 23860-23862, 23889, 23892-23893, 23960-23961, 23963-23966 from FIR-00251-Proc/branchs/2019-03-12 - 2.7.x.100 Bugfix: M3K: ajustement de pha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
    SuphawkA: mise à jour
    mise à jour pour 160T
    ISC0804 M1K/V1K sans cooler lineaire uniquement: correction de phase pour l'horloge des ADCS
    supHawk à 8 canaux (sans diversite spatiale)
    Megalink: mise à jour pour compil aldec.
    superHAwk: chantier
    supHawk:simulation
    suphawk: chantier supHawk en diversité spatiale
    suphawk: avec diversité spatiale, Mode Full F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
    [fpa_intf.c, fpa_intf.h]
2019-07-30 Merged revision(s) 23975-23979 from FIR-00251-Proc/branchs/2019-03-12 - 2.7.x.100 Bugfix: SupHawk: tentative pour solutionner le redmine #12194 ........ SupHawk: tentative pour solutionner le redmine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
    [compile.cfg, library.cfg]
2019-07-31 Correctif pour l'invalidation de la cache du registre MemoryBufferStatus (#11803)
    [GC_Callback.c]
2019-08-02 nouvelle HW rev (fix #12291) -ajout de la BRD_REV_30x -BRD_REV_UNKNOWN considéré comme erreur
    [adc_readout.c]
2019-08-06 Pas de nouvelle HW rev BRD_REV_30x (#12291)
2019-08-09 -ajout calcul de AcquisitionFrameRateMin selon le jumboframe (#7793) -correction ExposureTime s'il est sous ExposureTimeMin
    [GC_Registers.c]
2019-08-09 revert du calcul de AcquisitionFrameRateMin selon le jumboframe (#7793) (r24024)
    [GC_Registers.c]
2019-08-13 implémentation des nouvelles commandes F1F2 d'espace de flash (#12309)
2019-08-16 suppression de fichier uploadé corrompu lorsque l'écriture dans la NAND flash échoue (#12295)
2019-08-16 suppression du fichier FDV temporaire lorsque l'écriture dans la flash échoue (#12295)
2019-08-16 suppression du fichier FDV lorsque l'écriture dans la flash échoue (#12295)
2019-08-16 compensaton de l'espace utilisé/libre rapporté de la flash pour tenir compte des blocs réservés (#12297)
2019-08-16 réservation de l'espace d'un TSDV lors de l'upload d'un fichier (#12297)
2019-08-19 suppression des fichiers d'actualisation si l'écriture échoue (#12296)
2019-08-19 vérification de l'espace disponible avant de décoller le processus d'actualisation (#12296)
2019-08-20 correction au commit 24045: activation du flag d'erreur manquant (#12296)
    [Actualization.c]
2019-08-20 correction mineure (sans impact réel à cause de la granularité de UFFS) (#12297)
    [FileManager.c]
2019-08-20 réservation de l'espace d'un TSDV après l'actualisation (#12297)
2019-08-20 réservation de l'espace pour un fichier d'actualisation (#12297)
2019-09-04 réservation de l'espace Flash pour l'actualisation en tenant compte de la multiplicité ICU (#12297)
2019-09-04 Tous les detecteurs analogiques:il est possible de dissocier la correction de gain et de l'offset.
    [compile.cfg]
2019-09-12 vérification de l'espace avant l'actualisation déplacée dans la fn startActualization() (#12296)
2019-09-12 on tient compte de la multiplicité ICU seulement lors de l'upload de fichiers (#12297)
2019-09-12 compensation du used/free space de la flash déplacée de uffs vers FileManager (#12297)
2019-09-12 ajustement à la commande debug LS pour la nouvelle compensation de la flash
2019-09-12 uniformisation de la convention d'appel flash_space_used/free() avec uffs
2019-09-12 réservation de l'espace pour un fichier de flash settings
2019-09-13 discrimination des fichiers uploadés pour la réservation de l'espace flash
2019-09-13 réservation de l'esapce d'une actualisation XBB lorsqu'il n'y a pas de fichiers ICU.
2019-09-16 Merged revision(s) 24105, 24126, 24142, 24161 from FIR-00251-Proc/branchs/2019-03-12 - 2.7.x.100 Bugfix: type explicite amélioration cleanBetaDistribution cleanBetaDistribution dans une SM pour fract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
    [Actualization.c, Actualization.h, Calibration.c]
2019-09-22 fdem et suppresseur de bande laterale fonctionnelle.
2019-09-26 contrainte pour faire passer la compilation du startup160
2019-10-02 Bugfix pour plusieurs problèmes identifiés sur IRC1830 (#12368, #12369, #12370, #12376, #12596, #12603, #12323). -> Refonte/ménage de SFW_MathmaticalModel.c -> Ajout d'une sécurité dans ChangeFWContr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
    [Actualization.c, Actualization.h, FWController.c, FWController.h, GC_Callback.c, GC_Registers.c, GC_Registers.h]
2019-10-02 ménage des tests de fan (startup)
2019-10-04 Bugfix persistance des paramètres (#12743) Les array des "selected register" sont maintenant réinitialisés avec les factory values lorsque LoadSavedConfigurationAtStartup == 0
    [GC_Callback.c, GC_Registers.c, GC_Registers.h]
2019-10-07 Bugfix persistance des paramètres (suite)(#12743) Pour éviter d'user inutilement la flash, on n'écrit plus systématiquement les valeurs par défaut des GC regs dans la NOR flash lorsque p_flashSetting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
    [FlashSettings.c]
2019-10-15 le push button ne fait plus partie des GPIO de power management (startup)
2019-10-18 isc0209A: sortie de FRM_IN_PROGRESS pour utilisation dans HSI
2019-10-28 XML 12.6.255 (version partielle de 12.7.0 pour tests)
2019-10-30 bug fix: GC_Restore_Data_Factory peut seulement être appelée dans Proc_GC_Init (#12743)
    [FlashSettings.c]
2019-10-30 nouvelle génération de code
2019-11-05 Bugfix #13208 : Ajustement regC, regD et regF (correction de ghost et de décalage de colonne dans l'image)
    [fpa_intf.c]
2019-11-06 DCI 11311 - Implémentation de jumbo frames pour améliorer la vitesse de download du memory buffer (sortie Gige)
2019-11-06 scorpiomwA: importantes m-à-j pour reduire les risques de dysfonctionnement en abaissant l'horloge de programmation
    [compile.cfg, library.cfg, projlib.cfg]
2019-11-11 scorpiommA: refonte du firmware pour corriger les problèmes de demarrage, de sous-fenetre. TODO: valider phase de l'horloge des ADC
    [fpa_intf.c, fpa_intf.h]
2019-11-13 génération de code avec les unités de mesure dans le print des Flash Settings
2019-11-13 génération de code avec la fonction print pour tous les fichiers
2019-11-19 DCI 11311 - Correction d'un bug au niveau de la gestion de heightMax qui empêchait RevealIR de faire le download de façon automatisé.
    [GC_Registers.c]
2019-11-22 toujours pause et exit après une erreur dans les scripts
2019-11-27 ExposureTimeMin est restreint par l'AEC+ même si la camera est unlock (#12328)
2019-11-28 on retrouve une logique plus fiable de detection des cartes.
2019-11-28 build hw suite aux modifs dans le module fpa_status_gen pour une detection fiable de l'électronique de proximité quelle qu'elle soit.
2019-11-28 - les positions (FW, NDF, FOV) doivent suivre le bloc en raw/raw0 seulement si c'est le type de collection correspondant (#12410, #8094) - utilisation des macros CollectionTypeIsActive
2019-11-28 correction génération de code des fonctions print (#10479)
2019-11-29 isc0804A 1000 Hz: suit le même protocole de detection de proxim que M3K.
2019-11-29 isc0804A 500 Hz: backup
2019-11-29 isc0804A 500 Hz: suit le même protocole de detection de proxim que M3K.
2019-11-29 M3K : suppression de "magic numbers".
2019-11-29 aucune commande vers la FW si elle n'est pas présente (WaitingForFW restait à 1)
2019-12-02 backup: Pour les detecteurs à large resolution. Aucune incidence sur l'existant.
2019-12-03 script verifyRelease qui vérifie les BuildInfo de l'Output et du Storage
2019-12-03 nouvelle procédure de release
2019-12-03 ménage des fichiers bin
2019-12-04 uniformisation des fichiers et scripts bin
2019-12-09 generatePromFile clean .jou et .log peu importe d'où il est exécuté
2019-12-13 correction printf du bootloader: STDOUT_BASEADDRESS remplacé par XPAR_AXI_USB_UART_BASEADDR
2019-12-18 gestion correcte du signal tx_out_lock video dans la configuration MGT 1 canal
2020-01-08 hawkA : remise à flots
    [compile.cfg]
2020-01-08 Correction :le mode position de la filter wheel ne fonctionnait plus suite aux bugfix #12410
    [calib.c]
2020-01-08 hawk: correction du bug de non sortie d'image et on supprime le double point-virgule du dricerC.
    [fpa_intf.c]
2020-01-09 hawkA: modif driverC
2020-01-14 - Bugfix #13611 : bug de fonctionalité au niveau de l'actualisation MS. - Quelques corrections au niveau de la commande "ACT INV" permettant d'invalider une actualisation à partir du debug terminal.
    [Actualization.c, DT_CommandsDef.c]
2020-01-15 hawkA: simulation remise à flots
    [compile.cfg, library.cfg]
2020-01-15 hawkA: on corrige le bug du fifo LL8_ext_fifo8 qui ne supporte pas les fifos natifs avec embedded registers et ne gere pas bien les busy. Le nouveau fifo emploi un fifo axistream qui bien qu'utilisan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
    [fpa_intf.c, fpa_intf.h]
2020-01-15 Amélioration de la gestion du signal cal_en
2020-01-16 améliorations au fpa_watchdog_module: - mesure du délai trig to int - mesure du délai int to int - reset des mesures quand xtra_trig
    [compile.cfg]
2020-01-23 ISC0207A: remise à flots de la simulation
    [compile.cfg, library.cfg]
2020-01-23 ISC0207A: ajouts pour des print de debug au besoin.Aucune incidence sur l'existant.
2020-01-24 Bugfix : Optimisation de la fonction AEC_InterruptProcess(). (#13701) - La lecture de registres par AXI_LITE et le clear memory de l'histogramme sont fait au début de la fonction. - Le code relatif à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
2020-01-27 Revert des revisions 24774 et 24780. (#13714,#13710)
2020-02-04 suppression des warnings dans SDK: variables inutilisées
2020-02-13 ISC0804A: IWR fonctionnel
    [projlib.cfg]
2020-02-19 scorpiomwA: implanatation de acq_data pour IWR/RWI
2020-02-19 hawkA, isc0209A, isc0207A sont à jour avec le signal acq_data. Ils sont prêts à être compilés. Il reste les detecteurs de Forrest Gump.
2020-02-23 isc0207A_3k: fichiers de simulation
2020-02-23 chantier : essai compilation hw des analogiques. Ne pas utiliser!!!!
2020-02-24 Copie des actParams au début de l'actualisation plutôt que la badpixeldetection + ménage
2020-02-25 on rend plus robuste la generation de acq_data.
2020-02-25 detecteurs analogiques: compilation HW. Fonctionnelle sur un setup hawkA (sans detecteur) mais avec electronique de proximité. Le scorpioMWA présente toujours un problème de non sortie d'image en mod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
2020-02-27 all fpa: ajout de fast_hder_cnt dans debug terminal.
2020-03-09 all fpa sauf scorpiomwA: ajout de status supplementaires pour le mode RWI. Impact negligeable sur l'existant.
2020-03-10 scorpiomwA : compilation pour fins de release.
2020-03-10 mise-à-jour des simulateurs
    [compile.cfg, library.cfg, projlib.cfg]
2020-03-30 nouveau script updateHwSvnRev qui indique la clé de cryptage utilisée
2020-04-01 pour faire suite au changement dans le generateur de statuts afin d'uniformiser le module fpa.
2020-04-08 correction erreur de compilation du startup
    [adc_readout.c]
2020-04-09 Ajout d'une procédure pour modifier le contenu du fichier Excel de release
2020-04-09 nouveau script exportReleaseArchive qui indique la clé de cryptage utilisée
    [app.xml]
2020-04-10 script exportReleaseArchive vérifie la cohérence de la clé de cryptage utilisée
2020-04-13 activation de l'encryption
2020-04-13 correction r25106 (pour faire suite au changement dans le genereteur de statuts afin d'uniformiser le module fpa.)
2020-04-14 Revert revision(s) 25137 from FIR-00251-Proc/trunk: activation de l'encryption
    [fir00251_proc_160_encrypt.xdc, fir00251_proc_325_encrypt.xdc]
2020-04-15 retour à la normale
2020-04-20 Mise à jour du top de tous les détecteurs (complémentaire au merge r25181)
2020-04-23 Ajout de facteurs de correction pour avoir des specs équivalentes en IWR et ITR.
    [fpa_intf.c, fpa_intf.h]
2020-04-24 - Ajout de suffix F et d'unité dans le commentaire pour les facteurs de correction du modèle.
    [fpa_intf.c]
2020-04-27 ajouts aux corrections pelican et hercules
    [fpa_intf.c]
2020-04-27 Correction d'un erreur de bitshift sur le boost mode dans la commande opérationnel
    [fpa_intf.c]
2020-04-28 ISC0207: correction sans incidence sur l'existant
    [fpa_intf.c]
2020-05-06 Bugfix du problème de communication lorsque connecté par Gige. - Le délai XTRA_TRIG_MODE_DELAY de 250 ms à 50 ms. - L'attente du délai XTRA_TRIG_MODE_DELAY n'est plus bloquant lors d'un stop acquisit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
    [Acquisition.c, Acquisition.h, fpa_intf.c, fpa_intf.h]
2020-05-08 Propagation du bugfix fait à r25238 au Hercule.
    [fpa_intf.c, fpa_intf.h]
2020-05-08 ajout de KEEPs
2020-05-08 augmentation du network intf buffer (tentative de résolution pour #15154)
2020-05-12 correction de define en double
2020-05-15 Bugfix #15714 : Le module fpa du PelicanD plantait de façon aléatoire lors de changement de frame rate en acquisition.
    [Acquisition.c, GC_Callback.c]
2020-06-01 isc0207A: ajout du AcquisitionFrameRateMaxDivider pour limiter le frame rate max
2020-06-03 correction d'une contrainte de timing
2020-06-03 Merge Merged revision(s) 25266-25275 from FIR-00251-Proc/branchs/2020-04-23 - 3.2.x.x Releases non-cryptés: Tentative pour régler bug #15727 : On s'assure qu'un exptime invalide n'est jamais envoyé a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
    SCD : Corrections sans incidences
    Mise à jour HerculeD
    Merge tronc (r25209 à r25265)
    Correctif suite à la révision d'ODI.
    ........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
    [Acquisition.c, Acquisition.h, GC_Callback.c, SFW_ctrl.c, fpa_intf.c, fpa_intf.h]
2020-06-03 suppression de warnings
2020-06-04 suppression des debug cores du scorpiomwA
2020-06-11 V100: correction dans le reducteur de vitesse
    [fpa_intf.c]
2020-06-11 V100: re-correction dans le reducteur de vitesse
    [fpa_intf.c]
2020-06-12 isc0207A: nouvelle méthode de calcul pour limiter le frame rate max
2020-06-14 M3K: corrections requises pour IWR. Sinon, en ITR sans ces corrections le système fonctionne bien.
    [fpa_intf.h]
2020-06-23 M3K: 1) le problème de non sortrie d'image dû à un nombre insuffisant de samples pour le correcteur de l'offset électronique est corrigé. Les echantillons sont pris entre deux readouts et en nombre s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
    [fpa_intf.c, fpa_intf.h]
2020-06-24 0207 et 0804 : arrondi du calcul de ETmax
2020-07-01 Merged revision(s) 25354, 25391 from FIR-00251-Proc/branchs/2020-06-17 - xro3503A: corrections sans incidence sur pilotes FPA afpa: correction des contraintes de timing
    [fpa_intf.h]
2020-07-02 Merged revision(s) 25402 from FIR-00251-Proc/branchs/2020-06-17 - xro3503A: correction DATA_PATH_STAT: connexion de CFG_MISMATCH et bits inutilisés à 0 (aucun changement fonctionnel)
2020-07-10 Merged revision(s) 25422 from FIR-00251-Proc/branchs/2020-06-17 - xro3503A: FPA_DRIVER_STAT(19:18) connectés dans tous les hw_driver pour éviter fausses erreurs
2020-07-14 Désactivation de l'encryption
2020-07-16 Revert de deux commits fait par erreur dans le tronc (r25429 et r25428)
    [bd_wrapper.vhd, fir00251_proc_160_encrypt.xdc, fir00251_proc_325_encrypt.xdc, fir00251_proc_physical.xdc]
2020-07-17 isc0209A: ajustement de phase fait sur IRC1964 pour le compte de ISC0209A.
2020-07-20 isc0209A: correction variable non-déclarée
    [fpa_intf.c]
2020-07-30 Ajout des flags des pixels LDS, UDS, UCR, OCR
2020-08-05 Revert revision 25455 from FIR-00251-Proc/trunk: Ajout des flags des pixels LDS, UDS, UCR, OCR
    [pixel_saturation_repl.vhd]
2020-08-10 isc0209A: tentative de resolution du problème de non sortie d'image. Compiler le vhd SVP.
2020-08-10 Hawk: tentative de resolution d'un probable problème de non sortie d'image
2020-08-10 isc0207A: tentative de resolution d'un probable problème de non sortie d'image. scorpiomwA: est à jour à la version presente de svn. Aucune mise àjour particulière n'est necessaire pour l'instant.
    isc0207A_3K, isc0804A, isc0804A_500Hz attendront mon retour.
    isc0207A_3K subira un profond changement pour M1500. Il sera mis à jour en ce moment-là.
    isc0804 subira aussi un profond changement pour IWR. Il sera mis à jour en ce moment-là.
    isc0804A_500Hz: s'alignera sur isc0804A
2020-08-11 Modifications des source VHDL de calibration pour supporter la lecture par les 2 port à partir du FPGA. Cela fait partie des modifications pour sortir les LUT NLC et RQC du core de calibration et de 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
2020-08-11 ajout d'une switch pour muxer le port de lecture axi-lite et du fpga de la bram. Cela fait partie des modifications pour sortir les LUT NLC et RQC du core de calibration et de partager les LUT entre 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
2020-08-11 Modification du driver de calibration pour configurer la switch par des LUT NLC et RQC en mode lecture FPGA par défaut. Cela fait partie des modifications pour sortir les LUT NLC et RQC du core de ca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
2020-08-11 Modifications de la clock des interface AXI-Lite slave pour les LUT de NLC et RQC pour les connecter sur clk_cal (170 MHZ)
2020-08-13 modifier le generic du calibration core pour donner la bonne valeur
2020-09-01 MAJ pour coquilles dans sortie des LUT des core de calibration Modifications du generic de la LUT de RQC Modification du driver pour toggler la switch de LUT lors de la lecture de la LUT de RQC
2020-09-02 suphawkA: remise à flots à partir de 2.7.17.113
2020-09-03 suphawkA: mise à jour du testbench
    [compile.cfg]
2020-09-04 Ajout de la source LUT_native_switch dans le script de build de projet
2020-09-16 suppression du backslash de trop dans la commande GPS
2020-09-17 affichage moins ambigu des fractions de minute dans la commande GPS
2020-09-17 symbole de degré moins ambigu dans l'affichage de la commande GPS
2020-09-19 Correction à l'encodage des accents dans les commentaires du driver AD7980
    [ad798x_driver.vhd]
2020-09-22 baisse de la limite de TAPREF pour aider la prod dans le test des cartes. Aucune incidence ur l'existant.
2020-09-22 scd_proxy2: regroupera des fichiers genriques àutiliser pour les BB1920 et autres futures detecteurs utilisant la même acrhitecture scd
2020-09-23 suphawkA: correction connexion de QUAD2_CLK
2020-09-25 Ajustement au ADCReadout pour permettre une bande passante de 20 kHz sur l'entrée de lock-in pour le projet SERV2014 (#17763). La fréquence d'échantillonnage du AD7980 passe de 370 kS/s (originel) à 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
2020-09-30 tous les afpa: redefinition des termes pour une reutilisation facilitée de l'existant. Aucune incidence sur l'existant.
2020-10-03 scd_proxy2: chantier
    [compile.cfg, projlib.cfg]
2020-10-05 Serdes Clink : passe de 7 à 8 avec le generic DATA_WIDTH. Lorsque DATA_WIDTH = 8, alors Q8 est open. Aucune incidence sur l'existant.
2020-10-07 Merged revision(s) 25608-25774 from FIR-00251-Proc/branchs/2020-09-03 - BB1280: Suppression de l'ancien projet blackbird (on repart à neuf à partir d'un PelicanD) ........
    Ajout du détecteur blackbird1280D à la structure du projet.
    suphawkA: mise à jour du testbench
    Désactivation de l'encryption
    Ajout du détecteur blackbird1280D à la structure du projet (suite).
    Ajout du détecteur blackbird1280D à la structure du projet (suite).
    Ajout du détecteur blackbird1280D à la structure du projet (suite).
    Ajout du détecteur blackbird1280D à la structure du projet (suite).
    Ajout du détecteur blackbird1280D à la stru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
    [compile.cfg, projlib.cfg]
2020-10-07 Suite du merge r25779 -> Optimization des ressources dans le scd_data_ctrl. -> Mise à jour des rapports d'utilisation des ressources du Pelican (avec les optimizations). -> Correction d'une erreur au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
    [blackbird1280D_specific_physical.xdc]
2020-10-07 Suite du merge r25779 -> Suppression de repertoire inutile
2020-10-07 BB1280 : Optimization de la largeur d'un fifo.
2020-10-08 ajout d'un clink_receiver en prévision du BB1280D
    [compile.cfg]
2020-10-09 activation du flag de compilation parallèle dans les projets SDK
2020-10-09 BB1280 : -> Correction : Le module axis_32_to_64 était tenu en reset. -> Ajustement de la longueur d'un pipe (sans incidence)
2020-10-12 scscd_proxy2: reception de la condig serielle et structurelle marche. TODO. Faire venir par MB, les ID des differenes commandes
2020-10-15 correction contraintes de timings suite au merge du protocole Aurora64B66B pour les MGT (r25677)
2020-10-16 ajout de sources pour bb1920 serdes
2020-10-16 BB1280 : Utilisation de constantes génériques au lieu d'un define "IsBlackbird" pour discriminer entre les divers SCD
2020-10-16 HDER_INSERTER : Ajustement de la taille du fifo du header afin de pouvoir contenir un header complet en 1280x1024. La taille du fifo passe de 1024 à 2048. Aucun problème n'a été vue avec une profonde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
2020-10-16 pelicanD: build hw (à la rev r25810)
2020-10-19 scd_proxy2: simulation ok
    [compile.cfg]
2020-10-28 corrections calibration
2020-11-02 Préparation à la simulation
2020-11-03 scd_proxy2: simulation ok en 8 chn avec une version plus souple de scd_proxy2_line_mux.vhd
2020-11-03 afpa: augmentation du délai de power-on
2020-11-04 scdscd_proxy2: simulation ok en 8 chn avec fpa_progr_clk_div. TODO : permettre à ce que les coefficients de conversion du temps d'exposition viennent du microBlaze
    [compile.cfg]
2020-11-04 ajout des bus STAT dans le statut FPA
2020-11-05 tous les afpa: le coefficient de recinversion du temps d'integration (INT_CLK vers 100M Hz) provient maintenant d'un registre COMN. Ceci afin de faciliter l'integration de scd_proxy2 avec le BB1920.
2020-11-05 scd_proxy2: les coefficients de conversion du temps d'exposition viennent du microBlaze.
2020-11-06 bb19920 serdes: proposition de design.
2020-11-07 scd_proxy2: changement de nomenclature.
2020-11-09 Correction : erreur de compilation
    [DT_CommandsDef.c]
2020-11-10 Pre-release 5.0.x.0
    [compile.cfg]
2020-11-16 activation de la compilation parallèle pour le projet SDK du xro3503A
2020-11-16 suppression des critical warnings concernant le lane1 du MGT de storage
2020-11-17 bb19920 : chantier driver
2020-11-19 suppression des critical warnings liés au port de debug du MGT EXP
2020-11-19 Correction d'un bug de mauvaise configuration du buffering lorsqu'il y a un buffer externe pendant une actualisation (Bugfix #19629).
2020-11-19 correction au case de l'aide textuelle de la commande TEC
    [DT_CommandsDef.c]
2020-11-19 suppression des critical warnings liés au port de debug du MGT VIDEO
2020-11-19 suppression des critical warnings liés au port de debug du MGT DATA
2020-11-23 critère de cooldown moins sévère (refs #11223): - tolérance de ±10K autour de la température visée - temps de stabilité à 30s
2020-12-02 firmware TEC: éviter les multiples initialisations
2020-12-03 Bug fix #20206 - Activation par erreur du cooler dans l'initialisation du power ctrler.
    [DT_CommandsDef.c]
2020-12-05 modif au code du TEC pour éviter de faire planter le uBlaze lorsque le FPA ne fut pas encore initialisé
2020-12-06 tous les fpas: distinction entre ADC_QUAD_CLK_FACTOR et SAMP_NUM_PER_PIX pour une compréhension facilitée du code. Impact positif sur les detecteurs analogiques. Aucun impact sur les numeriques.
2020-12-07 probleme de simulation
2020-12-07 correction à la fréquence d'horloge du bus I2C suite au merge du firmware de TEC
2020-12-09 suppression de la référence à PC_BUFFER dans power_ctrl
2020-12-14 ajustement aux coefficients de gain/offset pour le senseur de courant suite à la nouvelle calibration de la courbe de réponse
2020-12-14 Commit de simulation final
2020-12-14 valeur initiale des GPIO
2020-12-26 tous les afpas: revision assignation
2020-12-29 simulation isc0804A et isc0207A : remise à flots du simulateur. Correction erreur de port dans afpa_single_div_ip. Simulation maintenant fonctionnelle même avec correcteur electronique.
2020-12-30 isc0804A: en mode patron de tests, on impose MODE_ITR_TRIG_START_TO_TRIG_START pour aller à la vitesse max du vhd. Ainsi, lorsque la vitesse maximale du patron de test est depassée, on verra que le f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
    [fpa_intf.c]
2021-01-03 xro3503A: correctifs pour éviter des bugs au demarrage.
    [fpa_intf.c]
2021-01-04 Correctifs bugs: annulation des modifs faites à la revision 26076.
2021-01-04 tous les fpas: aucune distinction entre le generateur de patron de ligne des iddcas analogiques et numériques. Code ainsi simplifié.
2021-01-07 bb1920 : simulation finale vhd
    [compile.cfg]
2021-01-12 ajout de la commande de debug PBT comme dans le Storage pour le buffering interne
2021-01-13 Bugfix #20494 - La désactivation du controlleur de trig lors de l'envoi de la commande de lecture de température avait été activé par erreur lors du développement de BB1280. Je me suis aussi rendu co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
    [fpa_intf.c]
2021-01-14 Correction - erreur nom de clock
    [fpa_intf.c]
2021-01-14 bb1920: simulation finale en cours. Une bonne partie est OK. TODO: decoder les bytes envoyés au proxy pour fins de validation.
2021-01-19 xro3503A: ajustement des phases
2021-01-26 correction redondance (aucune incidence)
    [fpa_intf.c]
2021-02-01 Ajout d'une documentation pour la Acquisition state machine (acquisition.c)
2021-02-04 xro3503A: ajustement des bias du FPA
2021-02-08 hawkA: revision limites de TAPREF pour aider la prod
2021-02-08 CLINK receiver : ajout de frm_rst pour accommoder le BB1920. Impact minime sur l'existant.
2021-02-10 PelicanD MS - Bug fix #21144
    [Acquisition.c]
2021-02-14 serdes BB1920 : chantier
    [compile.cfg, projlib.cfg]
2021-02-15 serdes BB1920 : simulation en bonne marche. On voit les EDGES et le calcul du delai optimal se fait tres bien. Reste à voir si les pixels et les identificateurs sortent correctement pour aller vers l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
    [compile.cfg]
2021-02-16 serdes BB1920 : simulation complete ok. TODO: 1) rendre generiques dans un define.vhd, les valeurs des ctrlBits. 2) rajouter la tension de polarisation dans le pilote.
2021-02-18 serdes BB1920 : les valeurs des ctrlBits sont dans proxy_define.vhd. Simulation complete ok à 320x256
2021-02-19 tous les fpa : introduction de nouveaux parametres: fpa_acq_trig_mode et fpa_xtra_trig_mode qui definissent les modes dans lesquels le contrôleur de trigs traitera les acq_trig et les xtra/prog_trig.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
2021-02-23 réduction du frame rate du ScorpioMWA pour le modèle SPARK M100 (#20656)
2021-02-25 bb1920: premiere implementation. On passe avec toute la procedure jusqu'à la generation du mcs. Il va rester maintenant à faire une simulation combinée serdes + module fpa.
2021-02-25 bb1920: fpa_acq_trig_mode et fpa_xtra_trig_mode sont recommandés pour les nouveaux designs. C'est ce qui est fait pour le bb1920.
2021-02-26 Par décision du PLM, le diviseur de frame rate pour le modèle SPARK M100 devient 1.65.
2021-02-27 bb1920: revision driverC
2021-03-04 M3K: chantier décentrage. TODO 1) valider les nouvelles equations dans matlab 2) simuler en vhd 3) reviser le fifo des integraions dans readout_ctler 4) simuler de nouveau puis compiler
2021-03-05 M3K: chantier décentrage. TODO 1) valider les nouvelles equations dans matlab (fait) 2) simuler en vhd (fait) 3) reviser le fifo des integraions dans readout_ctler (fait) 4) simuler de nouveau puis c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
2021-03-05 isc0207A_3k et isc0804A : suppression du fifo des integrations avec pour conséquence une reduction des risques de plantage du fw
2021-03-08 hawkA: suppression du fifo des inegrations. Simulationpassée avec succès.
2021-03-08 isc0207A: suppression du fifo des integrations. Simulation passée avec succès.
    [projlib.cfg]
2021-03-08 isc0209A: suppression du fifo des integrations. Simulation passée avec succès.
2021-03-08 fichiers/projets de simulation à jour
    [compile.cfg]
2021-03-08 suphawkA: suppression du fifo des integrations. Simulation passée avec succès.
2021-03-10 scorpiomwA: nouvelle mouture pour y inclure IMG_IN_PROGRESS en vue de securiser le changement de config et les nouveaux modes de contrôle du contrôleur de trig. Objectif: regler les problèmes des red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
2021-03-12 M3K décentré: compilation testée avec un debut de succes. TODO: choix echantillons et reduction des bandes
2021-03-14 M3K décentré: ajustement debut image fait avec succès. TODO: 1)corriger problème de decalage de colonnes en sous-fenetre 2)corriger problème de la fenetre 64x64 avec offsetX = 256 et offsetY = 0.
    [fpa_intf.c]
2021-03-16 Bugfix PelicanD & HerculeD : Nécessaire pour fonctionner avec les modifications du trig controller faites par ENO à la rev 26235.
2021-03-17 correction au script updateHwSvnRev pour exclure les .bak
2021-03-19 introduction de AOI_EOF pour une synchronisation plus robuste dans le module afpa_line_sync_mode_dval_gen.
2021-03-24 BB1280 : Correction merge
    [DT_CommandsDef.c]
2021-03-24 Calibration files v2.4.0 (#22091, #16228)
2021-03-31 Plusieurs correctifs :
    1. Retrait des printf de debug afin de régler le bug de non sortie d'image sur gige.
    2. La résolution de frame passe de 28 ns à 0.1 us.
    3. La résolution de frame est maintenant toujours la même.
    4. Changement des valeurs par défaut de FR et EXP_TIME.
    5. On ne force plus le mode patron de test pour debug avec proxy
    [fpa_intf.c, fpa_intf.h]
2021-04-05 bb1920 et scorpiomwa: fichiers de simulation
2021-04-05 Merged revision(s) 26346-26371 from FIR-00251-Proc/branchs/2021-03-16 - M3K_off_center: M3K :decentré. premiere compilation avec tete du tronc de common_hdl. Test fonctionnel avec succès. Les sss-fen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
    [fpa_intf.c, fpa_intf.h]
2021-04-05 Merged revision(s) 26366 from FIR-00251-Proc/branchs/2021-03-19 - M3K_off_center_fastrd2/src/Quad_serdes: introdution des versions v2 avec economie de ressources. Les modules sont créés pour tous les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
2021-04-06 scorpiomwA: utilisation de afpa_data_ctrl_v2 et afpa_data_deserializer_v2 pour reduction des risques de non sortie d'images. Ajustement des echantillons à faire et donc toute calibration anterieure s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
    [compile.cfg]
2021-04-07 xro3503A: compilation en 10, 27 et 40MHz en changeant seulement les constantes
2021-04-08 tous les afpa: le module afpa_chn_diversity_ctrler contient un fifo de profondeur 256 pour supporter les pixelrates élevés. Le nombre de BRAM utilisés par le nouveau fifo est identique à celui du fif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
2021-04-30 BB1920 : Mise à jour script de build
2021-04-30 BB1920 : Mise à jour contrainte de placement - Retrait des pins non connectées sur la EFA-00314-001 - Retrait des résistances de terminaison pour les signaux reset et integrate - Ajout des contrainte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
2021-05-05 BB1920 : Désinversion de la valeur du signal de reset
2021-05-12 BB1920 : Correction mauvaise largeur de bus (probablement sans incidence réel)
2021-05-12 BB1920 : Gestion des "control bits" différents en mode normal vs test pattern à partir du PROXY_ALONE_MODE.
2021-05-12 BB1920 : Correction calcul lval_length et lval_num pour la configuration du module des serdes.
    [fpa_intf.c]
2021-05-12 BB1920 : La commande sérielle doit être envoyé avant la structurelle. Sinon la lecture de température va geler l'envoi de la prochaine commande.
2021-05-12 BB1920 : Bugfix - Mapping des pixels selon la doc atlasdatasheet2.17ext.pdf - Gestion des "control bits" différents en mode normal vs test pattern à partir du PROXY_ALONE_MODE.
2021-05-19 ISC0804A: chantier pour regler les problèmes de non sortie d'image. Le Test Operation 02_04 passe sans planter mais problème de frame rate.
2021-05-20 Merged revision(s) 26347-26371 from FIR-00251-Proc/branchs/2021-03-16 - M3K_off_center: M3K Ghost: ajustement des echantillons effectués avec succès. Toute calibration prexistante sera caduque. .....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
    [fpa_intf.c]
2021-05-20 ISC0804A: bug de non sortie d'image et bug du temps d'integration reglés.
    [fpa_intf.c, fpa_intf.h]
2021-05-26 ISC0804A ITR Only: on fait un retour en arrière en ne supportant que ITR. Les modifs relatives au IWR ont été enlevées. Testé avec succès via test operationnel 2.4
2021-05-27 BB1280 (n'est pas supposé affecter PelicanD/HerculeD ) : - La résolution de frame est maintenant défini uniquement dans le vhd. Elle est lue par le driver C à l'initialisation. - Bugfix : la résoluti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
    [fpa_intf.c, fpa_intf.h]
2021-05-27 BB1280D/PelicanD/HerculeD : Le module scd_data_ctrl n'utilise plus le header pour se synchroniser. De toute façon depuis l'intégration du IWR, aucune information n'est extaite du header. De plus, cel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
2021-05-27 BB1280D/PelicanD/HerculeD (suite): Le module scd_data_ctrl n'utilise plus le header pour se synchroniser. De toute façon depuis l'intégration du IWR, aucune information n'est extaite du header. De pl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
2021-05-27 BB1280D/PelicanD/HerculeD (suite): Oublié d'enlever des attributs dont_touch
2021-06-02 BB1280D (possible impact sur PelicanD/HerculeD) : - Réafectation d'un registre pour retarder l'initialisation des SERDES après le cooldown et pour ignorer les responses failures pendant l'initialisat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
    [Acquisition.c, fpa_intf.c]
2021-06-04 branch 2021-03-16 - M3K_off_center dans le trunk
    [compile.cfg]
2021-06-09 ajout du FR dans la cmd ACT du Debug Terminal
2021-06-10 BB1280D : - Modification de la procédure d'initialisation (http://hawking/redmine/issues/17590) - Barrure de frame rate artificielle (M200hd vs M100hd)
    [Acquisition.c, fpa_intf.c, fpa_intf.h]
2021-06-10 BB1280D : Tout le développement précédent a été fait avec une carte DDC EFA-00273-001. À partir de cette révision les pins de reset et done de la proxy sont déplacées pour être compatible avec la nou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
    [blackbird1280D_specific_physical.xdc]
2021-06-11 BB1280D : Mise à jour script de build
2021-06-11 - architectures de axis_lut_X_to_ADD et param_lut_fifo renommées (rtl) différemment des entités - sources relatives aux LUTs déplacées dans Common\LUT
    [compile.cfg]
2021-06-15 BB1280D : - Ajout d'un registre pour gérer ou non les failure responses (D'ici à ce qu'on reçoivent plus d'explications d'SCD, BB1280 ne gère plus les failure responses). - Ajout d'une commande dans 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
    [fpa_intf.c]
2021-06-16 BB1280D : On a déjà une commande pour modifier le diode bias...
2021-06-21 tous les afpa et bb1920: DEFINE_FPA_PIX_SAMPLE_NUM_PER_CH devient DEFINE_DIAG_PIX_SAMPLE_NUM_PER_CH pour refleter le fait que ce parametre n'intervient que dans le mode DIAG (patron de tests Telops).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
2021-06-25 dfpa: clink_receiver_3ch utilisé pour tous les détecteurs numériques
2021-06-25 ordre dans les scripts build all
2021-06-27 build hw tous les fpa
2021-06-30 correction de la cmd ACT FR du Debug Terminal
    [DT_CommandsDef.c]
2021-07-09 startup: - enlève IO qui n'existe plus (PC_BUFFER, PC_SPARE) - meilleure gestion de l'affichage des tests XADC - affichage de l'intervalle valide des résultats des tests XADC - affichage des thermist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
2021-07-11 scorpiomw: backup. le header fast du fpa ne sort pas tout le temps. todo: à corriger
    [fpa_intf.c]
2021-07-13 génération des batch files de programmation par JTAG pour un release (DCI 12 480)
2021-07-15 Bugfix #21298 - En mode MS synchrone, des changements de FR en acquisition faisaient planter le module FPA.
    [Acquisition.c]
2021-07-15 xro3503A: nouvel estimé du délai vhdl en mclk dans le driver FPA qui corrige un bug en IWR (#22808)
    [fpa_intf.c]
2021-07-15 xro3503A: une augmentation de 1.5 MC pour vhd_delay_mclk suffit pour régler le bug #22808
    [fpa_intf.c]
2021-07-21 xro3503A: ajout d'une constante pour les délais internes du fpa_trig_controller et retour de vhd_delay à sa valeur d'origine (#22808)
2021-07-22 Bugfix #23716 : Envoi de commande opérationnelle invalide (PelicanD, HerculeD & BB1280)
    [fpa_intf.c]
2021-07-22 PROM: support des deux familles FL-S et FL-L de Cypress
2021-07-27 startup: - test des thermistors simplifié utilise 2 résistances (5k et 100k) en alternance
2021-07-27 startup: - mise à jour du test des GPIO de contrôle de power
2021-07-28 ajout d'un extern DeviceVoltageCalibrationAry pour accès dans tout le code (pas d'impact sur l'existant)
2021-07-28 startup: - toutes les lectures externes de voltage regroupées dans le test XADC External Voltage Reading (quelques-unes étaient dans XADC External Interface Reading) - ajout des 3 ADC References au t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
2021-07-29 startup: - ajout du SELFRESET dans le test des GPIO de contrôle de power
2021-07-30 startup: - correction de la fonction AutoTest_GetGlobalResult - amélioration de l'affichage dans le Debug Terminal - amélioration des structures de données de test
2021-07-30 startup: - cooler activé pour sa lecture de courant dans le test XADC Power Monitoring - ajout de print pour le SELFRESET dans le test des GPIO de contrôle de power
2021-08-03 correction indentation + enlève doublon déclaration
    [Acquisition.c]
2021-08-03 startup: - correction des tolérances des lectures de l'XADC en fonction des résultats expérimentaux
    [XADC_valid.h]
2021-08-04 startup: - ajout du test de détecteur - activation de la FW dans le même ordre que les autres dans le test des GPIO de contrôle de power - correction du SELFRESET dans le test des GPIO de contrôle de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
2021-08-05 BB1280 (aucun impact pour pelicanD et HerculeD): Intégration d'un module de cropping. Raison : L'électronique de proximité d'SCD ne sort pas le bon nombre de pixel pour certaine taille de fenêtre. Ce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
    [compile.cfg]
2021-08-05 correction au typo dans le script exportReleaseArchive.bat pour la programmation du Storage
2021-08-09 BB1280 : Cropping (retrait des dont_touch)
2021-08-09 BB1280 (aucun impact pour pelicanD et HerculeD): - Discrimination des fausses erreurs : L'électronique de proximité d'SCD retourne parfois des erreurs qui n'en sont pas. Ce problème est connu de leur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
2021-08-20 BB1920 : Bug de non sortie d'image en test pastern avec proxy. 1. Plus besoin de générer le pix_fval dans le scd_proxy2_dsync . Ce dernier est reconstruit dans scd_proxy2_real_data. 2. scd_proxy2_dsy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
    [fpa_intf.c]
2021-08-20 BB1920 (Bugfix) : Division par zéro lors de l'initialisation.
    [fpa_intf.c]
2021-08-24 BB1920 : 1. La fpa_intg_clk est maintenant calculé à partir de la frame_resolution qui est défini dans le VHD. La résolution de frame est fixé à 0.1us. 2. Il n'y aura pas deux profondeurs de puit mod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
    [fpa_intf.c]
2021-08-24 BB1920 (suite) 1. La fpa_intg_clk est maintenant calculé à partir de la frame_resolution qui est défini dans le VHD. La résolution de frame est fixé à 0.1us. 2. Il n'y aura pas deux profondeurs de pu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
2021-08-24 BB1280 : correction commentaire
    [fpa_intf.c]
2021-08-26 BB1920 : Voici une description sommaire des modifications que j'ai faites aux révisions 26761 à 26765, 26771 et 26789 :
    1. La première lecture dans le vhd du paramètre gPrivateStat.fpa_pix_num_per_pclk est faite avant qu'il est été écrit une première fois (ce qui est normal). La première lecture retourne donc 0 ce qui cause une division par 0 qui se fait dans la fonction FPA_SpecificParams() et qui cause un calcul de FRmax erroné. Pour corriger le problème je force une valeur par défaut (4 channels) lorsque le paramètre est non-initialisé.
    2. Correction d'un bug lié au mode proxy_alone.
    3. La clock "fpa_intg_clk_rate_hz" est maintenant calculé à partir d'un define : FRAME_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
    [fpa_intf.c, fpa_intf.h]
2021-08-27 BB1920 : Update test bench
    [compile.cfg, projlib.cfg]
2021-08-31 BB1920 : Bugfix d'un problème d'init intermitant qui fait parfois planter le module détecteur. Des xtra_trig/prog_trig était envoyés avant que le module des SERDES soit complètement initialisé. Maint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
    [fpa_intf.c]
2021-09-01 BB1920 : Activation de la même mécanique de changement de FR en acquisition utilisé par les autres SCD (PelicanD, HerculeD et BB1280)
2021-09-10 xro3503A: correctif pour le bug de non-sortie d'image (#23725)
2021-09-16 TRIG: décodage MB correct du registre pps_source pour éviter que la fonction TRIG_GetPpsSrc() retourne toujours 0xffffffff
2021-09-16 suppression des espaces superflus dans le commit précédent
2021-09-24 TRIG: synchronisation de ACQ_INT pour éviter le risque de métastabilité qui conduit à l'échec de la détection du front du signal d'intégration (#23082)
    [trig_gen.xlsx]
2021-09-24 xro3503A: ajustement des bias du FPA pour EFA-00305-002 avec Rg à 1k
2021-09-28 GATING: diminution du risque de métastabilité lors de la détection du front du signal d'intégration
2021-09-28 FLAGGING: diminution du risque de métastabilité lors de la détection du front du signal d'intégration
2021-09-28 meilleur respect de la nomenclature en place pour les deux commits précédents
2021-09-28 TIME_STAMPER: diminution du risque de métastabilité lors de la détection du front du signal d'intégration
2021-09-28 ADCreadout: diminution du risque de métastabilité lors de la détection du front du signal d'intégration
2021-09-30 SCD (Hercule, Pelican, BB1280) : Mauvaise configuration du exposure_time_ctrler lorsqu'on est en MS ou EHDRI (Bugfix #24909)
    [Acquisition.c]
2021-10-04 xro3503A: sync du readout pour éviter le risque de corrompre l'état de la FSM fpa_digio_fsm par incident de métastabilité
2021-10-04 xro3503A: transfert multi-domaine robuste du bus de données de # sériel de config FPA (précaution pour #23725) (synchronisation des données avec encodage Gray pour s'assurer qu'un seul bit change à l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
2021-10-04 SCD (Hercule, Pelican, BB1280) : Problème avec l'AEC lors de changment de FR en acquisition (Bugfix #24909)
    [Acquisition.c, FWController.c, GC_Callback.c]
2021-10-05 fichier Aldec oublié pour l'ajout de gh_binary2gray
    [compile.cfg]
2021-10-06 SCD (Hercule, Pelican, BB1280) : Mauvaise gestion du ClearMem de l'AEC lorsque frame flaggé "FilterWheelInTransition" est envoyé dans la chaine de donnée (Bugfix #24964)
2021-10-07 xro3503A: commande de debug TEC indisponible par défaut (n'est plus utile)
2021-10-14 BB1920 : 2 bugfixs 1. La config de temps d'exposition n'était jamais écrite dans la BRAM car le TVALID était toujours à '0'. 2. Le temps d'exposition était appliqué avec une config de retard.
2021-10-18 xro3503A: migration de l'encodage Gray de mblaze_intf vers prog_ctler_core
2021-10-20 xro3503A: gestion du saut de lecture de la diode FPA à l'allumage (#23547) - nouvelle plage de température permise: -20 à 35 °C
2021-10-20 xro3503A: limite inférieure de température placée à -5 °C
2021-10-21 xro3503A: fichier Aldec oublié dans le commit pour régler le bug #23547
    [compile.cfg]
2021-10-22 build hw du startup en 325t avec les MGT 2 channels (ATTENTION: les modifications des sources ne sont pas committées)
2021-10-22 startup en 325t avec les MGT 2 channels (ATTENTION: les modifications des sources ne sont pas committées)
2021-10-22 xro3503A: introduction d'un temps mort de lecture de la température durant le ramp-up de l'allumage du FPA - réparation de la régression du testbench suite l'introduction du nouveau champ de config f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
2021-10-25 xro3503A: limites de température qui utilisent la calibration diode fpa plus récente plutôt que l'ancienne
2021-10-27 afpas: sync de cfg_num pour éviter le risque d'injection de métastabilité lors de l'envoi d'une nouvelle config
2021-11-05 correction des generic DATA_WIDTH et RESET200ms qui étaient hardcodés
2021-11-08 BB1920 (chantier) : - Retrait du mode PROXY_ALONE. - Ajout d'un mode pour ignorer les failure responses (scd_proxy2_serial_com.vhd). - Retrait de la gestion d'un feedback d'intégration. - Ajout d'un 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
    [fpa_intf.c, fpa_intf.h]
2021-11-08 revert des changements pour la source courant (r25910) inutiles avec EFA-00305-002 qui a sa propre source courant
2021-11-11 Bugfix (SCD) : Oublié d'inclure un .h lors du bugfix commité à la rev 26844.
    [FWController.c, GC_Callback.c]
2021-11-12 ajout d'une protection pour ne pas utiliser la calibration de l'XADC pour une carte 251 v0
2021-11-23 Bugfix BB1280 : - Mauvaise gestion de la config de serdes au niveau du xsize depuis l'intégration du cropping (#25698) - La saturation des puits faisait échouer la procédure d'initialisation des SERD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
    [fpa_intf.c]
2021-11-29 Bugfix BB1280 (sans incidence réelle sur PelicanD et HerculeD): - Échec de l'initialisation du proxy lorsqu'il n'y a pas d'xtra_trig (i.e trig externe) (#25312) - Ajustement de la configuration du gé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
    [Acquisition.c, Acquisition.h, fpa_intf.c, fpa_intf.h]
2021-11-30 Bugfix BB1280 : Correction
    [Acquisition.c]
2021-11-30 Bugfix BB1280 (sans incidence réel sur PelicanD et HerculeD): On ne passe plus par le registre "ExposureTimeSetToMin" pour imposer un temps d'exposition minimal pendant la procédure d'initialisation 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
    [Acquisition.c, fpa_intf.c, fpa_intf.h]
2021-12-01 BB1920 : Ajout des sources du module serdes dans aldec
2021-12-06 BB1920 (chantier) : Le module des SERDES passe sur 4 canaux
2021-12-07 BB1920 : Changement de nom de signaux sur interface (sans incidence)
2021-12-07 BB1920 : 1. La TX_LCK passe à de 140MHz à 100MHz (la durée du LVAL_PAUSE le permet). 2. On restraint le domaine de clock de la TX_CLK exclusivement après le scd_proxy2_line_mux.vhd.
2021-12-14 Gestion d'une plateforme hardware à 4 DDR * Attention : Touche la partie commune à tous les détecteurs (supposé sans incidence). * Ajout d'un 3ième "Bloc Design" spécifique à une carte 251 avec 4 DDR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
2021-12-14 Gestion d'une plateforme hardware à 4 DDR (suite)
2021-12-14 BB1920 : Gestion d'une plateforme hardware à 4 DDR * Ajout du linker script spécifique au BB1920.
2021-12-15 utilisation de la valeur venant du module FPA pour déterminer si le cooler est ON dans le calcul de la statistique DeviceCoolerRunningTime. (nécessaire pour xro3503A, transparent pour les autres)
2021-12-15 Gestion d'une plateforme hardware à 4 DDR (suite) * Pas besoin d'avoir un linker script spécifique pour l'architecture à 4 DDR. * Pas besoin de définir le address space de la mémoire de calibration d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
2021-12-15 Gestion d'une plateforme hardware à 4 DDR (suite) * On utilise des primitives IOBUFDS_DIFF_OUT_DCIEN pour interfacer les deux DDR non utilisées.
2021-12-15 Gestion d'une plateforme hardware à 4 DDR (suite) * Ajout des sources du frame buffer à tous les projets de détecteurs. * Retrait des #ifdef.
2021-12-15 Gestion d'une plateforme hardware à 4 DDR (suite) * Changement de nom de librairie pour éviter un conflit de nom
2021-12-15 Gestion d'une plateforme hardware à 4 DDR (suite) * L'interface uB du frame buffer est désormais toujours instanciée.
2021-12-15 Gestion d'une plateforme hardware à 4 DDR (suite) * On aligne le Bloc Design du 160T sur les modifications récentes faites sur celui du 325T. * Ajout d'un port AXILITE pour la configuration du frame 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
2021-12-16 Gestion d'une plateforme hardware à 4 DDR (suite) * J'avais oublié d'updater le address map du Block Design quand j'ai ajouté le nouveau port de contrôle AXILITE pour la config du frame buffer.
2021-12-21 xro3503A: échantillonnage des 16 colonnes précédentes pour corriger la calibration en sous-fenêtre (#23441)
    [fpa_intf.c]
2021-12-22 Gestion d'une plateforme hardware à 4 DDR (suite) * Ajout des sources du frame buffer dans la version debug des projets.
2021-12-23 Build HW (tous les détecteurs)
2022-01-10 Gestion d'une plateforme hardware à 4 DDR (suite) * Correction erreur define
2022-01-10 Frame Buffer : M-à-j testbench
2022-01-10 AFPA: ajout module de cropping, mais n'est pas connecté pour l'instant. Sources copiées de SCD_PROXY2.
    [compile.cfg]
2022-01-11 correction faute de frappe (aucun impact)
2022-01-12 xro3503A: module de cropping fonctionnel (#23441)
2022-01-13 Gestion d'une plateforme hardware à 4 DDR (suite) * Corrections scripts
2022-01-14 FrameBuffer : * Ajout de mesureurs de frame rate en entrée et sortie du module. * Ajout d'une commande dans le DT pour afficher les frame rates (comme on fait pour les frame buffers du fpga de output)
2022-01-14 xro3503A: ajustement de CTIA Ref à 2.6V (#25971)
2022-01-14 xro3503A: ajustement de la phase des horloges REGC à 0 et REGD à 208 (#25979)
2022-01-17 Gestion d'une plateforme hardware à 4 DDR (suite) * Optimization scripts
2022-01-19 xro3503A: ajustement de CM à 1.75V (#25971)
2022-01-20 FrameBuffer : * La clock S2MM du datamover du frame buffer est maintenant la CLK_DIN en provenance du VHD.
2022-01-21 BB1280 : Mise-à-jour de test pattern du manufacturier (SCD_PE_TEST1)
2022-01-21 BB1280 : * "Height inc" et "Height min" passent de 4 à 8 (les multiples de 4 font varier l'offset des pixels) * Retrait du TDC flags "HighGainSWDIsImplementedMask"
2022-01-26 Frame buffer (chantier): * Ajout d'un throttle sur la lecture des données. Il ajoute des pauses entre les lignes car le lien clink du fpga de output ne supporte pas un plein throughtput de 340 MPix/s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
2022-02-02 Frame buffer (candidat potentiel): * Utilisation des tags dans l'envoi des commandes et la réception des statuts. * Refonte de la mécanique de sélection des buffers. * Retrait du fb_manager.vhd * Ret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
2022-02-03 Frame buffer : * MAJ projet Aldec
2022-02-04 xro3503A: ajustement de valeurs par défaut
2022-02-07 Frame Buffer (sans incidence): Indentation et ajout de commentaires
2022-02-07 FrameBuffer: retrait de la référence à fb_manager.vhd dans le script de build (source mtn inexistante)
2022-02-08 ajout de contraintes par FPGA_SIZE pour y mettre les contraintes des MGT (enlevées des contraintes spécifiques au détecteur)
2022-02-09 BB1920 : Correction d'une erreur de connexion de net de FPA_SERDES_STAT sur le scd_proxy2_hw-driver.
2022-02-09 contraintes de timing du isc0207A qui conviennent au startup
2022-02-09 BB1920 : Modification de la mécanique pour signifier au scd_proxy2_hw_driver que les serdes sont prêt.
2022-02-09 isc0207A: ajout du generic MGT_2CH au top-level pour qu'il puisse être spécifié dans le startup. Pour changer la valeur de MGT_2CH pour le isc0207A, il faut modifier la valeur par défaut.
2022-02-09 startup: compilations 160 et 325 sans avoir à modifier les sources: - top-level dédoublé avec generic MGT_2CH différent (160 à false, 325 à true) - top-level 160 et 325 ont le même nom d'entité pour 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
    [compile.cfg]
2022-02-09 contraintes de timing du video_mgt ajouté aux contraintes par FPGA_SIZE
2022-02-10 script SDK avec argument pour traiter séparément les FPGA_SIZE
2022-02-11 BB1920 : * Bugfix dans le scd_proxy2_dsync : Le bug était intermittant d'un build à un autre. Les FSM de controle des fifos se ramassaient dans des états non définis. Cela était dû au fait qu'elles u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
2022-02-15 Frame Buffer (sans incidence): * Ajout d'un fifo en sortie * Correction valeur clock pour mesureur de frame rate en écriture.
2022-02-22 BB1920 : * Mise à jour des constantes du modèle (INTG_DLY, FR_DLY). * Ajout d'un facteur de correction pour aligner les performances du modèle de SCD sur les performances réelles mesurées. * Ajout d'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
    [fpa_intf.c, fpa_intf.h]
2022-03-03 BB1920 : * Refonte du line_mux pour régler 2 bugs : 1- Le data des lignes impaires n'était jamais updatés. 2- Les 2 dernières transactions de 4 pixels au fin des le ligne était toujours identiques. *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
    [compile.cfg]
2022-03-04 Frame buffer : * Le writer n'attend plus le feedback du data mover pour updater l'emplacement du prochain frame à écrire. * Le writer gère maintenant le cas ou il n'y a aucune pause entre la fin d'un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
2022-03-04 SCD : uniformisation des noms de fonction (supposé sans incidence)
2022-03-09 Frame buffer : * LVAL_PAUSE_MIN passe à '1'. C'est la limite du clink fast. * Debug de la reception de nouvelles configurations. * MAJ test bench.
2022-03-09 BB1920 : * Ajustement du modèle pour le IWR (Pas encore testé de façon extensive).
2022-03-09 Frame buffer : * Bugfix IWR
2022-03-14 Frame Buffer : Ajout d'un contrôle sur la durée du FVAL_PAUSE.
2022-03-14 BB1920 : * IWR : Ajustement de la correction sur le "exposure time max". * IWR : Correction d'un bug qui sortait en EHDRI. Il faut "clocker" la sortie du IMAGE_INFO sur une clock de 100MHz (sinon pb 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
    [fpa_intf.c]
2022-03-14 PelicanD : Correction d'une non-réciprocité dans les calculs du modèle FR(EXP_TIME).
    [fpa_intf.c]
2022-03-21 BB1920 (candidat pour release): * "Height Inc" passe de 2 à 4 (fenêtre centrée). * Ajout de quelques commentaires
2022-03-21 Frame buffer : * Ajout commentaires
2022-03-22 BB1920 : On annule des modifications qui avait été faites au niveau du watchdog pour du debug.
2022-03-24 xro3503A: ajout de DetectSub, CTIA_Ref, CM et CTIA Bias dans les flash settings (v2.12.0) pour gérer les différences entre les individus
2022-03-25 correctif au driver XRO3503A pour la gestion des flash settings v2.12.0
    [fpa_intf.c]
2022-04-04 Bugfix #26514 (Problème d'oscillation de l'AEC) : On reset maintenant l'histogramme tant que le PET n'a pas été réellement appliqué.
    [AEC.h]
2022-04-04 Bugfix #26514 (Problème d'oscillation de l'AEC) : Ajout commentaire
2022-04-05 Bugfix #26514 (Problème d'oscillation de l'AEC) : Ajustement du critère de temps pour éliminer un phénomène d'oscillation d'une amplitude de 0.1us en régime permanent.
2022-04-06 mise à jour de l'actualisation: - bug fix d'update des Beta toujours fait à partir des quantizedDeltaBeta (int) puisque la deltaBeta (float) peut contenir les données de n'importe quel bloc (#27841) 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
    [Actualization.c, Actualization.h, DT_CommandsDef.c]
2022-04-07 BB1280 : On retire l'option d'utiliser le test pattern manufacturier (il ne fonctionne pas). Besoin d'une semaine de travail pour le réparer.
2022-04-07 Partie commune : Optimisation des ressources (interface DDR et interconnect périphérique)
2022-04-07 exp2f est réputé être plus efficace que powf en base 2
2022-04-11 Le décimateur n'est plus spécifique au SDI. Il devient générique et a été déplacé dans le FIR-00251-Common pour être aussi utilisé par le module de l'AEC (aucun changement fonctionnel).
2022-04-12 AEC : Ajout d'un décimateur pour gérer des tailles de fenêtre trop grande pour les bins de l'histogramme. Lorsqu'il est actif, le décimateur discarte une ligne sur 2. Il s'active seulement si le nomb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
2022-04-19 AEC : Réinitialisation du timestamp lorsqu'on désactive l'AEC pendant une acquisition. Le premier deltaT calculé lors d'une désactivation/réactivation de l'AEC était abérant (ce bugfix n'a pas d'impa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
2022-04-19 BB1920 : On règle ici un bug introduit à la r27183. Il y avait un décalage entre les lignes paires et impaires (ce qui créait un "ghost" dans l'image). L'init des serdes ne converge pas en même temps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
2022-04-21 Gestion d'une plateforme hardware à 4 DDR (suite) * On utilise le MSB du brd rev id pour détecter si la 251 possède 2 ou 4 DDR. * On prend un bit dans les TDCFlags2 pour signifier au TSIRINFO le nomb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
2022-04-22 BB1520 (chantier) : ajout de sources
2022-04-26 MAJ script de build
2022-04-27 Pre-release 5.2.x.0
    [compile.cfg]
2022-05-02 AFPA: génération du flag 5 adc_sync_flag (pulse de l'horloge ADC) dans le contrôleur de readout en vue d'un futur passage au SERDES_v2
2022-05-03 BB1920 : Correction dépendance script de build
2022-05-04 xro3503A: suppression du firmware de TEC qui n'est plus nécessaire
2022-05-05 changer l'ordre du built-in test BoardRevisionValidation pour éviter un écrasement de valeur
2022-05-05 IRIGB: seules les données reliées au DVAL sont copiées lorsque celui-ci est à 1
2022-05-10 actualisation: correction des modes de debug
    [Actualization.c]
2022-05-16 Correction au batch de programmation pour aller chercher correctement PROM-JTAG-Bridge sur le réseau
2022-05-17 le changement de PATH n'est plus nécessaire dans le batch de programmation par JTAG
2022-05-17 xro3503A: DETECTSUB permet 2.8V
2022-05-18 BB1920 : * Valeur de MTX_VDET modifié pour sa valeur par défaut (60mV à 100mV) * Valeur de MTX_INTG_LOW modifié pour sa valeur par défaut (2.6V à 2.4V)
2022-06-13 BB1520 (Bug fixe) : * Un FPA_WIDTH_MAX de 1520 ne peut pas être utilisé par le module FPA. Le module FPA doit toujours configurer une largeur de 1920 pixels.
    [fpa_intf.c, fpa_intf.h]
2022-06-13 AEC (bugfix #28650) : Ajustement du seuil permettant de determiner si on doit recalculer un nouveau exptime.
    [AEC.h]
2022-06-14 isc0209A: tentative de résolution du bug #28622. passage en fpa_data_ctrl_v2 et serdes_v2 pour reduire les delais des pipes de données. Conséquence: le compteur des pixels donne le bon nombre de pixe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
2022-06-14 ISC0209A: Les données sortent de la camera. le bug ne se reproduit pas avec la config problématique. TODO: reviser le delai du pipe dans afpa_data_dispatcher et faire le test d'ajustement de phase.
    [compile.cfg, library.cfg]
2022-06-14 isc0209A: bug #28622 semble reglé. Validé avec succès du test operationnel 02_04.
    [fpa_intf.c]
2022-06-20 -pixels négatifs suite à la soustraction de l'offset remplacés par le tag LDS (#28138) -mise à jour du testbench de la calibration
    [compile.cfg, library.cfg]
2022-06-20 scorpiomwA: on déploie la solution de ISC0209A afin de corriger des problèmes potentiels.
    [fpa_intf.c]
2022-06-20 revert de mon erreur.
2022-06-20 les détecteurs analogiques susceptibles d'avoir le problème du ISC0209A , sont mis à jour.
2022-06-23 ajout d'un testbench pour l'interface AXIL des LUT de la calibration
2022-06-23 correction de la lecture de la LUT (BRAM) par AXI_LITE (#15753)
    [Actualization.c]
2022-06-30 startup: correction des valeurs attendues de VCCAUX_IO_P et VCCAUX_IO_O
    [XADC_valid.h]
2022-07-04 BB1920, BB1520 : * Uniformisation BB1920 vs BB1520 * Implémentation bugfix #28588 sur BB1520 * Mise à jour valeur MTX par défaut pour BB1520. * Bugfix #28836 : le problème de sous-fenêtrage non centr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
    [fpa_intf.c, fpa_intf.h]
2022-07-07 xro3503A: - DetectSub par défaut à 3.5V (#28647) - vérification des valeurs de VTestG et VCMO avant de les appliquer
2022-07-11 superhawkA: solution au bug redmine #28901.
    [fpa_intf.c]
2022-07-12 activation des exceptions plus tôt pour utilisation du QSPI (uBlaze debug)
2022-07-21 quad_data_sync_v2: les signaux busy constituent des statuts de sortie d'un IP et n'ont pas besoin de valeurs initiales
2022-07-21 quad_data_sync_v1: tentative de régler le problème de plantage du script de déphasage qui persiste
2022-07-21 intégration à S1K de la solution pour le reset des FIFOs asynchrones (#29221)
    [fpa_intf.c]
2022-07-21 xro3503A: correction de VTestG qui prend la valeur 0
    [fpa_intf.c]
2022-07-28 correction script verifyRelease qui détectait mal les revisions du BuildInfo
2022-07-28 tous les afpa: uniformisation du FPA_DRIVER_STAT (sans impact sur l'existant)
2022-07-28 isc0207A prêt pour intégration sur une Smart ADC (sans impact sur IRCAM)
2022-08-03 xro3503A: ajustement de la phase pour minimiser le ghost (#29502)
2022-08-06 revert du merge dans le tronc de la gestion du reset des AFIFOs en provenance de la branche "scorpiomwA ENO": - causait une régression sur la caméra S1K à cause du nouveau module de SERDES partagé pa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
    [fpa_intf.c]
2022-08-10 Revert des modifications faites aux IPs à la révision 27700 qui causent un bug de non sortie d'image avec BB1920.
2022-08-18 Header inserter (BB1920) : La lecture du header réordonné en BRAM se fait maintenant sur 4 pixels de large au lieu de deux. BB1920 faisait rouler le module de header inserter sur 140MHz. La qualif a 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
2022-08-18 Header inserter (BB1920) : La lecture du header réordonné en BRAM se fait maintenant sur 4 pixels de large au lieu de deux. BB1920 faisait rouler le module de header inserter sur 140MHz. La qualif a 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
2022-08-19 FrameBuffer : MAJ Testbench
2022-08-26 Optimization interface DDR : L'intégration du bugfix #131811 (lecture header en BRAM sur 4 pixels de large) a étrangement fait sortir un problème de timming. Le problème est que les timmings ne passe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
    [bd_wrapper.vhd]
2022-09-02 Actualisation : Ajustement d'un timeout pour rencontrer les exigences de BB1920. Le timer était à 60 secondes et on a besoin de 69 secondes. J'ai donc augmenté le délai à 90 secondes.
2022-09-08 Ajout de la mention d'envoyer un courriel suite à la relâche
2022-10-04 SERDES (PelicanD, HerculeD, ScorpioMWD, ScorpioLWD, ScorpioLWD_230Hz) : Le critère de STAB_AREA_WIDTH_MIN est maintenant calculé au lieu d'être hardcodé à 14. Cela permet de régler un problème vue su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
2022-10-13 BB1920 : Correction d'un bug de sous fenetrage. Le height min du détecteur passe de 4 à 8.
    [fpa_intf.c, fpa_intf.h]
2022-10-18 Optimization DDR : Correction d'une erreur de connexion sur le BD à 2 DDR (160T et 325T) introduite à la rev 27814.
2022-10-21 Download clink : Bugfix
    [GC_Registers.c]
2022-10-27 Detection HW 4DDR vs 2DDR : On utilise le 8ieme bit du rev id pour la détection du nombre de DDR. Il y avait seulement les 4 premiers bits d'utilisés. * Les IOs suivants on été retirés : R_FLASH_IO8,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
2022-11-01 Startup: Ajout d'un firmware de startup pour la carte 251 avec 4 DDR.
2022-11-22 print de la progression pendant l'actualisation (#31234)
2022-11-28 build hw tous les fpa (1 de 2)
2022-11-28 CLINK: Le critère de STAB_AREA_WIDTH_MIN est limité à 14 pour éviter des valeurs trop grandes dans le cas des détecteurs lents
2022-11-29 build hw tous les fpa (2 de 2)
2022-11-29 configuration de la compilation en Release dans un catch pour empêcher que la procédure create_proc_sw plante
2022-12-08 BB1520 : Resynchronisation avec recent bugfix de BB1920.
    [fpa_intf.c, fpa_intf.h]
2022-12-22 isc0804A: ajustement des phases
2023-01-10 BB1920 : Plantage du module FPA à frame rate lent (Bugfix #31455)
2023-01-13 correction électronique: ajout d'un mode référence constante pour permettre le fonctionnement des modes ELCORR_MODE_OFFSET_CORR_WITH_DYN_RANGE_COMP et ELCORR_MODE_OFF_WITH_DYN_RANGE_COMP
    [fpa_intf.c, fpa_intf.h]
2023-01-24 La détection des bad pixels est faite une seule fois
2023-01-24 à l'init on supprime tous les fichiers d'actualisation
2023-01-25 une invalidation d'une actualisation ICU supprime la map de bad pixels
2023-02-08 Suppression de module
2023-02-27 startup: mesures de l'XADC arrondies à 3 décimales pour éviter la contradiction avec les print
2023-02-28 startup: ajout des lectures de l'XADC du FPGA d'Output au test XADC Internal Voltage Reading
2023-03-01 correction de la commande FPA avec argument ETOFF. Toujours utiliser la fonction GetNextArg avec sizeof comme longueur
    [DT_CommandsDef.c, DT_CommandsDef_startup.c]
2023-03-02 correction: les macros _PCF et _FFMT ne fonctionnent pas avec un argument qui est un define ou une variable
    [XADC_valid.h]
2023-03-02 startup: - le flag WaitingForOutputFPGA doit être baissé avant de lancer les tests ATR - correction des tolérances des lectures de l'XADC en fonction des résultats expérimentaux
    [DT_CommandsDef_startup.c, XADC_valid.h]
2023-03-17 ajout de afpa_data_cntrl_16chn_v2 au projet Active-HDL pour pouvoir entrer dans le BDE
    [compile.cfg]
2023-03-27 ISC0209A: valeur de target changée pour tenir compte des offsets négatifs obtenus lors de la calibration de IRC22099
2023-04-05 mockfpa : update aldec project
    [compile.cfg]
2023-04-06 - correction connexion du fifo de sortie hawkA et isc0207A (bug introduit r28423) - isc0804A_500Hz: correction connexion DOUT_FIFO_ERR (bug introduit r24928) - correction configuration fifo asynchron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
2023-04-12 isc0207A: - passage au serdes v2 - ajustement des phases d'horloges - mise à jour du testbench
2023-04-13 Startup_4DDR (bugfix non sortie d'image)
    [fpa_intf.h]
2023-04-13 le script tcl doit spécifier la taille 325 puisque le 160 n'existe pas
2023-04-27 suphawkA: ajustement des phases d'horloges
2023-04-27 startup: - correction de la commande ATR qui traitait mal ses arguments - correction du test détecteur qui nécessite maintenant les cartes de proxy et ajustement du timeout
    [DT_CommandsDef_startup.c]
2023-07-12 fichiers de simulation
2023-07-21 Merged revision(s) from FIR-00251-Proc/branchs/2023-02-07 Architecture V1 - Phase 2:
    [compile.cfg]
2023-07-24 get encryptation status : ajout du cas registre est dans la ligne suivante
2023-08-03 cleanup automatique des sources superflues dans le projet Vivado
2023-08-04 Tous les afpa : ajout du generate DEFINE_GENERATE_DYNRANGE_CTRL_CHAIN qui permet de couper la plage dynamique du detecteur. Utilisé seulement sur le modèle M2K-UD. L'ajout n'a aucune incidence sur to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
2023-08-24 ajout pour le contrôle de la plage dynamique
2023-08-31 cleanup automatique d'IP superflus dans le projet Vivado et suppression des critical warnings de l'implémentation
2023-09-08 suppression de fichiers inutilisés dans les testbench FPA
2023-09-08 test pattern prêt à fournir des données sur 24 bits (aucune incidence sur l'actuel)
2023-09-18 M2k UD: upgrade des IPs pour Vivado 2018.3
2023-09-18 isc0804A_2k: on peut permettre une pause de ligne de 1 MC avec architecture V1
2023-09-19 isc0804A_2k: migration des projets SDK
2023-09-19 isc0804A_2k: migration des scripts de bin
2023-09-19 isc0804A_2k: adaptation de l'interface FPA pour Architecture V1
2023-09-19 isc0804A_2k: changement du device name
2023-09-19 isc0804A_2k: la pause de ligne en mode diagnostique devient 1 avec Architecture V1
2023-09-20 isc0804A_2k: la sortie finale de pixels demeure sur le domaine de 100 MHz
2023-09-21 isc0804A_2k: on active le réducteur de vitesse
2023-09-21 isc0804A*: adaptation des testbenches
2023-09-21 isc0804A_2k: le nom du core doit aussi changer pour l'activation du réducteur de vitesse
2023-09-22 augmentation de la profondeur max du rapport d'utilisation hiérarchique
2023-09-25 correction d'une violation des pratiques CDC dans le EHDRI qui pourrait corrompre la machine d'état suite à l'augmentation de vitesse du datapath de M2K UD. (Le problème aurait pu se présenter avec u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
2023-09-27 activation du flag de compilation du Framebuffer (4DDR) pour M2k UD
2023-09-28 testbenches isc0804A*: ajout des IPs de simulation manquants
2023-10-04 isc0804A*: minimisation d'un risque de corruption de la FSM digio par violation de pratique CDC
2023-10-04 isc0804A_2k: suppression du throughput controller qui est redondant avec le réducteur de vitesse
2023-10-05 trig_precontroller: minimisation d'un risque de corruption d'une FSM par violation de pratique CDC
2023-10-05 isc0804A*: minimisation d'un risque de corrompre une FSM dans le correcteur électronique par violation de pratique CDC
2023-10-05 trig_precontroller: on donne la bonne valeur de départ au synchronisateur de diag_mode (1 plutôt 0)
2023-10-06 MAJ des XCI des IP pour inclure les 2 patchs
2023-10-11 Build HW (tous les detecteurs)
2023-10-11 Release 6.0.x.0
    [compile.cfg]
2023-10-13 PROCEDURE RELEASE NON FONCTIONNEL * Revert des 3 derniers commits
    [compile.cfg]
2023-10-13 Ajout de netlist d'IP pour simulation
2023-10-19 revert du commit de la branche d'optimisation des BRAM de calib qui cause une régression
    [compile.cfg]
2023-10-23 ajout du sensorID pour le calciumD
2023-10-27 Pour le script de release par JTAG, on programme le NTx_Mini seulement à la fin. En prod, cela arrive souvent qu'ils doivent programmer des cartes par JTAG sans le NTx-Mini.
2023-11-03 ajout d'un opérateur floating point pour calculer la puissance (exponentiation)
2023-11-06 ajout de fichier de simulation
2023-11-08 ACT (Bugfix #35772) : L'actualisation ne fonctionnait pas en mode synchrone. Le problème a été introduit à la révision r27284.
    [GC_Callback.c]
2023-11-09 maj script release et clean up pour que le tout fonctionne tcl retourne error generatePromFile simplifié
2023-11-09 MIGRATION VIVADO2018 (Correction warning) : ['%s' directive output may be truncated writing up to 255 bytes into a region of size 128] L'ajout d'une protection pour ne pas écrire une string plus long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
    [DT_CommandsDef.c, FileManager.c]
2023-11-09 MIGRATION VIVADO2018 (Correction warning) : [deviceKey is used uninitialized in this function] Initialisation de la variable lors de la déclaration.
    [DeviceKey.c]
2023-11-09 COOLER RUNNING TIME (Correction warning) : Retrait de déclaration de variables inutilisés
2023-11-09 ajout des sources pour calcium640D (pour l'instant ce sont des copies des sources du blackbird1920D)
    [compile.cfg, library.cfg, projlib.cfg]
2023-11-10 ajout de afpa_dyn_range_ctrl au workspace Active-HDL
    [compile.cfg]
2023-11-13 revert du commit accidentel précédent
    [compile.cfg]
2023-11-13 AFPAs: mention explicite de la direction du port de config FPA dans le sous-module de MMCM
2023-11-15 Correction des version.txt suite du précédent commit
2023-11-15 ajustement de phase pour le filtre M2kUD01DK
2023-11-16 ajout module calcium_services et son testbench
    [compile.cfg, library.cfg, projlib.cfg]
2023-11-21 M2kUD: activation de l'écrêteur
2023-11-23 M2kUD: l'écrêteur ne fait plus de transformation linéaire
2023-12-06 CAL (Bugfix temporaire) : On gate le signal cal_block_index_valid avec le cal_en avant de l'envoyer dans le calibration core. La solution finale sera intégrée par JDE lorsque optimisation des BRAMs r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
2023-12-13 build hw (tous les startups)
2023-12-13 tous les FPAs: introduction de la constante FPA_EXPOSURE_TIME_RESOLUTION pour l'AEC
2023-12-14 Update FirmwareReleaseScript.tcl : ajout de délai et des catch pour mieux traquer les erreurs
2023-12-14 ajout de sources pour le calcium
    [compile.cfg]
2023-12-14 sensor 31 réservé pour le dummy software
2023-12-22 Don't wait the end of the first frame to start combining kpix, the first frame is always complete thus the first pixel received is addressed correctly by the kpix_bramaddr
2023-12-22 prendre un fifo d'une largeur de 76 parce que l'IP existe déjà
2024-01-08 revert du test temporaire de release précédent
2024-01-10 Add KPIX files to Active-HDL Workspace
    [compile.cfg]
2024-01-10 Oubli de l'IP ip_axis32_reg pour le FPGA 160T dans le commit précédent
2024-01-11 ajout des sources calcium au design Active-HDL
    [compile.cfg]
2024-01-11 calcium en travail
    [compile.cfg]
2024-01-11 calcium: ajout de la compression (simple troncature pour l'instant)
2024-01-18 revert du test temporaire de release
2024-01-22 build hw (tous les FPAs excepté calcium et isc0804A_2k)
2024-01-23 flash driver can access to 16 Gb, correction posix time with NDF position
    [Actualization.c, Calibration.c, DT_CommandsDef.c, FileManager.c, FileManager.h, FlashDynamicValues.c, FlashDynamicValues.h, GC_Poller.c]
2024-01-25 Modification à la procédure de relâche pour éviter des problème d'incohérence de buildinfo. Dorénavant, les trois firmwares FPGA devront être relâchés dans le même release (exécution de FirmwareRelea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
2024-01-25 ajustement de phase pour M2kUD
2024-01-26 bugfix pour l'écrasement du ET en mode raw avec une calibration multipoint (#36940)
    [calib.c]
2024-01-29 isc0804A_2k: déplacement d'un bloc de code de debug pour éviter un problème bizarre de GIGE
2024-02-05 Ménage des listes de compilation: - DCI 13190: firmwares marsD, scorpiolwD et scorpiomwD ne sont plus compilés - seul le FPGA_SIZE usuel est conservé
2024-02-08 isc0804A_2k: correction d'une violation potentielle de CDC sur le signal FPA_READOUT
2024-02-13 ajout d'un generic pour la valeur en Idle de la pin SD (aucun changement fonctionnel)
2024-02-14 Flash Settings v2.15.0: ajour des champs pour le déphasage par quad (M2kUD)
2024-02-14 isc0804A_2k: utilisation des nouveaux flash settings
2024-02-19 ajout des sources de fastrd2 dans le projet Active-HDL
    [compile.cfg]
2024-02-19 isc0804A_2k: affichage d'un refdes dans le BDE du contrôleur de readout
2024-02-19 isco0804A_2k: compilation en VHDL-2008 du package de testbench
2024-02-20 Correction startActualization erreur dans comparaison
    [Actualization.c]
2024-02-21 calicumD: ménage des constantes de define
2024-02-21 calicumD: standardisation des calculs d'exposure time
2024-02-22 isc0804A_2k: maj du testbench
    [compile.cfg]
2024-02-26 correction des commentaires des températures d'opération min et max des FPA
2024-02-26 calibration_core.bde now support compressed pixel data, still need to add compression/decompression ratio signals
2024-02-26 calciumD: pas besoin de conversion d'exposure time plus qu'il est déjà en clk 100M
2024-02-26 calciumD: testbench à jour
    [compile.cfg]
2024-02-26 calcium640D: copie des sources de simulation pour un testbench Vivado
2024-02-27 calciumD: ajout des modes: - use_ext_pixqnb pour config vPixQNB à l'interne ou à l'externe - clk_frm_pulse_width pour config du pulse width CLK_FRM
2024-02-28 calciumD: - génération d'un ROIC_INIT_DONE pour remplacer PROG_INIT_DONE - ajout de l'interface avec les SERDES
2024-03-01 Il est possible de choisir le fichier sth à lire en changeant le pwd avant de sourcer le script. Le fichier sth dans le pwd sera utilisé. Maintenant les fichiers xci sont ajouté au projet Vivado au l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
2024-03-01 calciumD: calcium_services
    [compile.cfg]
2024-03-11 calciumD: retrait de DIAG_MODE_EN
2024-03-12 ajout du BDE du contrôleur de saturation au projet Active-HDL
    [compile.cfg]
2024-03-13 isc0804A_2k: nouvelle consigne de VOUTREF pour correspondre avec la plage dynamique tronquée
2024-03-13 isc0804_2k: nouvelle valeur par défaut pour REF1 du correcteur électronique pour correspondre au blank modifié
    [fpa_intf.c]
2024-03-13 isc0804A_2k: valeur cible (starvation) de la correction électronique replacée à la valeur nominale M1k (à valider)
    [fpa_intf.c]
2024-03-14 ajout du BDE de afpa_quad_div au projet Active-HDL
    [compile.cfg]
2024-03-20 ajout de la documentation du correcteur électronique
2024-03-21 - récupération de la FPA_INTF_CFG par le fpa_status_gen (il reste à coder la fonction spécifique dans chaque FPA/Proxy_define) - ajout commande FPACFG dans le debug terminal qui fait un print de la F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
2024-03-21 version simplifiée de r30109 pour faciliter les copier-coller
2024-03-27 ajout du modèle d'erreur à la doc du correcteur électronique
2024-03-28 isc0804A_2k: avec le dernier ajustement de phase, RegF doit passer à 15.
2024-03-28 Add COMPRESSED generic to calibration.bde
2024-04-05 Add de/compression ratio registers to calib_config.vhd
2024-04-09 draft Calibration Files v2.6.0
2024-04-17 calcium640D: correction calcul ETmax
    [fpa_intf.c, fpa_intf.h]
2024-04-18 la commande CCM dans le debug terminal peut allumer la LED de warning
2024-04-18 calciumD: correction ordre des pixels à la sortie des FIFO
2024-04-19 ajout des infos de compression et de KPix dans la calibrationInfo
2024-04-19 correction r30247: FPA_SetWarningLed définie pour tous les FPA
    [fpa_intf.c, fpa_intf.h]
2024-04-22 calcium640D: correction data dispatcher. Il y avait décalage dans le FIFO pendant les SERDES_TRIG puisque ce sont des FPA_INT sans readout.
2024-04-24 isc0804A_2k: utilisation des FS 2.16.0
2024-04-24 correctif pour le #endif effacé par erreur à la rev30109
    [fpa_intf.h]
2024-04-25 calcium640D: meilleure gestion des délais notamment en prenant compte du diag mode
2024-04-26 écriture des champs de compression et décompression dans la calibration
2024-04-26 correction écriture des float par AXIL (r30278)
    [calib.c]
2024-04-29 uniformisation du DATA_PATH_STAT pour tous les fpa
2024-04-29 isc0804A_2k: bugfix pour la mauvaise application de la phase initiale des horloges ADC (#39603)
    [fpa_intf.c]
2024-04-30 calciumD: refonte des erreurs du data ctrl
2024-04-30 calciumD: amélioration de la gestion du mode debug des KPix
2024-05-03 calciumD: amélioration de la gestion du mode debug du compression ratio
2024-05-06 ajout du nbits_deserializer au design Aldec
    [compile.cfg]
2024-05-08 ajout de FPABinningConfig.h à tous les projets avec un lien relatif
2024-05-09 isc0804A_2k: correction du merge de binning
    [fpa_intf.h]
2024-05-10 Calibration files v2.6.0 final commit
2024-05-14 isc0804A_2k: correctif pour le bug d'offset en sous-fenêtre (#39666) (compensation du décalage interne du ROIC pour application du changement d'horloge lors de la sortie de la zone AOI)
    [fpa_intf.c]
2024-05-14 ajout de fastrd2 au projet Active-HDL
2024-05-15 ajout printf du load des KPIX data
2024-05-25 isc0804A_2k: correctifs supplémentaires pour les offsets en sous-fenêtre (#39666) - On doit protéger le LSYNC un cycle avant sinon cela cause un offset sur toute la ligne - On doit mettre des cycles 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
    [fpa_intf.c, fpa_intf.h]
2024-05-28 Fix typo and print
    [DT_CommandsDef.c, fpa_intf.c]
2024-05-28 isc0804_2k: ajustement aux calculs de frame rate suite au bugfix des offsets en sous-fenêtre (#39666)
    [fpa_intf.c]
2024-05-28 isc0804_2k: contournement temporaire pour l'incrément de largeur (forcé à 64)
2024-05-28 calcium_prog_ctrler en travail
    [compile.cfg]
2024-05-29 Correction set Width_inc dans GC_UpdateImageLimits + revert patch
    [GC_Registers.c, fpa_intf.h]
2024-05-30 gestion des champs DeviceStabilizationTime et DeviceStabilizationDeltaTemperature pour rapporter le temps de cooldown et ΔT (DCI 13 084)
2024-06-01 start du timer tic_cooldownStability remis dans l'état ACQ_WAITING_FOR_SENSOR_TEMP (DCI 13 084)
2024-06-10 procédure de relâche met à jour BDFirmware
2024-06-11 corrections oubliées pour calcium et m2kud
    [fpa_intf.h]
2024-06-13 isc0804_2k: ajout des prints de config FPA manquants
2024-06-21 Maj FileManager: ajout estimation taille fichier avant écriture Correction binning: update calibration register et actualisation header
    [Actualization.c, CalibBlockFile.h, FileManager.c, GC_Registers.c]
2024-06-21 isc0804A_2k: bugfix pour #40526
    [fpa_intf.c]
2024-06-27 isc0804A_2k: bugfix pour les 32 derniers pixels qui comportaient un offset différent (#40691)
2024-06-28 calciumD: ajout d'un signal RESET_ROIC_RX_DATA pour effacer la réponse reçue du ROIC et s'assurer qu'il n'y a pas de mismatch dans les requêtes
2024-06-28 - correction de la vérification des valeurs d'argument dans les commandes ADC, XRO et CCM - ajout de la commande CCMREG pour lire et écrire les registres du calcium
    [DT_CommandsDef.c, fpa_intf.c]
2024-06-29 hder: statuts d'erreur manquants dans le header inserter
2024-07-04 calciumD: FRAME_RATE_MIN passé à 100 puisque la calibration des SERDES se fait toujours à ETmin et FRmax
2024-07-05 calciumD: version préliminaire de la programmation complète des registres du ROIC FPA_GetStatus et FPA_PrintConfig avec des pointeurs (sauve environ 1000 bytes) ajout fichier excel pour générer du co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
    [Code registres.xlsx]
2024-07-08 calciumD: correction du FPA_DEVICE_MODEL_NAME
    [FileManager.c, fpa_intf.h]
2024-07-08 calciumD: regI pour activer/désactiver les DSM
2024-07-08 calciumD: valeurs initiales calculées par des formules qui tient compte de la valeur de l'horloge
2024-07-10 isc0207A_3k: maj du testbench pour le bus 8 pix de large
    [compile.cfg]
2024-07-12 calciumD: ajout de la programmation du temps d'intégration
2024-07-12 calciumD: pour simplifier les calculs dans le VHD on oblige ClkCore = ClkCtrlDSM
2024-07-16 calciumD: ajout d'un mode de bypass de la compression
2024-07-16 calciumD: utilisation de la valeur courante de CLK_DDR plutôt que le define
2024-07-16 masque de fausses erreurs en simulation
2024-07-17 ajout du BDE de cropping au projet Active-HDL
2024-07-18 mise à jour du testbench de isc0207_3k
2024-07-18 isc0207A_3k: correctifs pour le plantage lors de l'expérience de déphasage - passage au SERDES/Data Controller v2 - clockgen qui utilise la phase dynamique (économie de 10K LUTs et 1k FFs)
2024-07-18 isc0207A_3k: correctif pour le sample pulse ADC décalé temporellement par erreur
2024-07-19 isc0207A_3k/isc0804A_2k: oubli du générique de l'inversion vidéo suite au passage au SERDES v2
2024-07-19 calciumD: meilleur traitement des modes de debug
2024-07-19 ajout d'un define CALCIUM_PROXY pour le code spécifique au calciumD dans les parties communes
2024-07-22 calciumD: lecture du feedback du ROIC dans la boucle du main pour éviter les timeouts
2024-07-22 activation du module de correction d'offset pour isc0804A_2k (non généré pour les autres AFPAs dans le moment)
    [compile.cfg]
2024-07-23 isc0207A_3k: déphasage préliminaire pour la méthode des bad pixels (à confirmer par la méthode de la scène en Y)
2024-07-23 isc0207A_3k: application de la DCI 13 251
2024-07-23 isc0804A_2k: activation de la correction d'offset seulement pour les sous-fenêtres
    [fpa_intf.c]
2024-07-24 isc0207A: application de la DCI 13 251
2024-07-24 correction de printf
2024-07-25 calciumD: - ajout de la programmation des timings DSM - correction de l'ExposureTime avec une valeur arrondie supportée par le FPA
    [DT_CommandsDef.c, GC_Callback.c, GC_Registers.c, fpa_intf.c, fpa_intf.h]
2024-07-25 xro3503A: CTIA bias current enum passe à 10 par défaut à cause du problème de franges (#36949)
2024-07-25 calcium640D: build pour le firmware de démo
2024-07-25 calciumD: correction calcul de la DSMPeriod
2024-07-26 isc0207A_3k: légère optimisation de la phase par la méthode de la scène en Y (valeur à mettre dans la base de données IRCAM comme la DCI 13 251 est déjà activée pour ce modèle)
2024-08-06 enlève des define inutilisés
2024-08-16 xro3503A: merge de r30198 de la branche "2024-04-11 - debug S1K"
2024-08-19 mockfpa: suppression des erreurs de compilation (merge du binning)
2024-09-12 On commente les prints de debug de la FPA_SendConfigGC() qui causait plusieurs bugs étrange
    [fpa_intf.c]
2024-09-12 calciumD: debug gestion ET: - retrait des registres ET/DSM de la config du pilote - retrait des config xtra_trig_int_time et prog_trig_int_time
    [Code registres.xlsx]
